dohny1/kicad_libs/3dmodels/_SMD_CON_3D/User Library-SMA_142-0701-851_ASSY.STEP

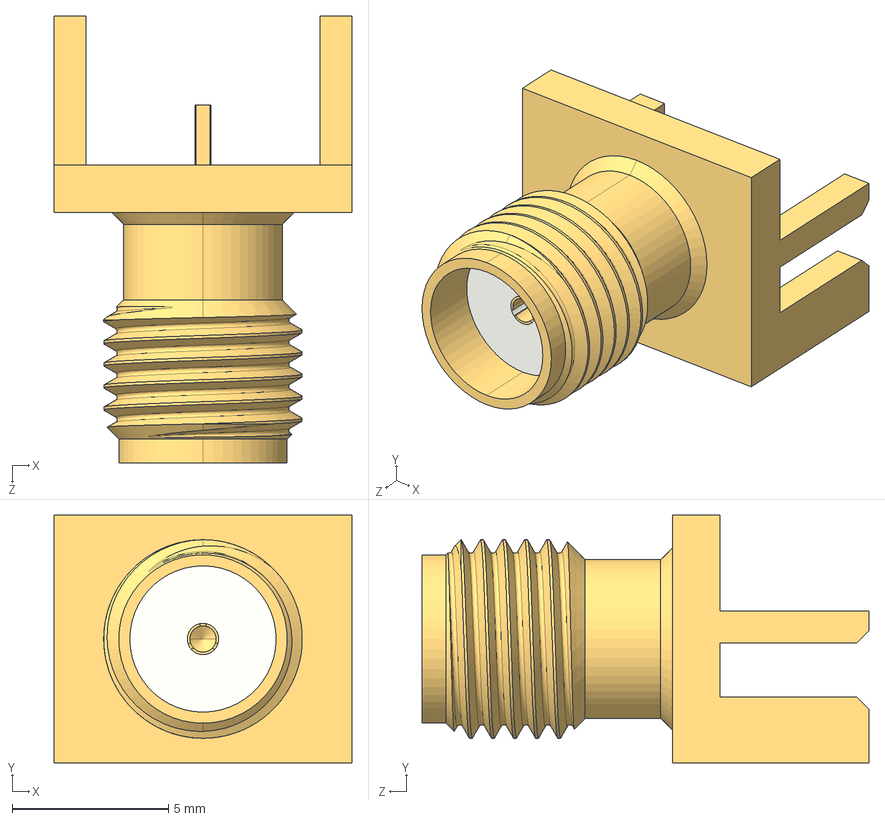
[picture p1: CAD file, 2024-12-15]
3dmodels/_SMD_CON_3D/User Library-SMA_142-0701-851_ASSY.STEP
9.53 x 7.92 x 14.3 mm
BASIC_SMA_142-0701-851
SMA_142-0701-851_INSULATOR
SMA_142-0701-851_CONTACT
