dohny1/kicad_libs/3dmodels/_SMD_SEMI_3D/User Library-IPC QFP-fullQFP50P1200X1200X120-64N MS-026ACD SU-64-2.STEP

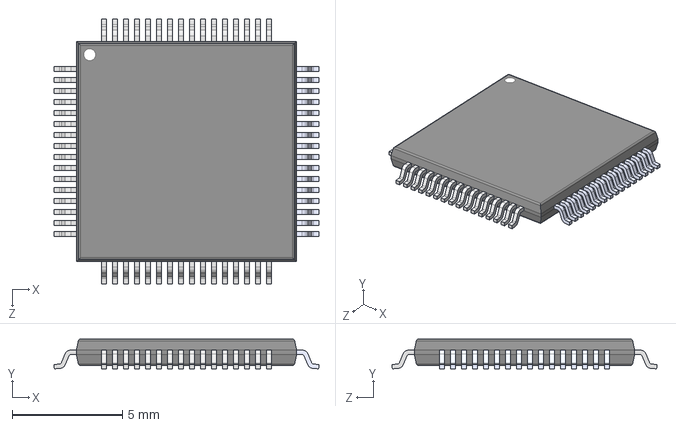
[picture p2: CAD file, 2024-12-15]
3dmodels/_SMD_SEMI_3D/User Library-IPC QFP-fullQFP50P1200X1200X120-64N MS-026ACD SU-64-2.STEP
12.0 x 1.35 x 12.0 mm
