dohny1/kicad_libs/3dmodels/_PASSIVES_3D/Coilcraft-MA5632-AL.STEP

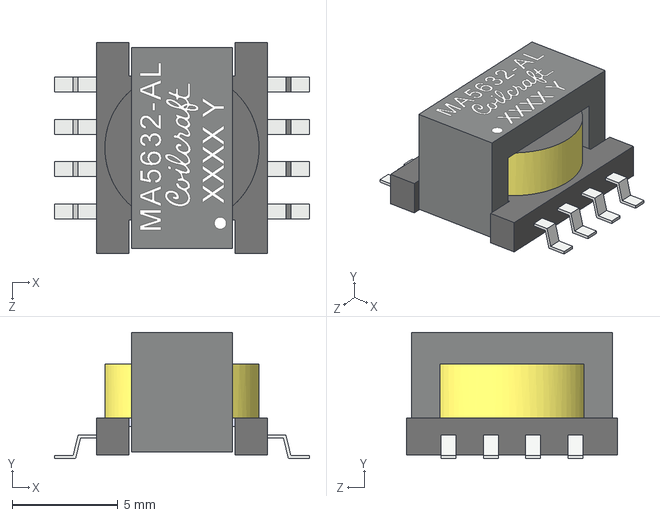
[picture p3: CAD file, 2024-12-15]
3dmodels/_PASSIVES_3D/Coilcraft-MA5632-AL.STEP
12.1 x 5.97 x 10.0 mm
