dohny1/kicad_libs/3dmodels/_SMD_CON_3D/User Library-EVQP7-LC-01P.step

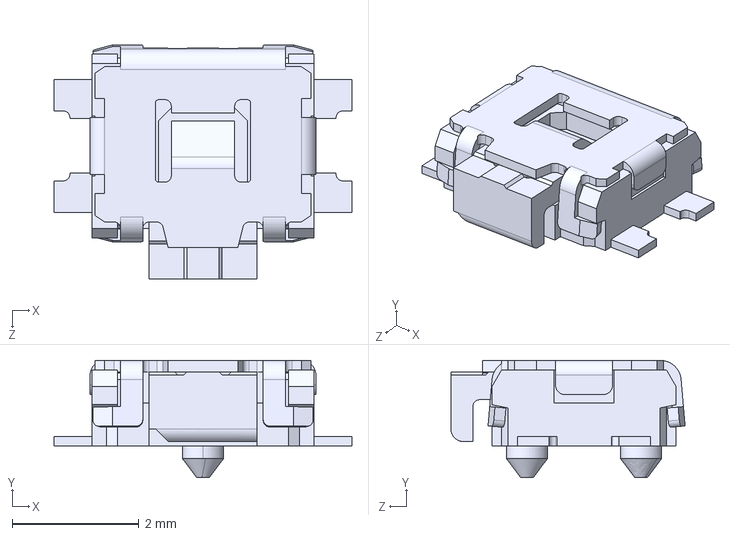
[picture p4: CAD file, 2024-12-15]
3dmodels/_SMD_CON_3D/User Library-EVQP7-LC-01P.step
4.70 x 1.85 x 3.69 mm
