dohny1/kicad_libs/3dmodels/_SMD_SEMI_3D/MSOP12_EP.step

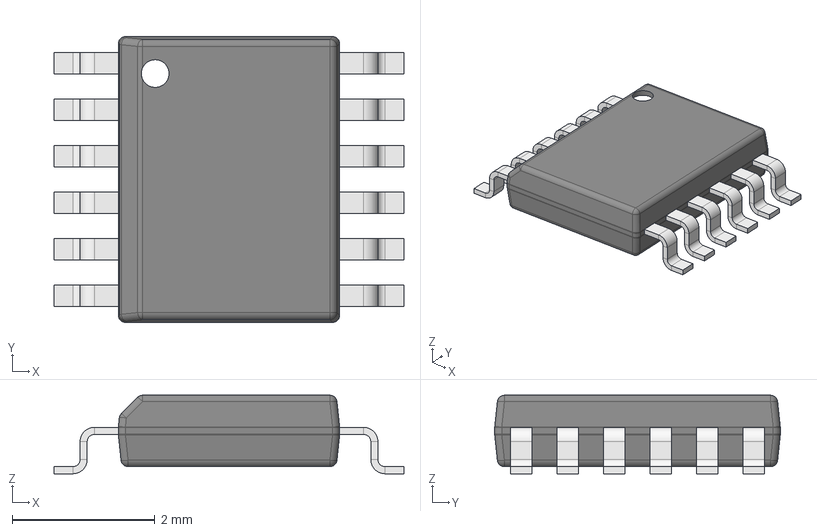
[picture p5: CAD file, 2024-12-15]
3dmodels/_SMD_SEMI_3D/MSOP12_EP.step
4.90 x 4.00 x 1.10 mm
Leader x 12
