dohny1/kicad_libs/3dmodels/_THT_3D/L-25x25.step

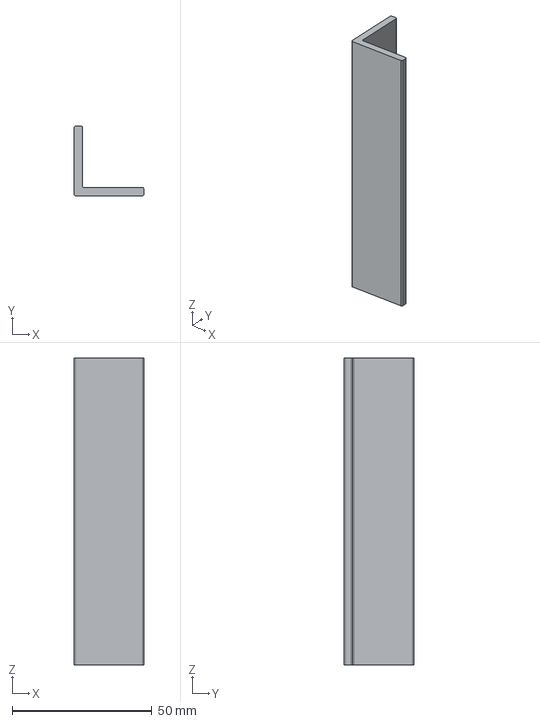
[picture p6: CAD file, 2025-02-05]
3dmodels/_THT_3D/L-25x25.step
25.0 x 25.0 x 110.0 mm
