dohny1/kicad_libs/3dmodels/_THT_CON_3D/User Library-Header_Male_6Pin.STEP

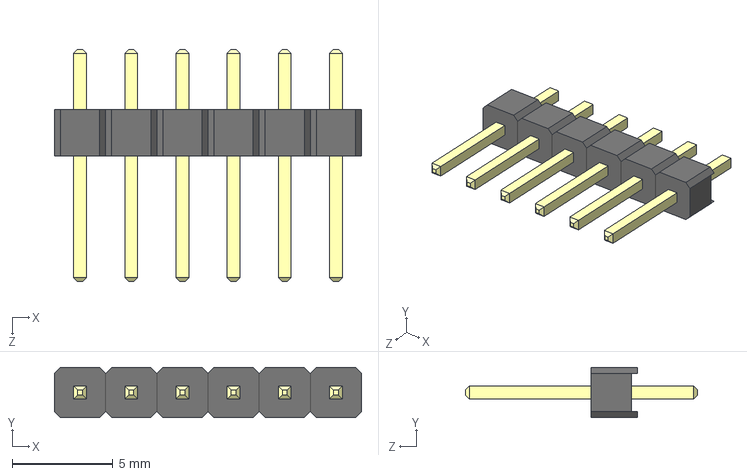
[picture p7: CAD file, 2024-12-15]
3dmodels/_THT_CON_3D/User Library-Header_Male_6Pin.STEP
15.2 x 2.49 x 11.5 mm
PinArray
BodyArray
