dohny1/kicad_libs/3dmodels/_PASSIVES_3D/Ind_Coilcraft_XAL1010-153MED_eec.STEP

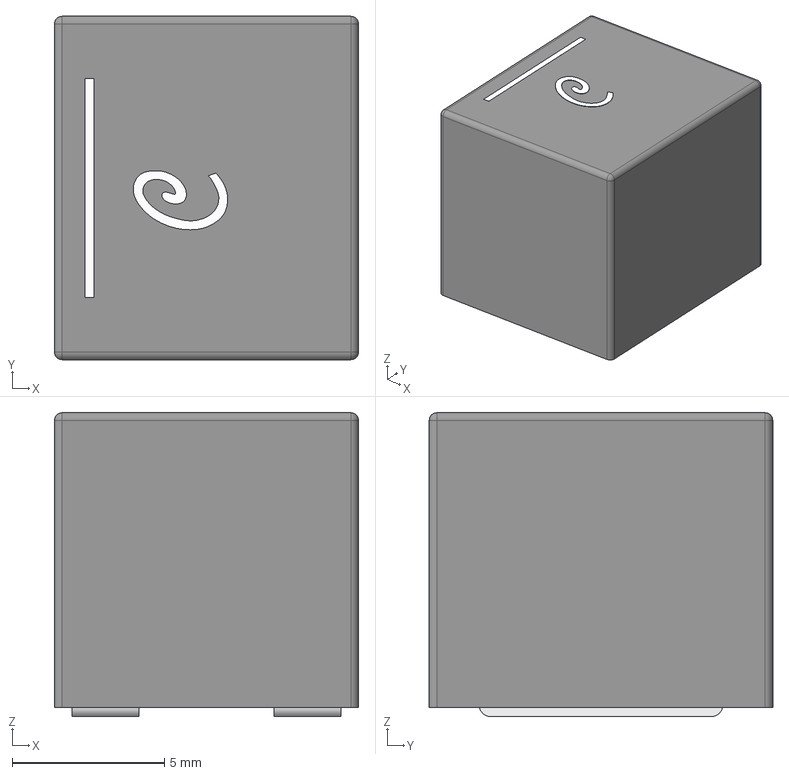
[picture p8: CAD file, 2024-12-15]
3dmodels/_PASSIVES_3D/Ind_Coilcraft_XAL1010-153MED_eec.STEP
10.0 x 11.3 x 10.0 mm
Pins
Mark
Logo
