dohny1/kicad_libs/3dmodels/_SMD_CON_3D/CircuitWorks-DIP SWITCH HALF PITCH SMD X2.step

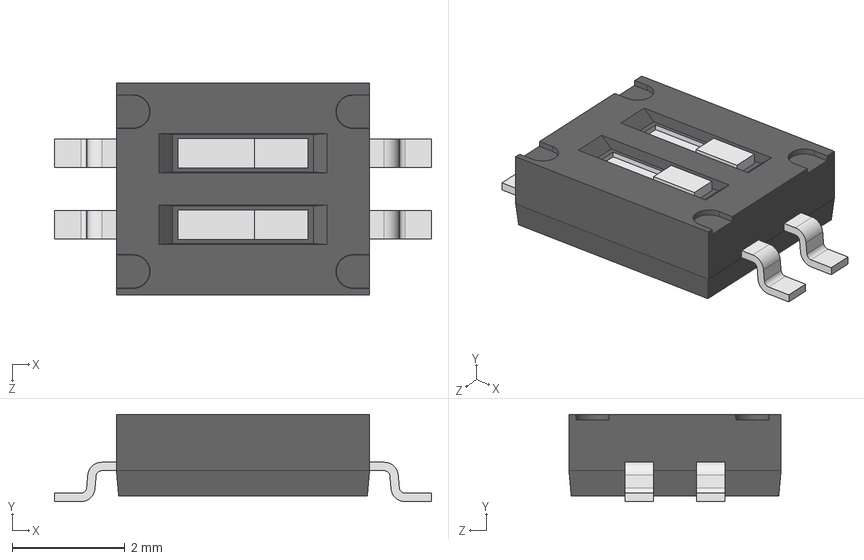
[picture p9: CAD file, 2024-12-15]
3dmodels/_SMD_CON_3D/CircuitWorks-DIP SWITCH HALF PITCH SMD X2.step
6.70 x 1.55 x 3.77 mm
