dohny1/kicad_libs/3dmodels/_SMD_SEMI_3D/BGA400_CLG.step

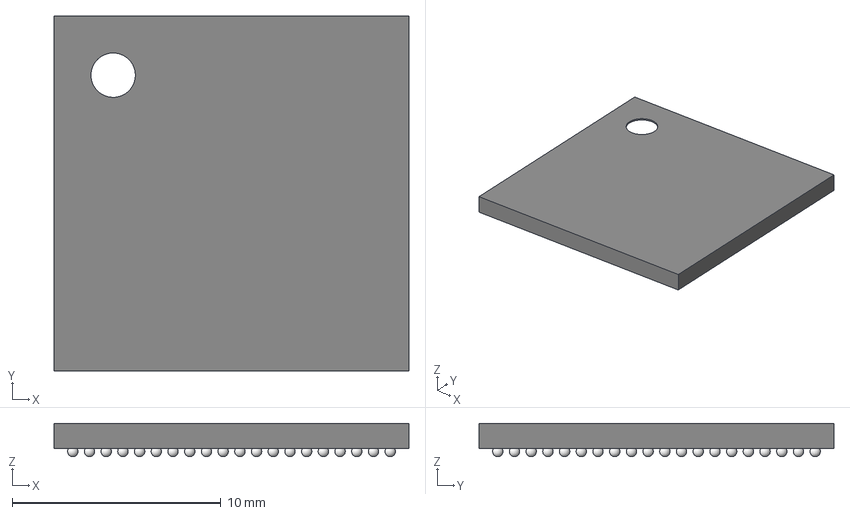
[picture p10: CAD file, 2024-12-15]
3dmodels/_SMD_SEMI_3D/BGA400_CLG.step
17.0 x 17.0 x 1.60 mm
ball x 400
