dohny1/kicad_libs/3dmodels/_THT_3D/TSF-1178Z.STEP

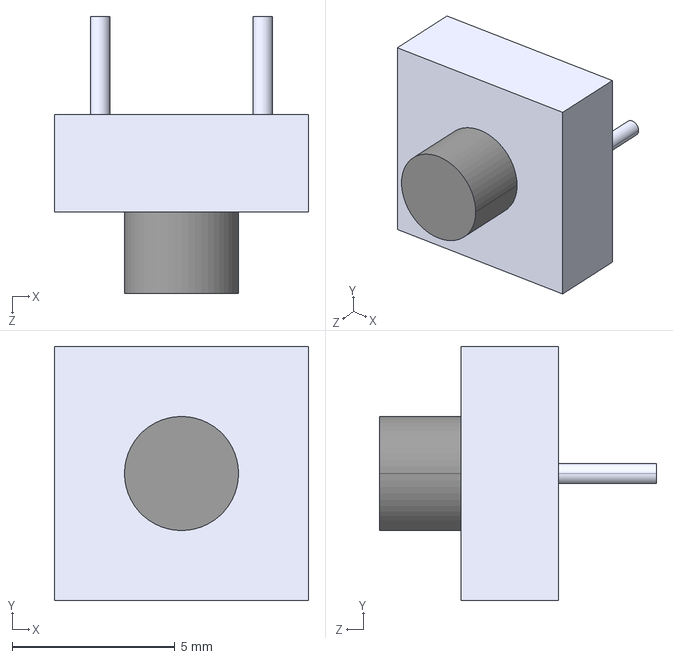
[picture p11: CAD file, 2025-02-05]
3dmodels/_THT_3D/TSF-1178Z.STEP
7.80 x 7.80 x 8.50 mm
