dohny1/kicad_libs/3dmodels/_THT_CON_3D/User Library-PJ-002AH.STEP

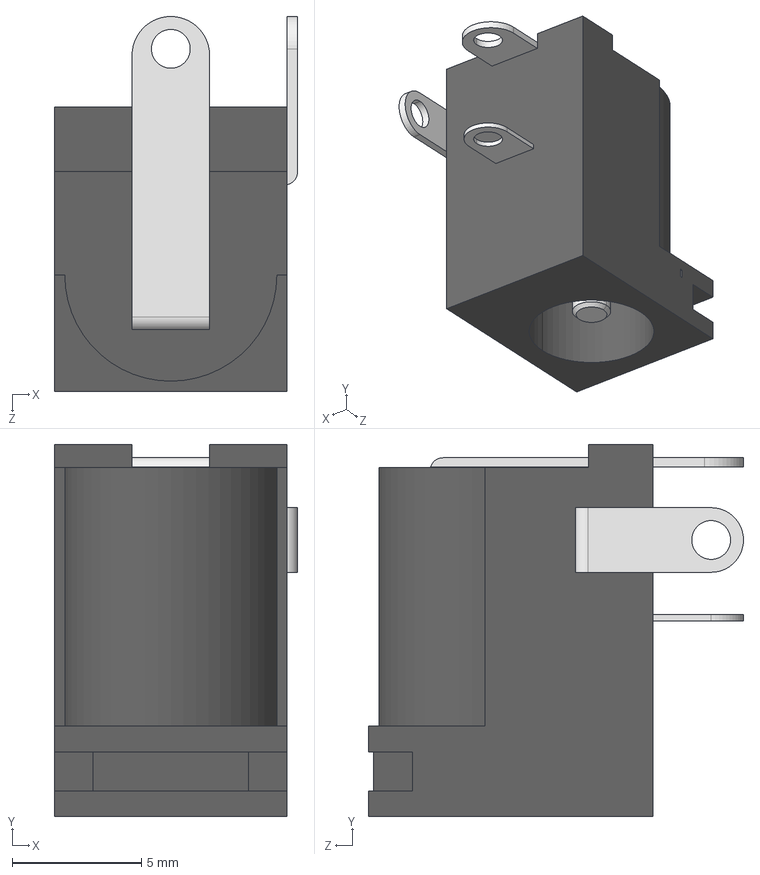
[picture p12: CAD file, 2024-12-15]
3dmodels/_THT_CON_3D/User Library-PJ-002AH.STEP
9.40 x 14.4 x 14.5 mm
User Library-PJ-002AH_Body
User Library-PJ-002AH_Pad
