dohny1/kicad_libs/3dmodels/_PASSIVES_3D/Coilcraft-PA6384-AL.STEP

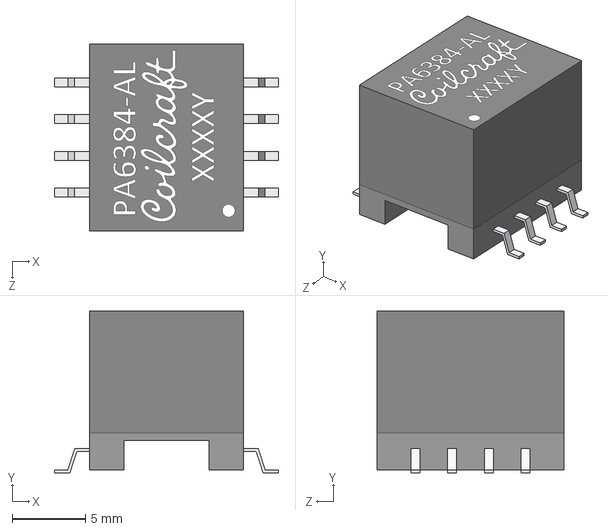
[picture p13: CAD file, 2024-12-15]
3dmodels/_PASSIVES_3D/Coilcraft-PA6384-AL.STEP
15.2 x 11.0 x 12.7 mm
