dohny1/kicad_libs/3dmodels/_SMD_SEMI_3D/QFN14_2.5_2.5.step

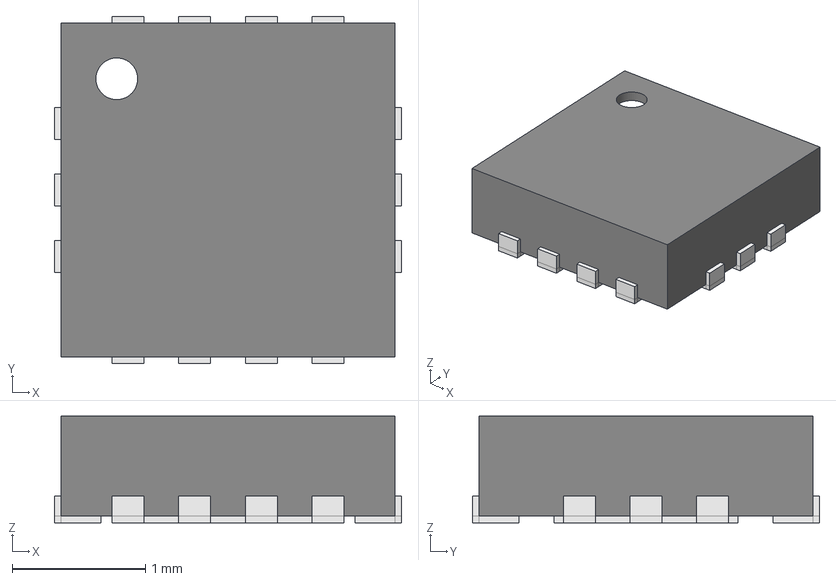
[picture p14: CAD file, 2024-12-15]
3dmodels/_SMD_SEMI_3D/QFN14_2.5_2.5.step
2.60 x 2.60 x 0.8 mm
Thermal Shape
