dohny1/kicad_libs/3dmodels/_THT_3D/D7SEG-0.56.step

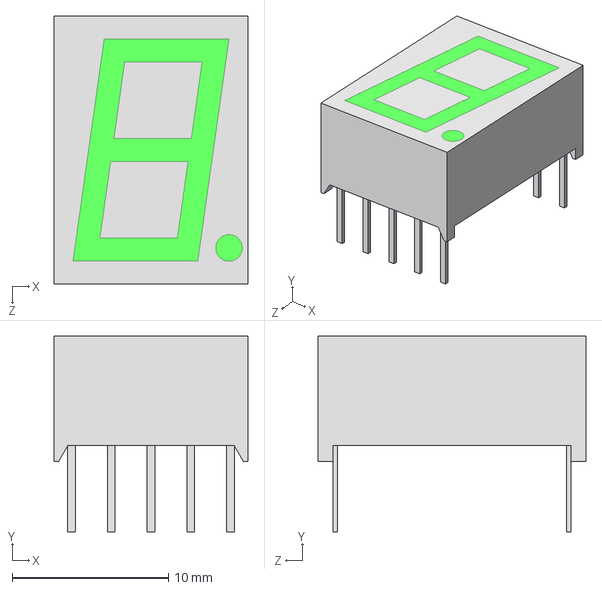
[picture p15: CAD file, 2025-02-05]
3dmodels/_THT_3D/D7SEG-0.56.step
12.4 x 12.5 x 17.1 mm
