dohny1/kicad_libs/3dmodels/_THT_CON_3D/RCA_R1.STEP

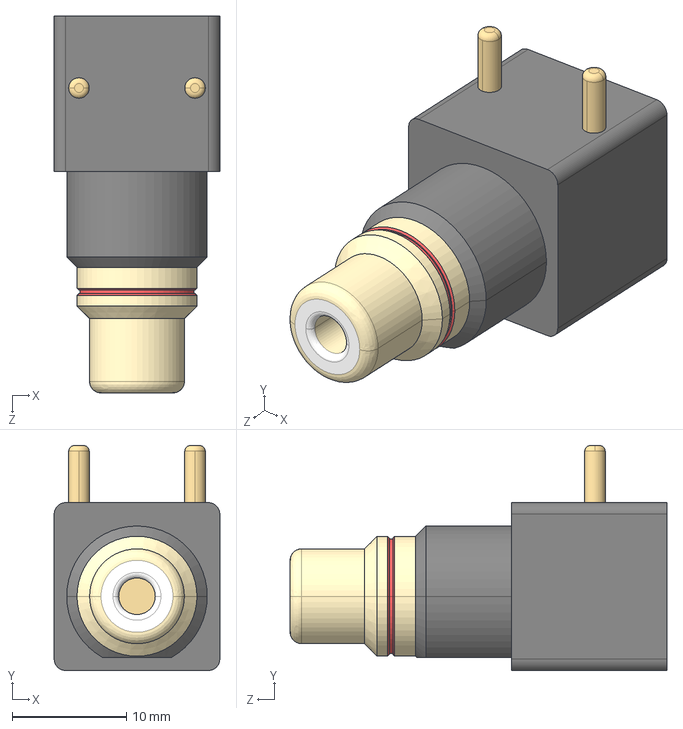
[picture p16: CAD file, 2024-12-15]
3dmodels/_THT_CON_3D/RCA_R1.STEP
14.5 x 19.7 x 33.0 mm
