dohny1/kicad_libs/3dmodels/_PASSIVES_3D/C0402.STEP

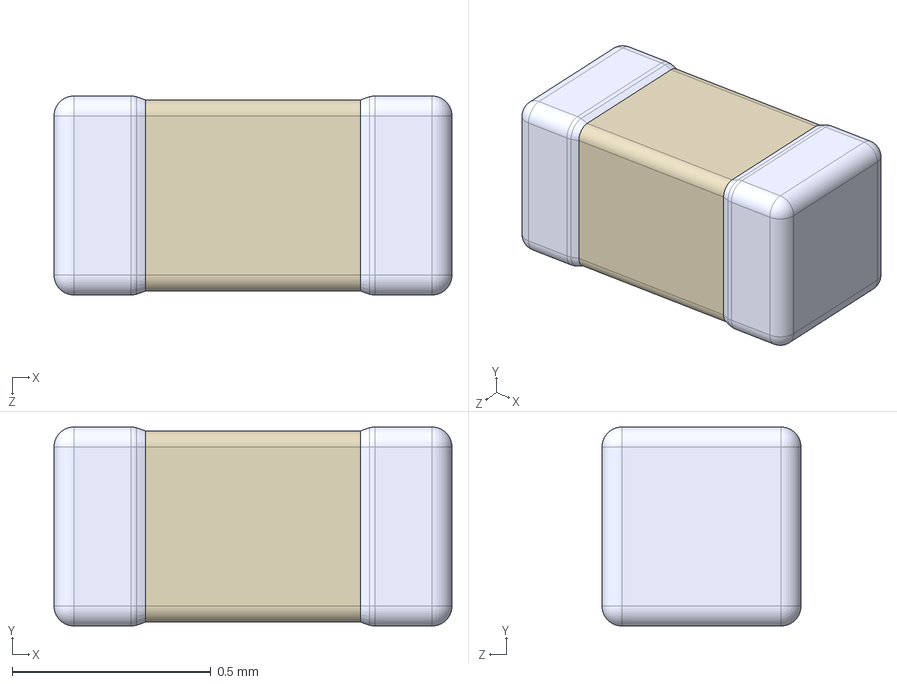
[picture p17: CAD file, 2024-12-15]
3dmodels/_PASSIVES_3D/C0402.STEP
1.00 x 0.5 x 0.5 mm
