dohny1/kicad_libs/3dmodels/_SMD_CON_3D/JST.STEP

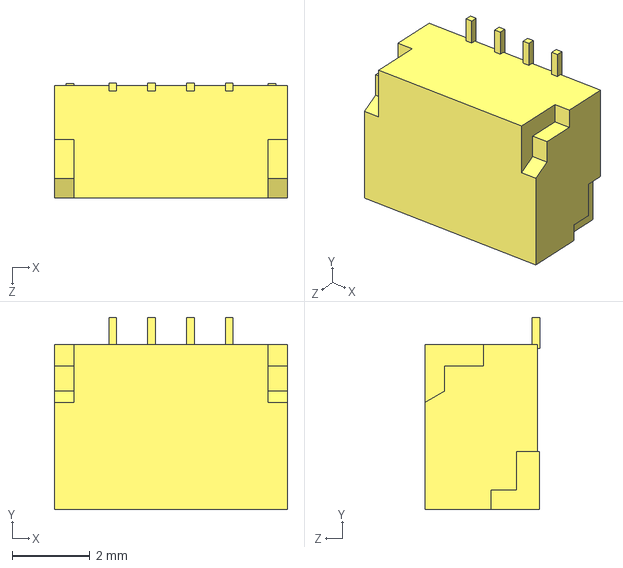
[picture p18: CAD file, 2024-12-15]
3dmodels/_SMD_CON_3D/JST.STEP
6.00 x 4.95 x 2.96 mm
