dohny1/kicad_libs/3dmodels/_SMD_SEMI_3D/User Library-QFN48_7x7.step

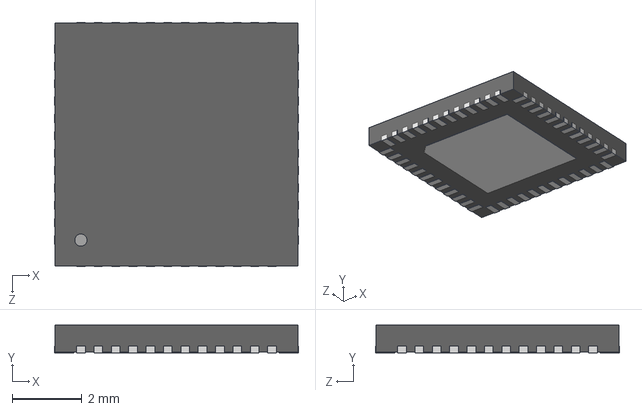
[picture p19: CAD file, 2024-12-15]
3dmodels/_SMD_SEMI_3D/User Library-QFN48_7x7.step
7.02 x 0.8 x 7.02 mm
