dohny1/kicad_libs/3dmodels/_THT_3D/RN102-x-02.stp

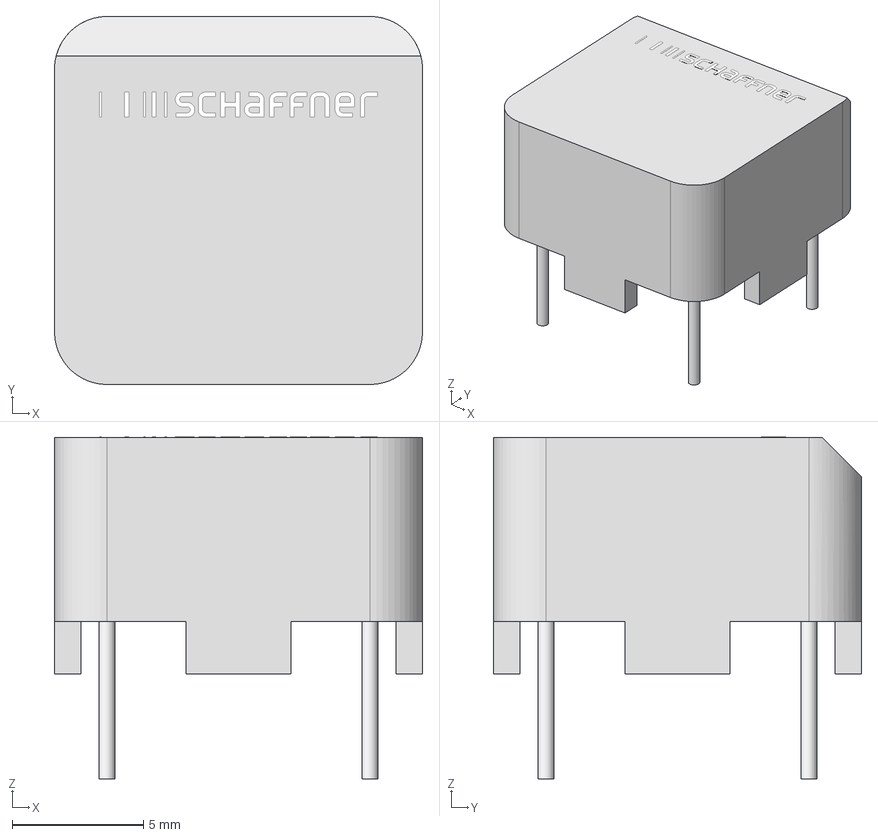
[picture p20: CAD file, 2024-12-25]
3dmodels/_THT_3D/RN102-x-02.stp
14.0 x 14.0 x 13.0 mm
