dohny1/kicad_libs/3dmodels/_THT_CON_3D/molex4pin.STEP

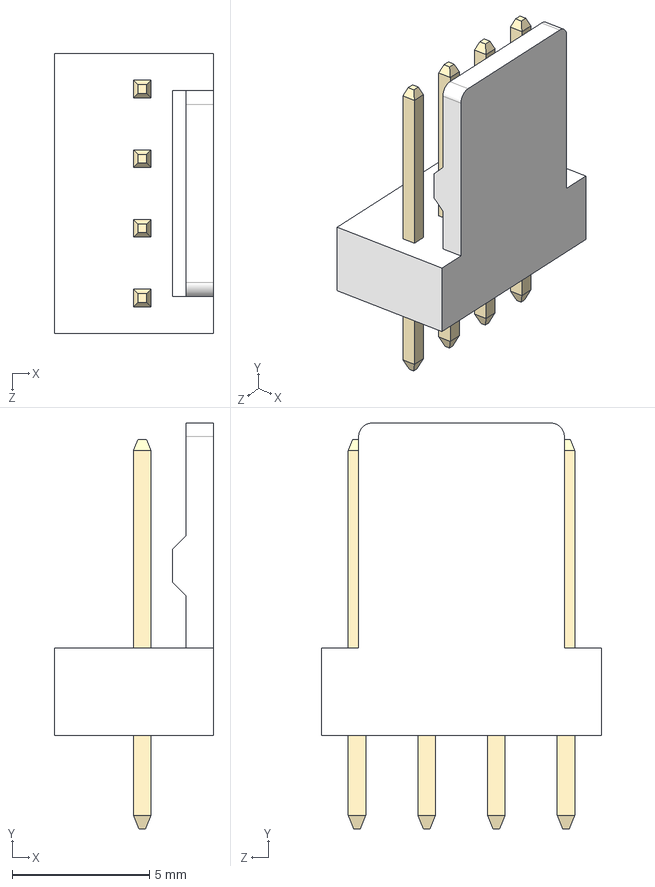
[picture p21: CAD file, 2024-12-15]
3dmodels/_THT_CON_3D/molex4pin.STEP
5.80 x 14.8 x 10.2 mm
molex_lock_4pin
contact x 4
