dohny1/kicad_libs/3dmodels/_PASSIVES_3D/User Library-ZM206.step

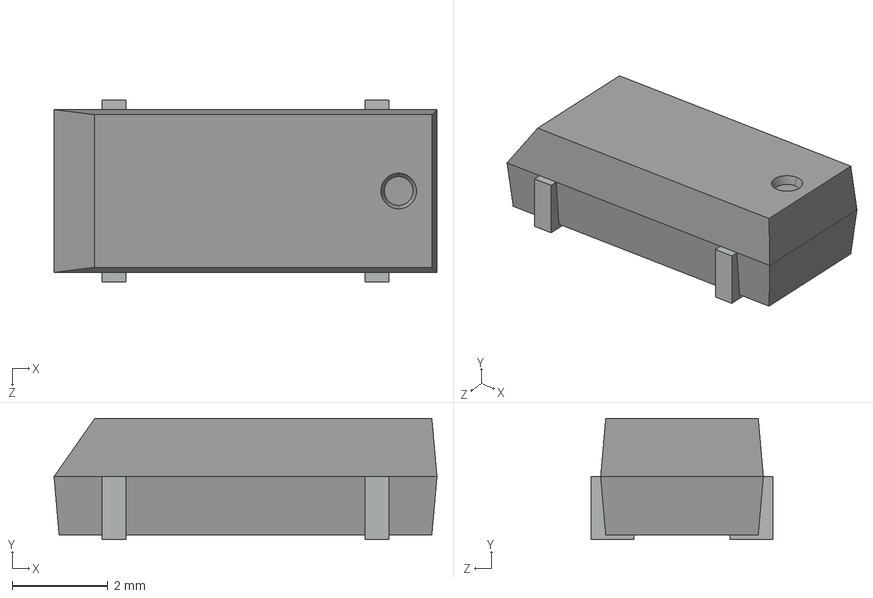
[picture p22: CAD file, 2024-12-15]
3dmodels/_PASSIVES_3D/User Library-ZM206.step
8.00 x 2.53 x 3.80 mm
