dohny1/kicad_libs/3dmodels/_SMD_SEMI_3D/DFN2020-6.STEP

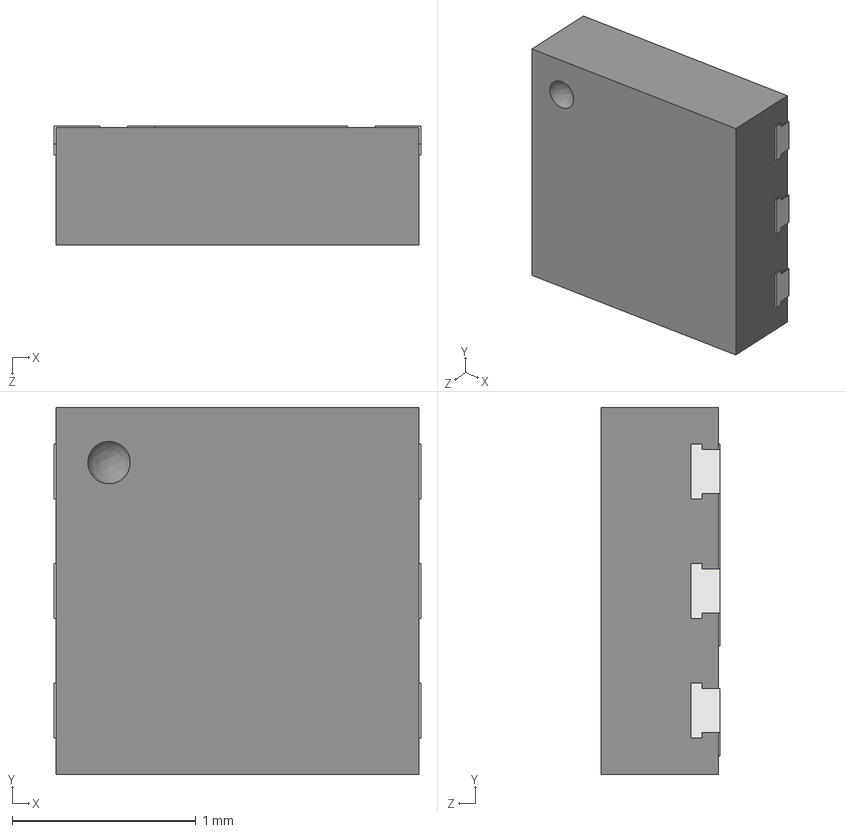
[picture p23: CAD file, 2024-12-15]
3dmodels/_SMD_SEMI_3D/DFN2020-6.STEP
2.00 x 2.00 x 0.65 mm
