dohny1/kicad_libs/3dmodels/_THT_3D/TO-92_A.stp

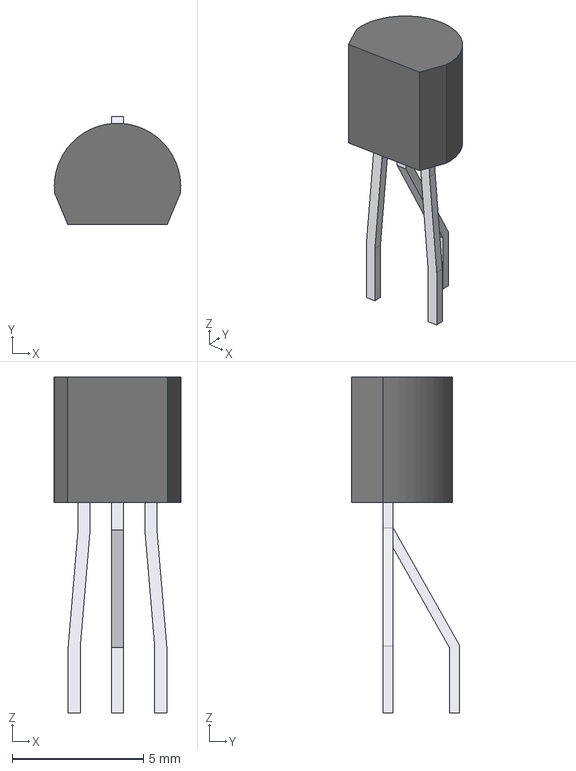
[picture p24: CAD file, 2024-12-15]
3dmodels/_THT_3D/TO-92_A.stp
4.83 x 4.12 x 12.8 mm
