dohny1/kicad_libs/3dmodels/_PASSIVES_3D/R0805_tf.STEP

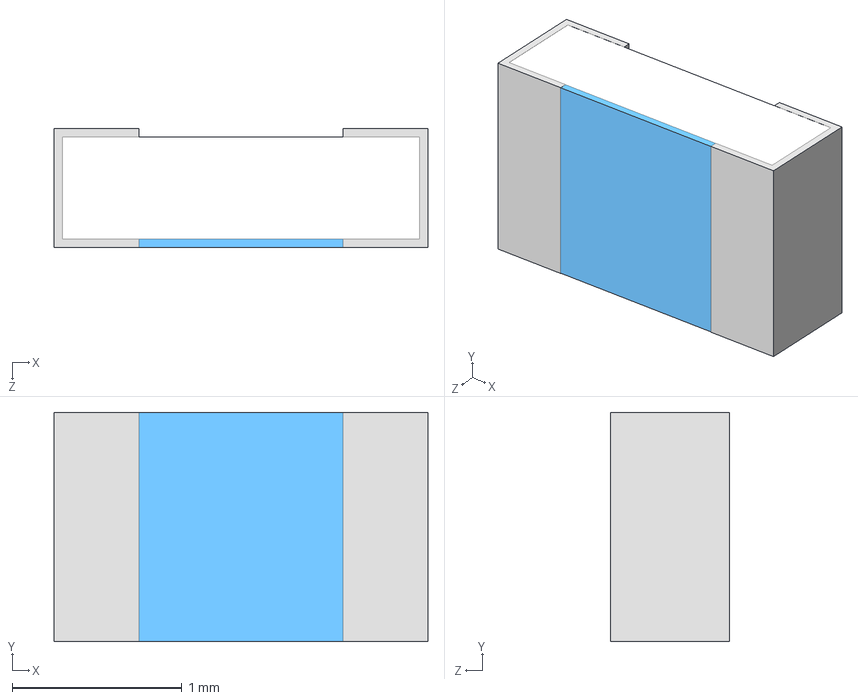
[picture p25: CAD file, 2024-12-15]
3dmodels/_PASSIVES_3D/R0805_tf.STEP
2.20 x 1.35 x 0.7 mm
