dohny1/kicad_libs/3dmodels/_SMD_CON_3D/QTE-020-01-F-D.stp

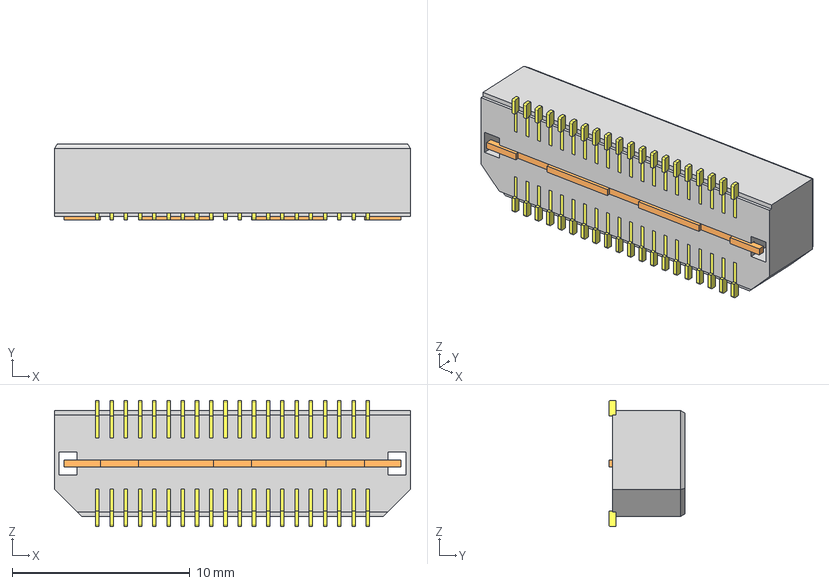
[picture p26: CAD file, 2024-12-15]
3dmodels/_SMD_CON_3D/QTE-020-01-F-D.stp
20.0 x 4.27 x 7.11 mm
_QTE-020-01-F-Dt
_PT-1S39-01(020-01-D)
_QTE-T-1G1-01_imp
