dohny1/kicad_libs/3dmodels/_SMD_SEMI_3D/QFN56_RPi.step

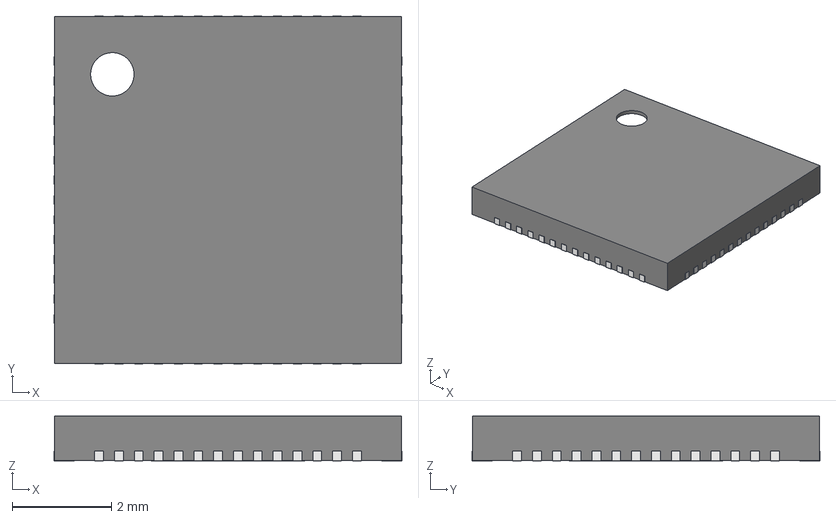
[picture p27: CAD file, 2024-12-15]
3dmodels/_SMD_SEMI_3D/QFN56_RPi.step
7.02 x 7.02 x 0.9 mm
Thermal Shape
