dohny1/kicad_libs/3dmodels/_THT_3D/User Library-DO-35G-30.step

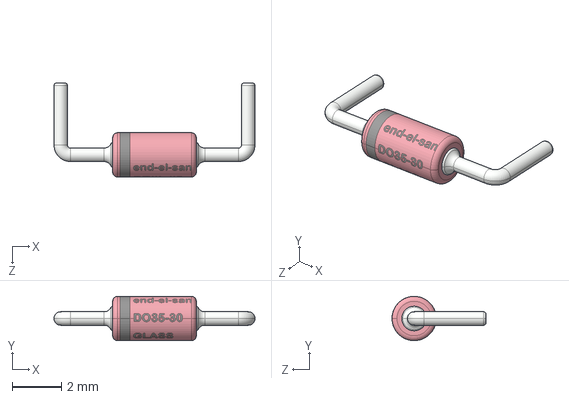
[picture p28: CAD file, 2024-12-15]
3dmodels/_THT_3D/User Library-DO-35G-30.step
8.17 x 1.80 x 3.82 mm
