dohny1/kicad_libs/3dmodels/_THT_CON_3D/PinHeader_2x05_P1.27mm_Vertical.step

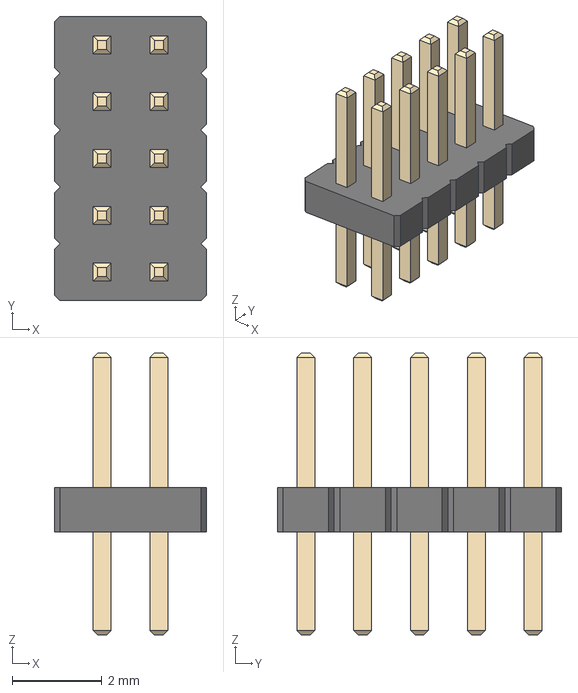
[picture p29: CAD file, 2024-12-15]
3dmodels/_THT_CON_3D/PinHeader_2x05_P1.27mm_Vertical.step
3.40 x 6.35 x 6.30 mm
