dohny1/kicad_libs/3dmodels/_PASSIVES_3D/250-1109 (rev1).STEP

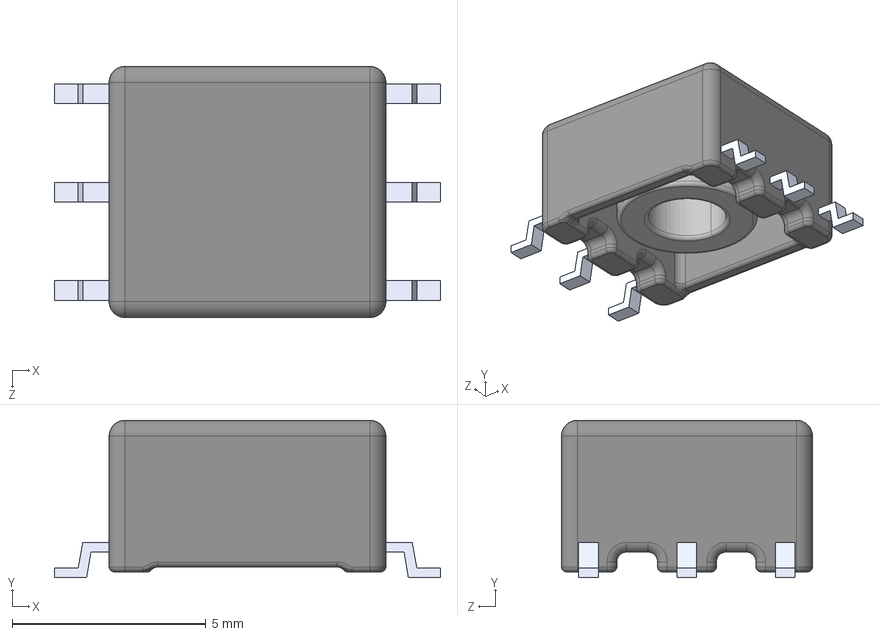
[picture p30: CAD file, 2024-12-15]
3dmodels/_PASSIVES_3D/250-1109 (rev1).STEP
9.96 x 4.06 x 6.48 mm
250-1109_6A
150-2770_6A
