dohny1/kicad_libs/3dmodels/_SMD_CON_3D/usbC_u262-16xn-4bvc11.stp

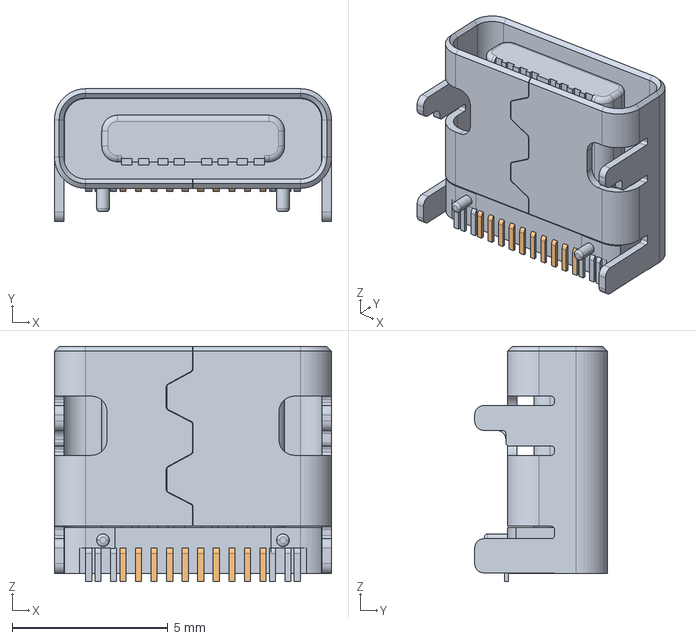
[picture p31: CAD file, 2024-12-15]
3dmodels/_SMD_CON_3D/usbC_u262-16xn-4bvc11.stp
8.90 x 4.26 x 7.56 mm
