dohny1/kicad_libs/3dmodels/_SMD_SEMI_3D/WSON8_6x5.step

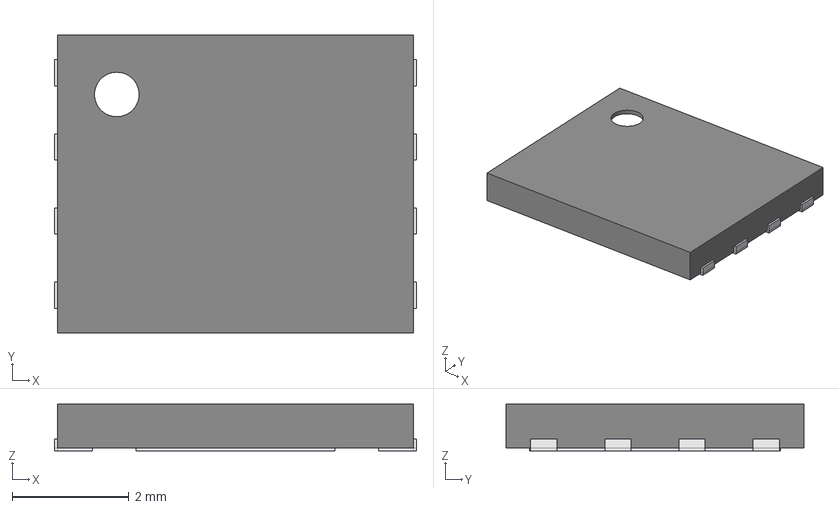
[picture p32: CAD file, 2024-12-15]
3dmodels/_SMD_SEMI_3D/WSON8_6x5.step
6.20 x 5.10 x 0.8 mm
Thermal Shape
