dohny1/kicad_libs/3dmodels/_THT_3D/User Library-Film Capacitor 13x6x12mm.step

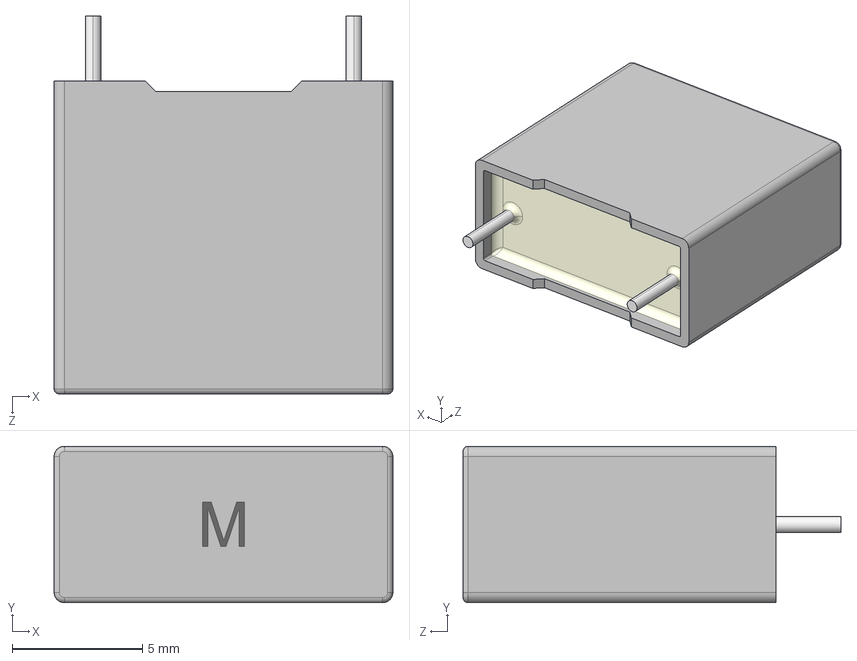
[picture p33: CAD file, 2024-12-15]
3dmodels/_THT_3D/User Library-Film Capacitor 13x6x12mm.step
13.0 x 6.00 x 14.5 mm
