dohny1/kicad_libs/3dmodels/_THT_CON_3D/pxc_1827884_08_MC-1-5-4-GF-3-81_3D.stp

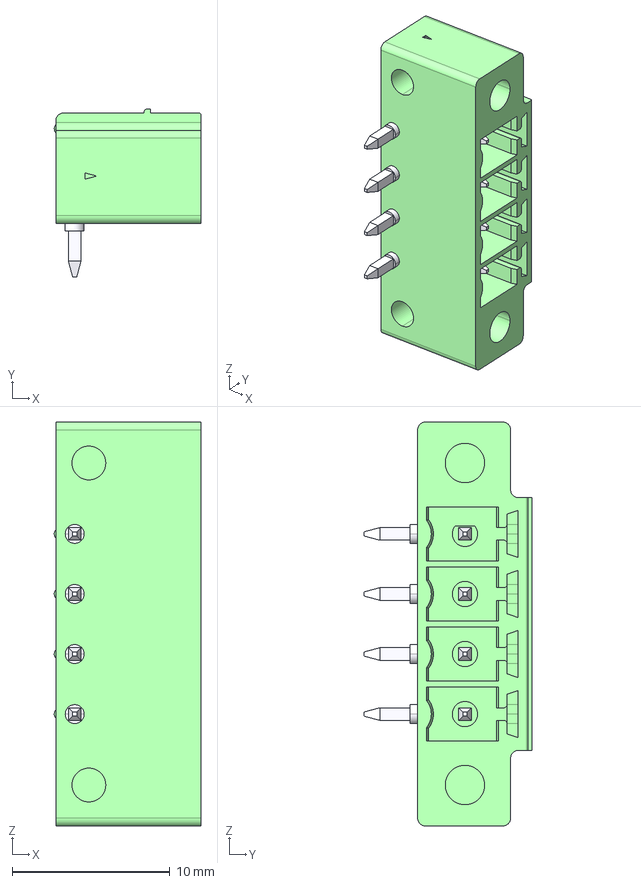
[picture p34: CAD file, 2024-12-15]
3dmodels/_THT_CON_3D/pxc_1827884_08_MC-1-5-4-GF-3-81_3D.stp
9.30 x 10.7 x 25.6 mm
