dohny1/kicad_libs/3dmodels/_PASSIVES_3D/Coilcraft-0603HP.step

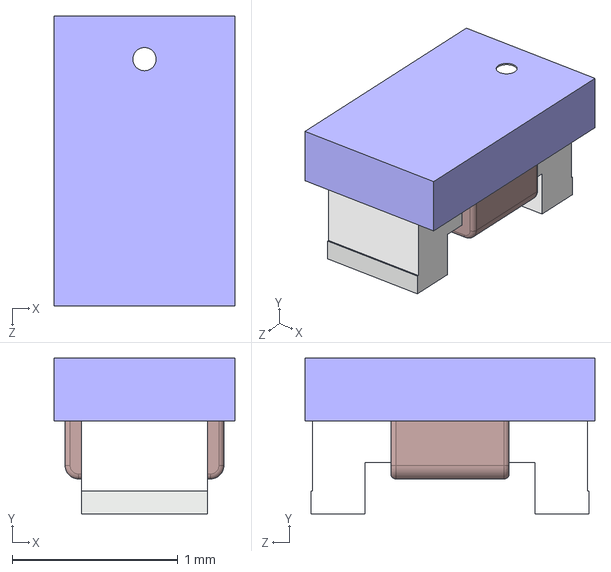
[picture p35: CAD file, 2024-12-15]
3dmodels/_PASSIVES_3D/Coilcraft-0603HP.step
1.09 x 0.94 x 1.75 mm
