dohny1/kicad_libs/3dmodels/_SMD_SEMI_3D/TSSOP30.step

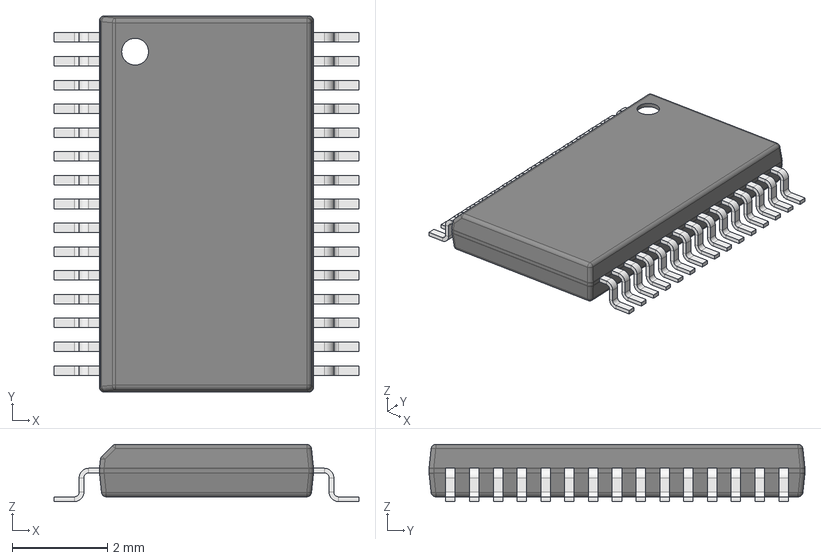
[picture p36: CAD file, 2024-12-15]
3dmodels/_SMD_SEMI_3D/TSSOP30.step
6.40 x 7.90 x 1.20 mm
Leader x 30
