dohny1/kicad_libs/3dmodels/_THT_3D/RES1016-720X250.stp

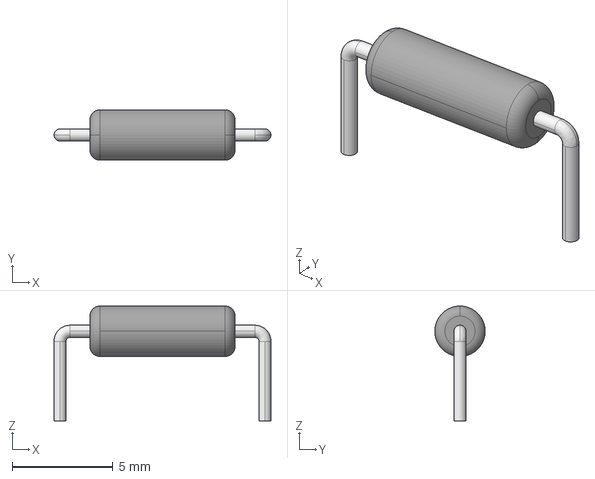
[picture p37: CAD file, 2024-12-15]
3dmodels/_THT_3D/RES1016-720X250.stp
10.8 x 2.50 x 5.70 mm
