dohny1/kicad_libs/3dmodels/_THT_CON_3D/molex2pin.STEP

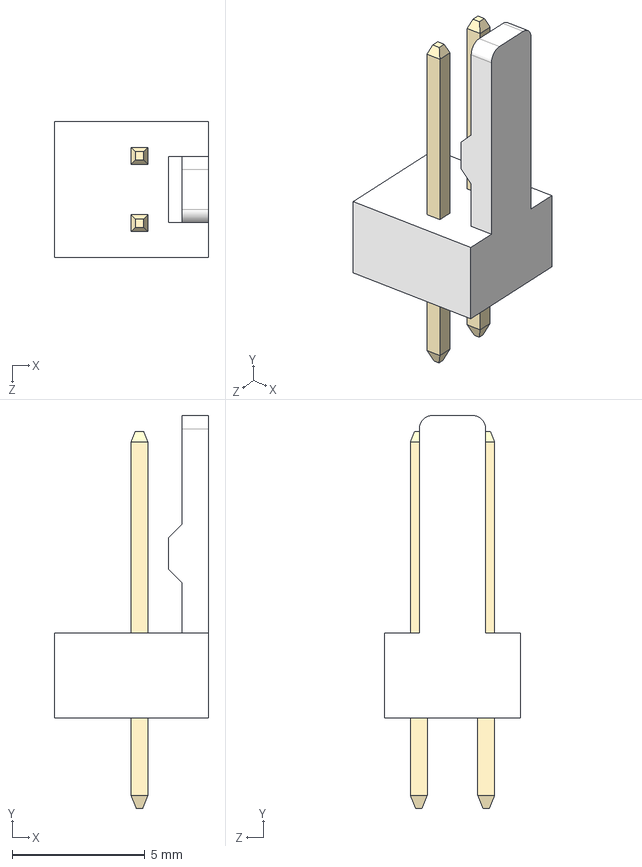
[picture p38: CAD file, 2024-12-15]
3dmodels/_THT_CON_3D/molex2pin.STEP
5.80 x 14.8 x 5.12 mm
molex_lock_2pin
contact x 2
