dohny1/kicad_libs/3dmodels/_PASSIVES_3D/RES 0603 (1608 metric).STEP

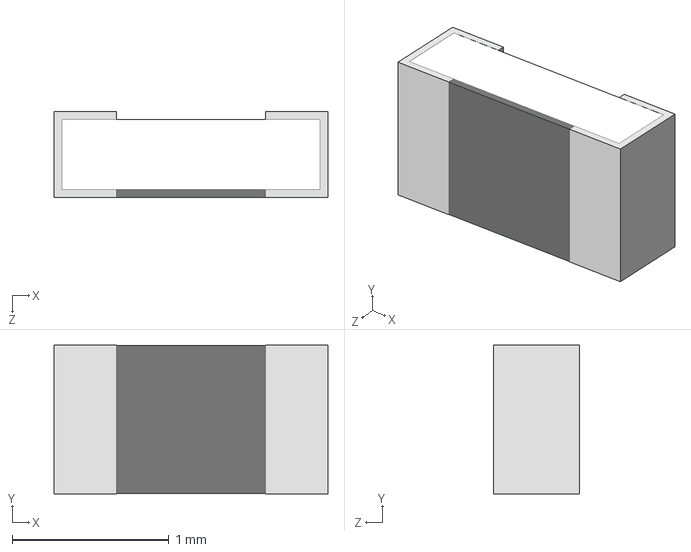
[picture p39: CAD file, 2024-12-15]
3dmodels/_PASSIVES_3D/RES 0603 (1608 metric).STEP
1.75 x 0.95 x 0.55 mm
