dohny1/kicad_libs/3dmodels/_SMD_CON_3D/User Library-JST - SM06B-SRSS-TB (SH SERIES - 1_0mm PITCH WIRE-TO-BOARD, SMT, RA).step

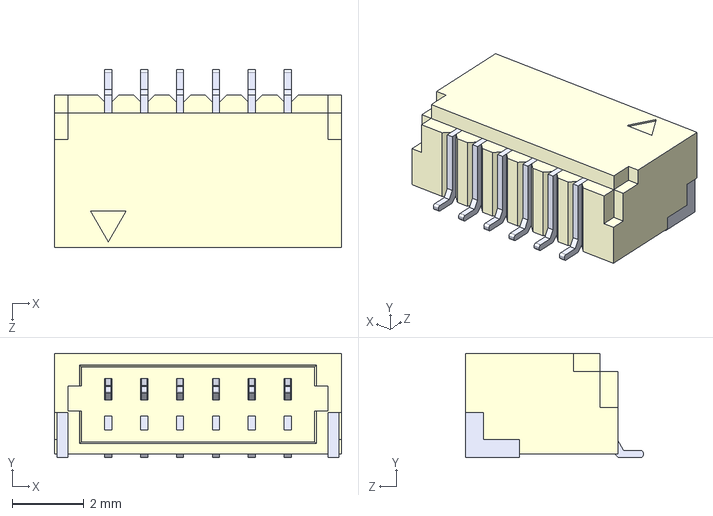
[picture p40: CAD file, 2024-12-15]
3dmodels/_SMD_CON_3D/User Library-JST - SM06B-SRSS-TB (SH SERIES - 1_0mm PITCH WIRE-TO-BOARD, SMT, RA).step
8.00 x 2.90 x 4.95 mm
