dohny1/kicad_libs/3dmodels/_SMD_SEMI_3D/User Library-QFN64-2.step

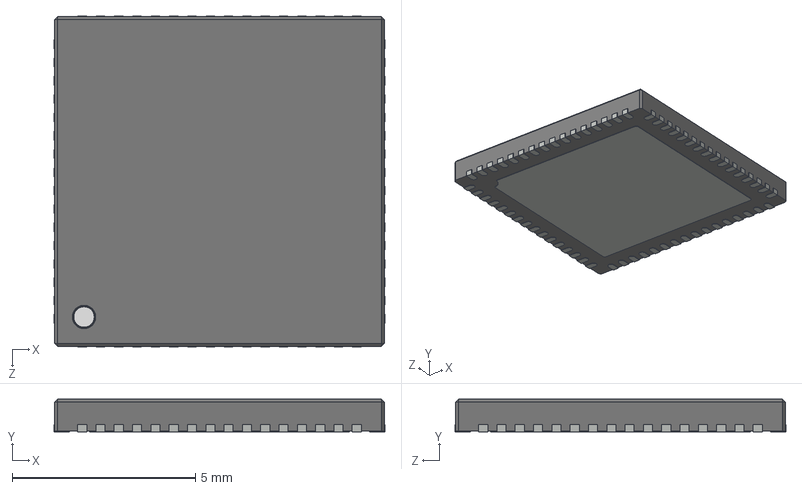
[picture p41: CAD file, 2024-12-15]
3dmodels/_SMD_SEMI_3D/User Library-QFN64-2.step
9.04 x 0.9 x 9.04 mm
