dohny1/kicad_libs/3dmodels/_THT_3D/User Library-CAPRR500W50L720T850H1000_WIMA_1L.STEP

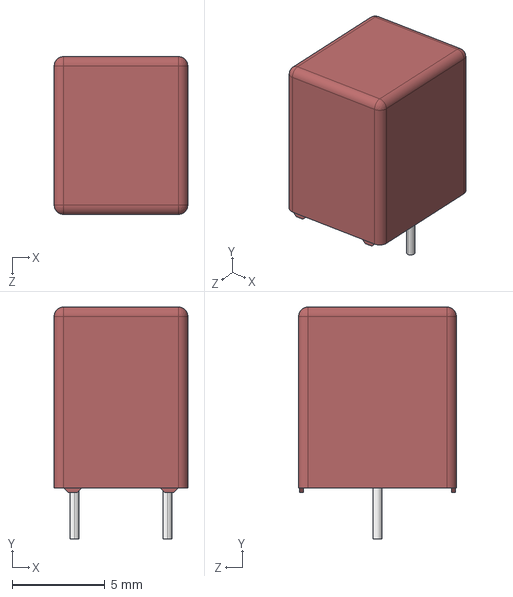
[picture p42: CAD file, 2024-12-15]
3dmodels/_THT_3D/User Library-CAPRR500W50L720T850H1000_WIMA_1L.STEP
7.20 x 12.5 x 8.50 mm
User Library-CAPRR500W50L720T850H1000_WIMA_1L_Body
User Library-CAPRR500W50L720T850H1000_WIMA_1L_Lead x 2
