dohny1/kicad_libs/3dmodels/_PASSIVES_3D/User Library-MWSA0503S.STEP

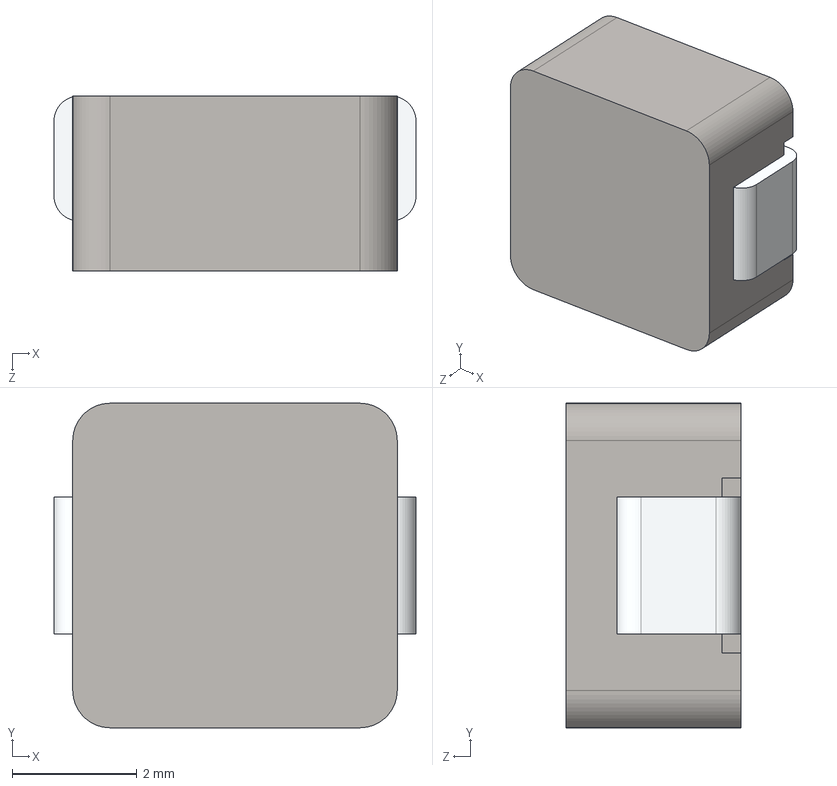
[picture p43: CAD file, 2024-12-15]
3dmodels/_PASSIVES_3D/User Library-MWSA0503S.STEP
5.80 x 5.20 x 2.80 mm
MWSA0503S-HOUSE
MWSA0503S-PIN
