dohny1/kicad_libs/3dmodels/_SMD_SEMI_3D/MSOP16_TP.step

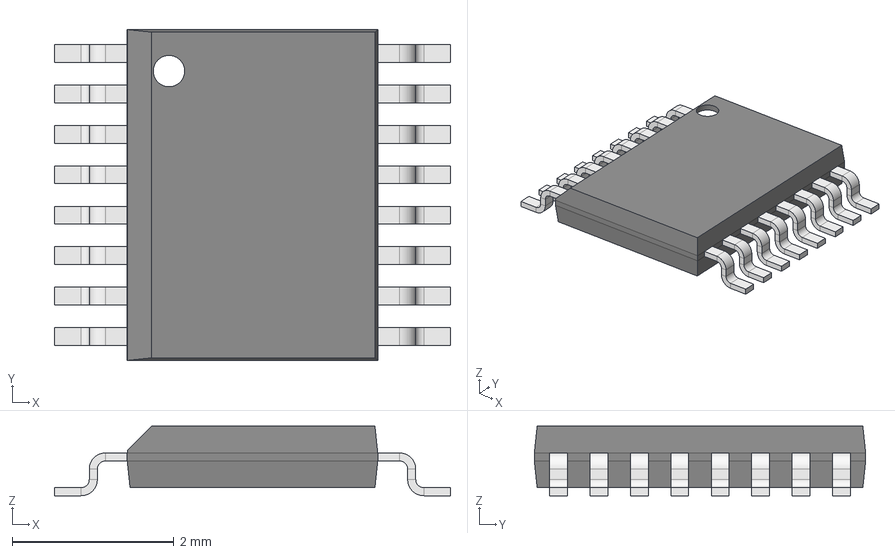
[picture p44: CAD file, 2024-12-15]
3dmodels/_SMD_SEMI_3D/MSOP16_TP.step
4.90 x 4.10 x 0.86 mm
Leader x 16
