dohny1/kicad_libs/3dmodels/_THT_3D/User Library-Capacitor no pol axial 0_4in pitch.step

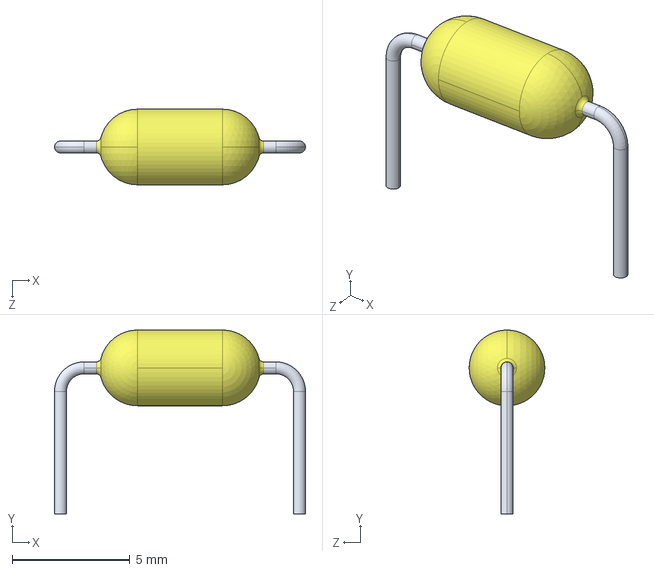
[picture p45: CAD file, 2024-12-15]
3dmodels/_THT_3D/User Library-Capacitor no pol axial 0_4in pitch.step
10.7 x 7.82 x 3.22 mm
