dohny1/kicad_libs/3dmodels/_THT_CON_3D/RS-409-gold.step

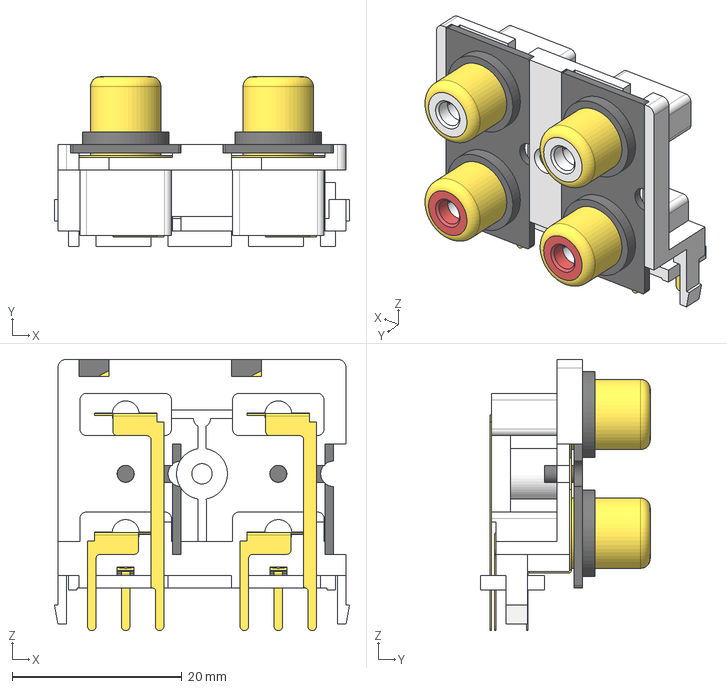
[picture p46: CAD file, 2024-12-15]
3dmodels/_THT_CON_3D/RS-409-gold.step
34.8 x 20.0 x 32.0 mm
