dohny1/kicad_libs/3dmodels/_PASSIVES_3D/C0201.STEP

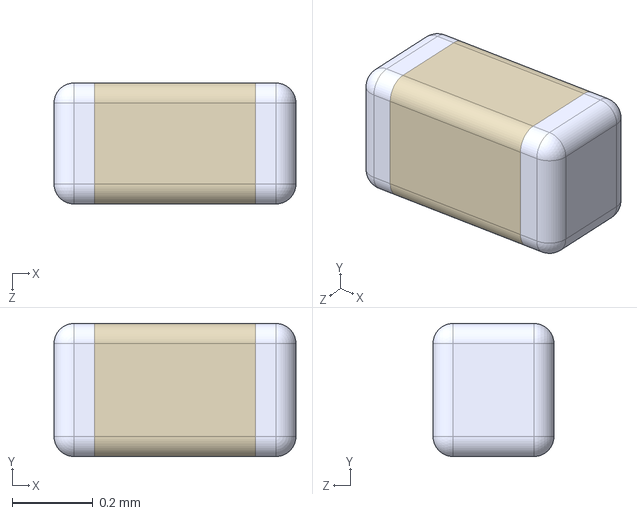
[picture p47: CAD file, 2024-12-15]
3dmodels/_PASSIVES_3D/C0201.STEP
0.6 x 0.33 x 0.3 mm
