dohny1/kicad_libs/3dmodels/_SMD_SEMI_3D/User Library-SC70-5-1.step

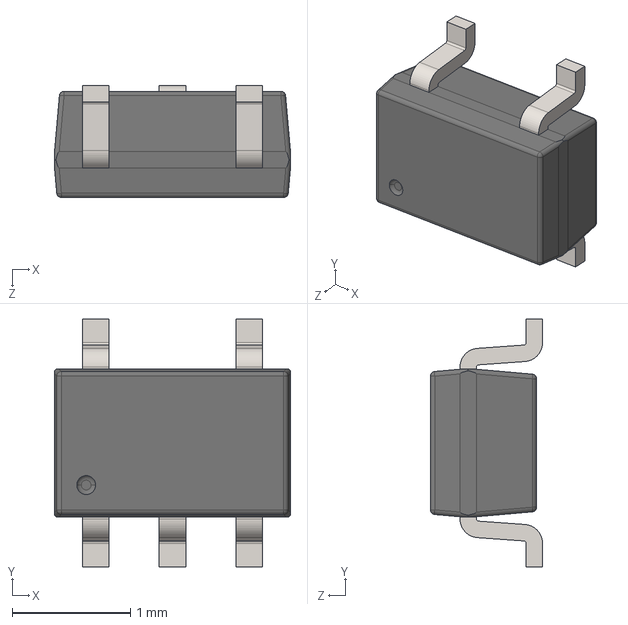
[picture p48: CAD file, 2024-12-15]
3dmodels/_SMD_SEMI_3D/User Library-SC70-5-1.step
2.00 x 2.10 x 0.95 mm
