dohny1/kicad_libs/3dmodels/_THT_3D/User Library-R-Axial-0_25W-7_62.step

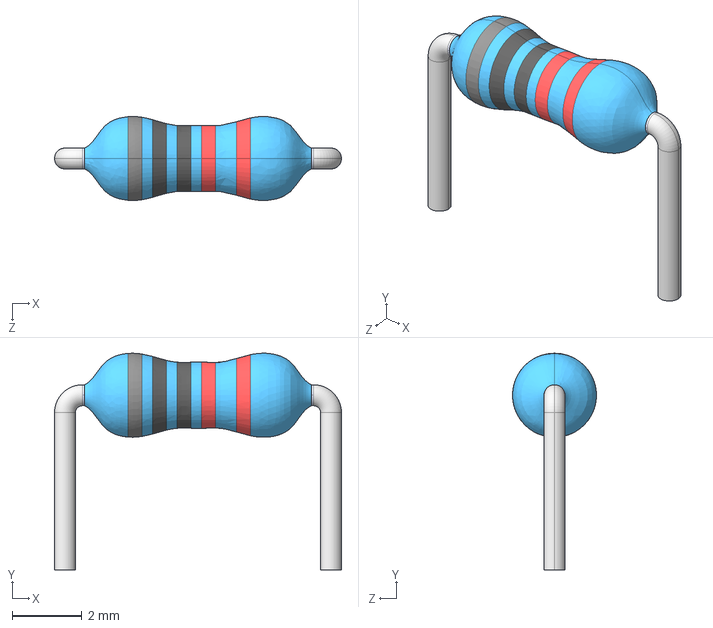
[picture p49: CAD file, 2024-12-15]
3dmodels/_THT_3D/User Library-R-Axial-0_25W-7_62.step
8.22 x 6.20 x 2.41 mm
