dohny1/kicad_libs/3dmodels/_PASSIVES_3D/CAPMP3216X180N.STEP

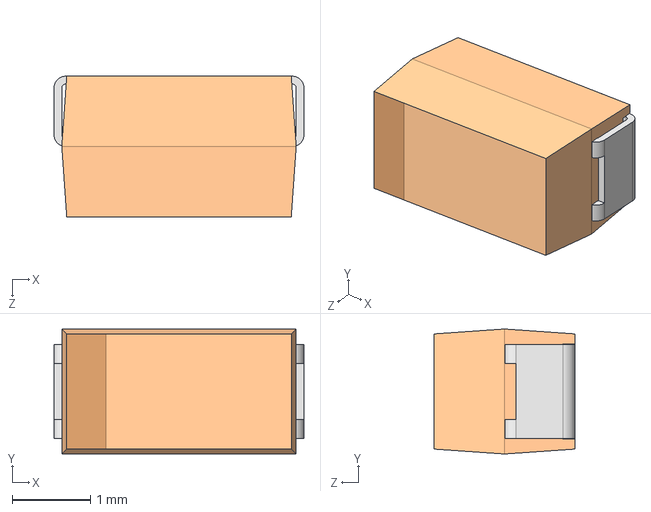
[picture p50: CAD file, 2024-12-15]
3dmodels/_PASSIVES_3D/CAPMP3216X180N.STEP
3.20 x 1.60 x 1.80 mm
