dohny1/kicad_libs/3dmodels/_SMD_SEMI_3D/BGA49.step

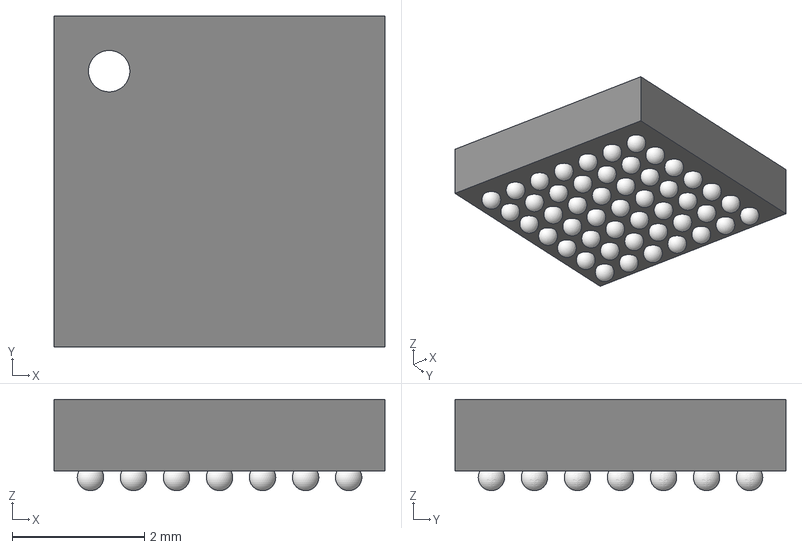
[picture p51: CAD file, 2024-12-15]
3dmodels/_SMD_SEMI_3D/BGA49.step
5.00 x 5.00 x 1.38 mm
ball x 49
