dohny1/kicad_libs/3dmodels/_THT_3D/User Library-CE_R100_D200_H460.step

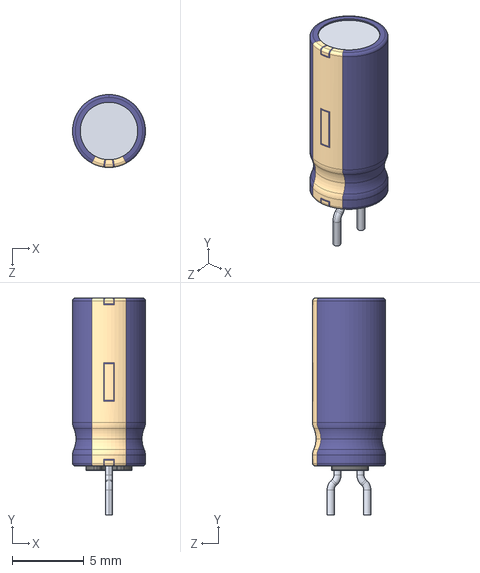
[picture p52: CAD file, 2024-12-15]
3dmodels/_THT_3D/User Library-CE_R100_D200_H460.step
5.08 x 15.1 x 5.08 mm
