dohny1/kicad_libs/3dmodels/_THT_CON_3D/pjras1x1s_series.STEP

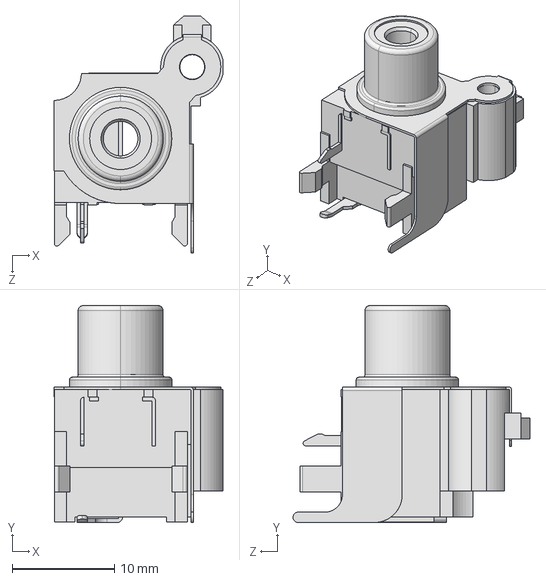
[picture p53: CAD file, 2024-12-15]
3dmodels/_THT_CON_3D/pjras1x1s_series.STEP
16.5 x 21.2 x 23.2 mm
