dohny1/kicad_libs/3dmodels/_PASSIVES_3D/User Library-fuse smd-1.step

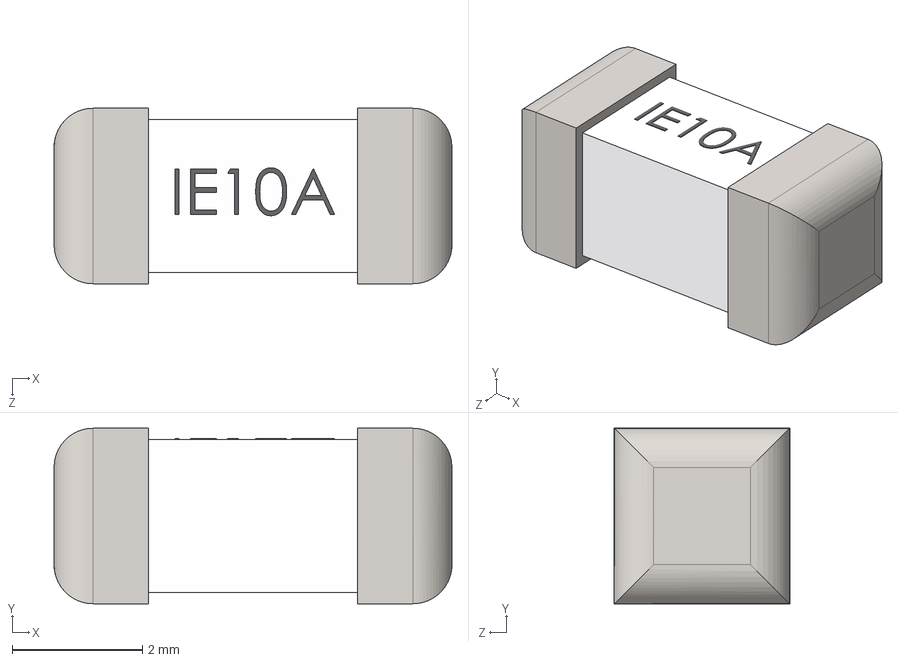
[picture p54: CAD file, 2024-12-15]
3dmodels/_PASSIVES_3D/User Library-fuse smd-1.step
6.10 x 2.69 x 2.69 mm
