dohny1/kicad_libs/3dmodels/_SMD_SEMI_3D/DFN2020B-3.STEP

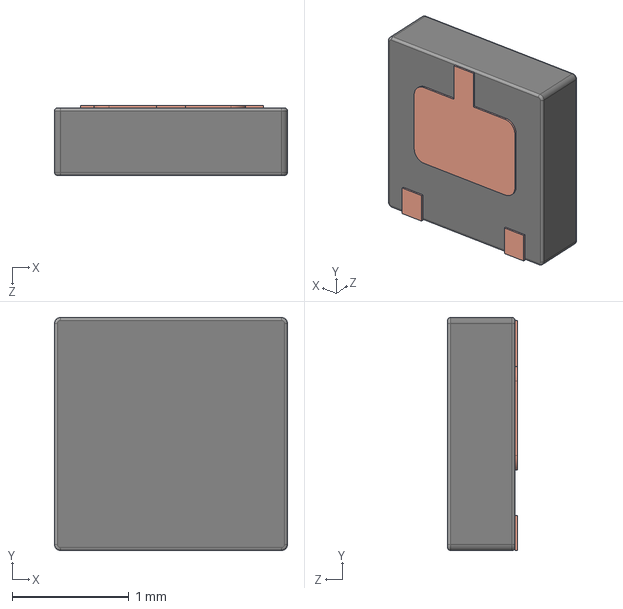
[picture p55: CAD file, 2024-12-15]
3dmodels/_SMD_SEMI_3D/DFN2020B-3.STEP
2.00 x 2.00 x 0.6 mm
