dohny1/kicad_libs/3dmodels/_THT_3D/User Library-CAPRR250W40L460T460H900_WIMA_0E.STEP

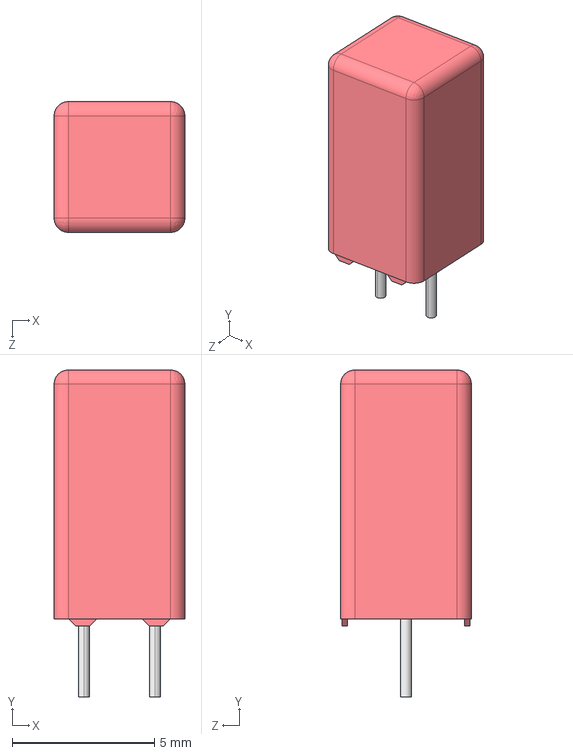
[picture p56: CAD file, 2024-12-15]
3dmodels/_THT_3D/User Library-CAPRR250W40L460T460H900_WIMA_0E.STEP
4.60 x 11.5 x 4.60 mm
Lead x 2
