dohny1/kicad_libs/3dmodels/_THT_CON_3D/CUI_DEVICES_SJ-63043H.step

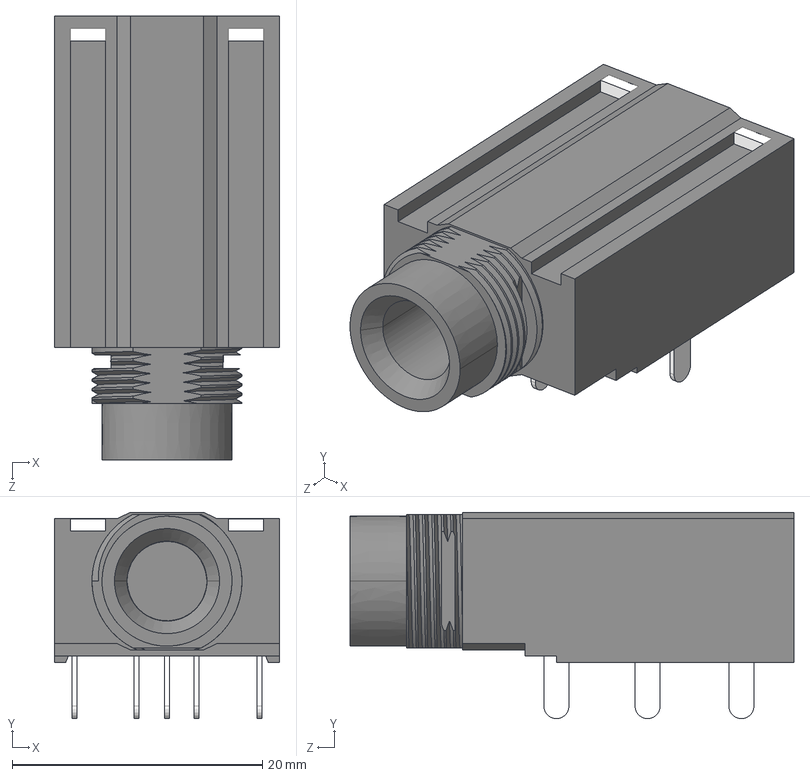
[picture p57: CAD file, 2024-12-15]
3dmodels/_THT_CON_3D/CUI_DEVICES_SJ-63043H.step
18.0 x 16.5 x 35.5 mm
