dohny1/kicad_libs/3dmodels/_PASSIVES_3D/User Library-SM2520-4.step

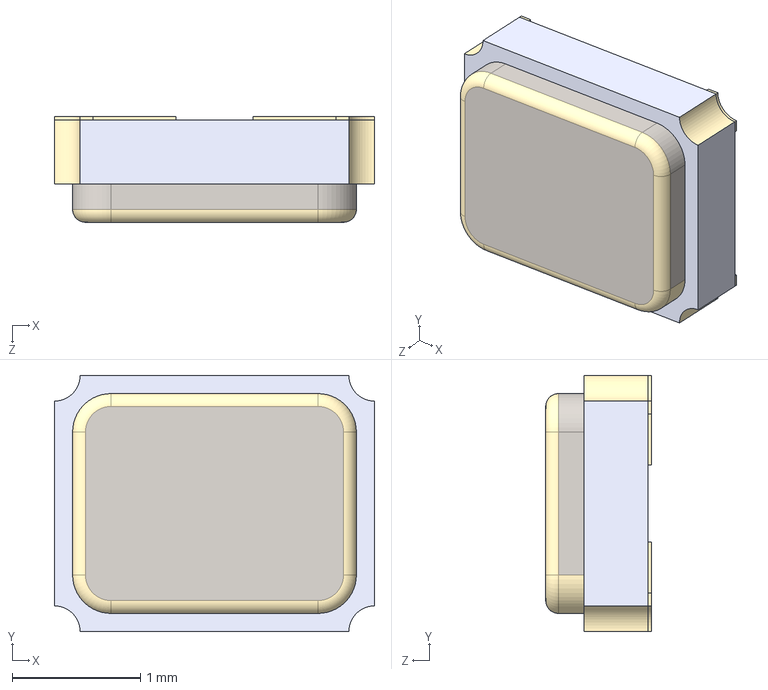
[picture p58: CAD file, 2024-12-15]
3dmodels/_PASSIVES_3D/User Library-SM2520-4.step
2.50 x 2.00 x 0.825 mm
