dohny1/kicad_libs/3dmodels/_SMD_SEMI_3D/SOT363.STEP

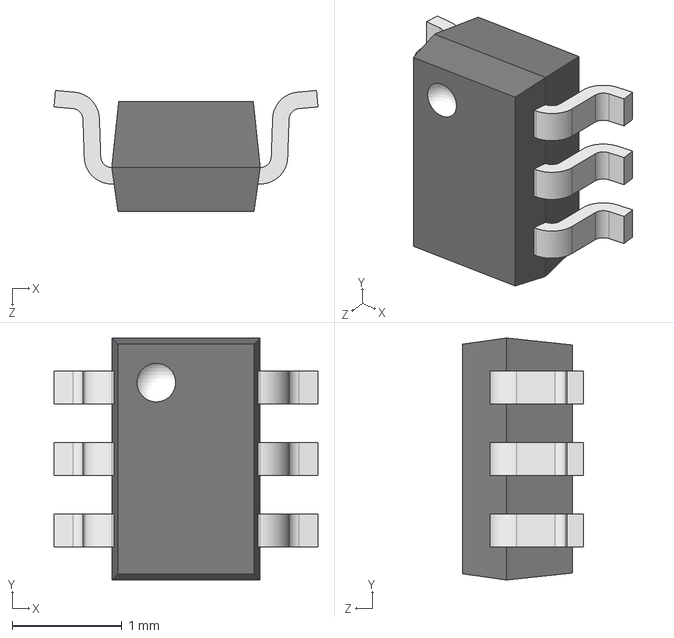
[picture p59: CAD file, 2024-12-15]
3dmodels/_SMD_SEMI_3D/SOT363.STEP
2.40 x 2.20 x 1.10 mm
