dohny1/kicad_libs/3dmodels/_THT_3D/User Library-CAPRR250W40L460T300H750_WIMA_0C.STEP

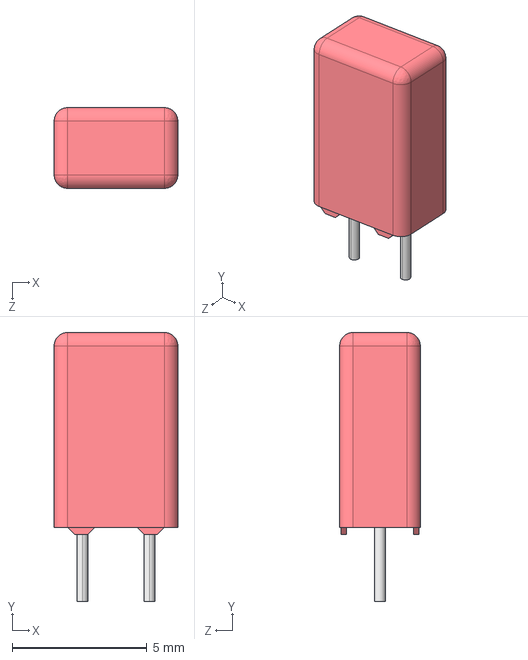
[picture p60: CAD file, 2024-12-15]
3dmodels/_THT_3D/User Library-CAPRR250W40L460T300H750_WIMA_0C.STEP
4.60 x 10.0 x 3.00 mm
Lead x 2
