dohny1/kicad_libs/3dmodels/_PASSIVES_3D/User Library-UM-5_Crystal.step

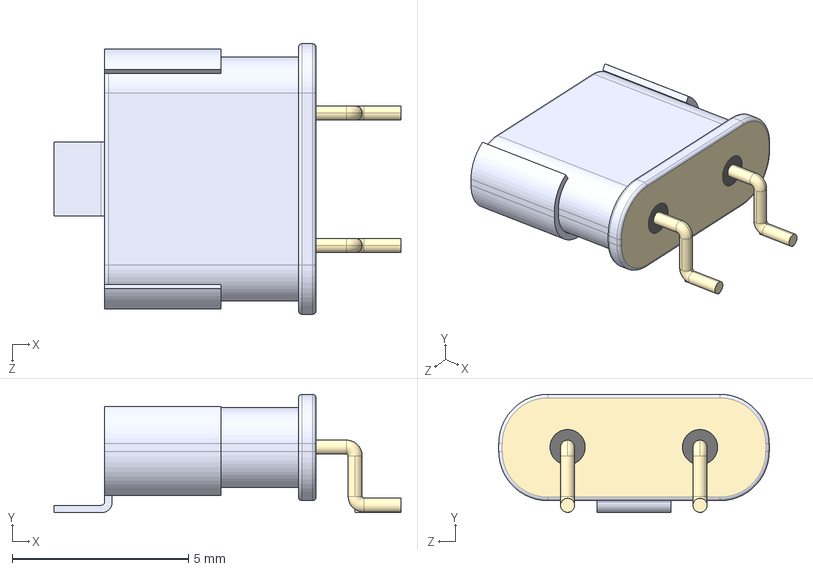
[picture p61: CAD file, 2024-12-15]
3dmodels/_PASSIVES_3D/User Library-UM-5_Crystal.step
9.85 x 3.36 x 7.68 mm
