dohny1/kicad_libs/3dmodels/_SMD_SEMI_3D/micropack_dtype.STEP

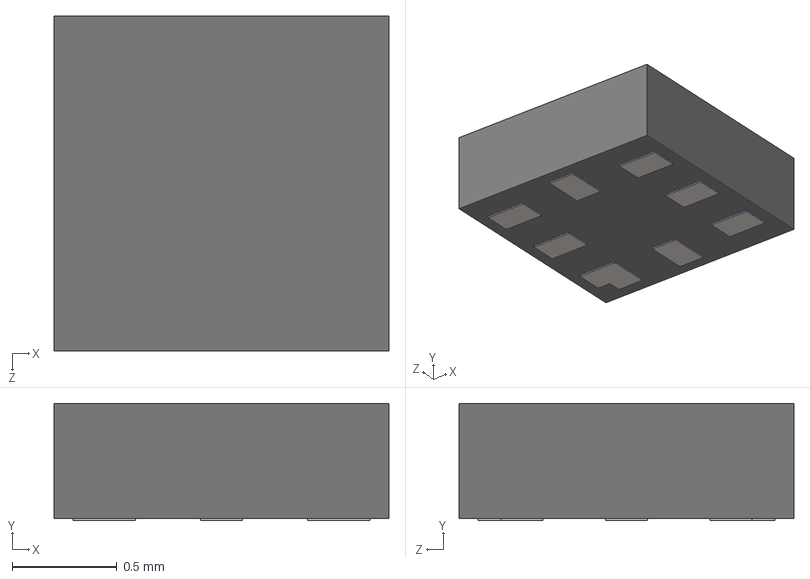
[picture p62: CAD file, 2024-12-15]
3dmodels/_SMD_SEMI_3D/micropack_dtype.STEP
1.60 x 0.56 x 1.60 mm
