dohny1/kicad_libs/3dmodels/_THT_3D/User Library-DO-35G-40.step

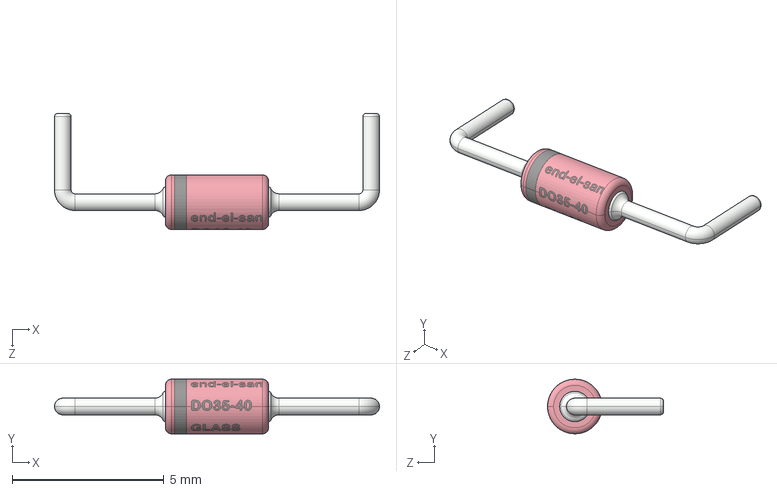
[picture p63: CAD file, 2024-12-15]
3dmodels/_THT_3D/User Library-DO-35G-40.step
10.7 x 1.80 x 3.82 mm
