dohny1/kicad_libs/3dmodels/_THT_CON_3D/TYCO_5-1814832-1.stp

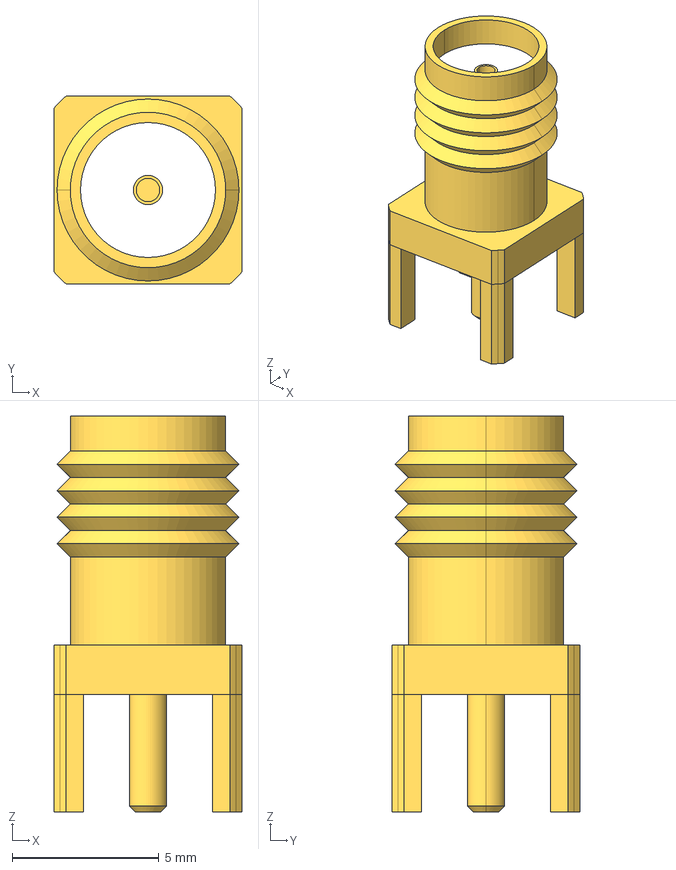
[picture p64: CAD file, 2024-12-15]
3dmodels/_THT_CON_3D/TYCO_5-1814832-1.stp
6.40 x 6.40 x 13.5 mm
