dohny1/kicad_libs/3dmodels/_SMD_SEMI_3D/User Library-153BallWFBGA.step

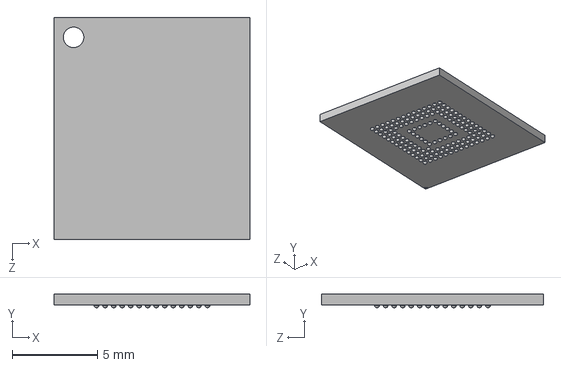
[picture p65: CAD file, 2024-12-15]
3dmodels/_SMD_SEMI_3D/User Library-153BallWFBGA.step
11.5 x 0.802 x 13.0 mm
