dohny1/kicad_libs/3dmodels/_THT_3D/VAR_EPCOS_B72210S0461K101.stp

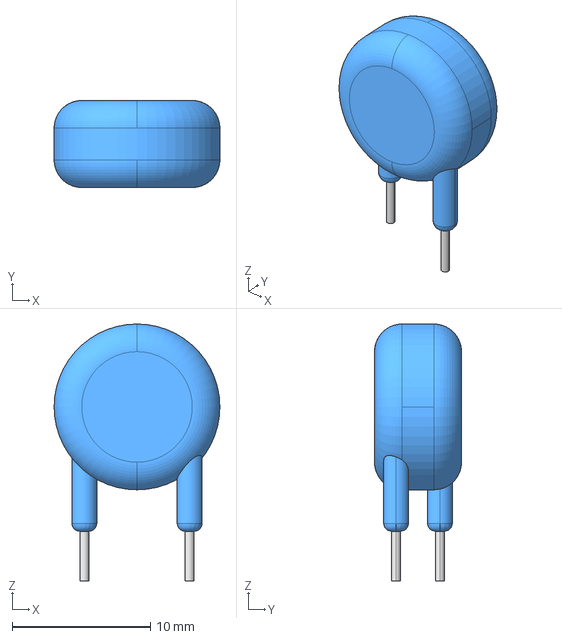
[picture p66: CAD file, 2024-12-15]
3dmodels/_THT_3D/VAR_EPCOS_B72210S0461K101.stp
12.0 x 6.30 x 18.6 mm
