dohny1/kicad_libs/3dmodels/_THT_CON_3D/CON_RCA_3_PIN_white.STEP

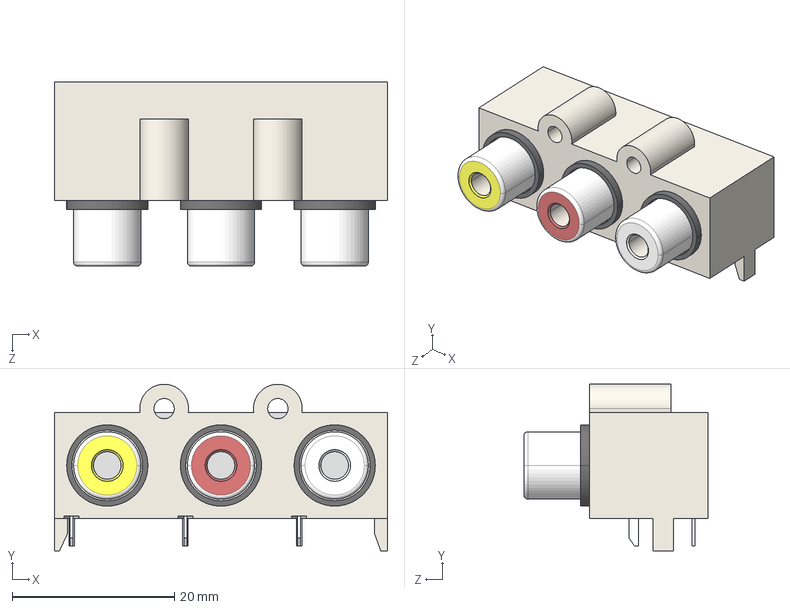
[picture p67: CAD file, 2024-12-15]
3dmodels/_THT_CON_3D/CON_RCA_3_PIN_white.STEP
41.0 x 20.5 x 22.7 mm
