dohny1/kicad_libs/3dmodels/_PASSIVES_3D/F0806.step

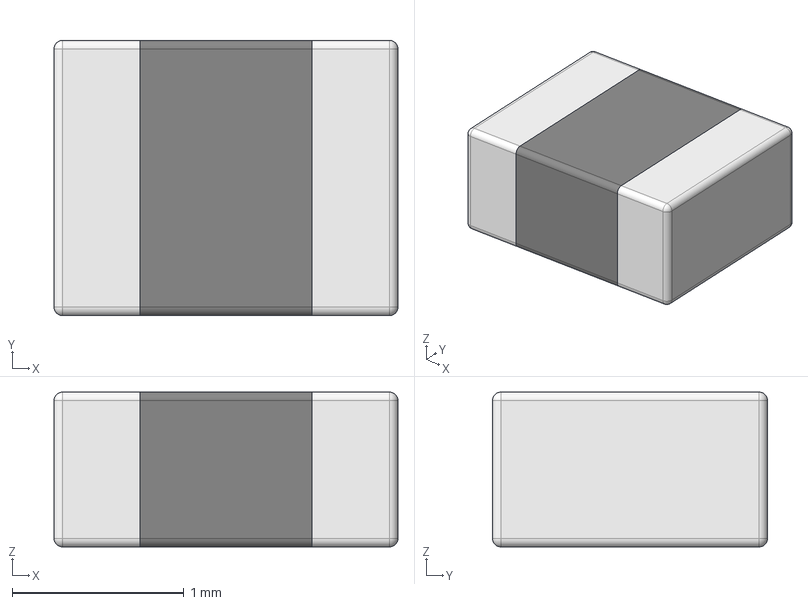
[picture p68: CAD file, 2024-12-15]
3dmodels/_PASSIVES_3D/F0806.step
2.00 x 1.60 x 0.9 mm
