dohny1/kicad_libs/3dmodels/_SMD_SEMI_3D/WSON6-2x2.step

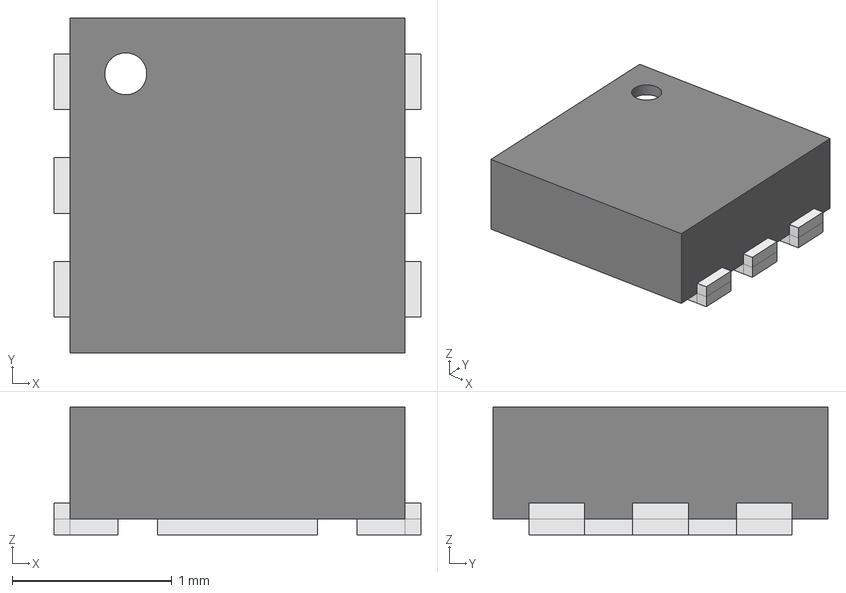
[picture p69: CAD file, 2024-12-15]
3dmodels/_SMD_SEMI_3D/WSON6-2x2.step
2.30 x 2.10 x 0.8 mm
Thermal_Shape
