dohny1/kicad_libs/3dmodels/_THT_3D/wima_2.5x4.6.STEP

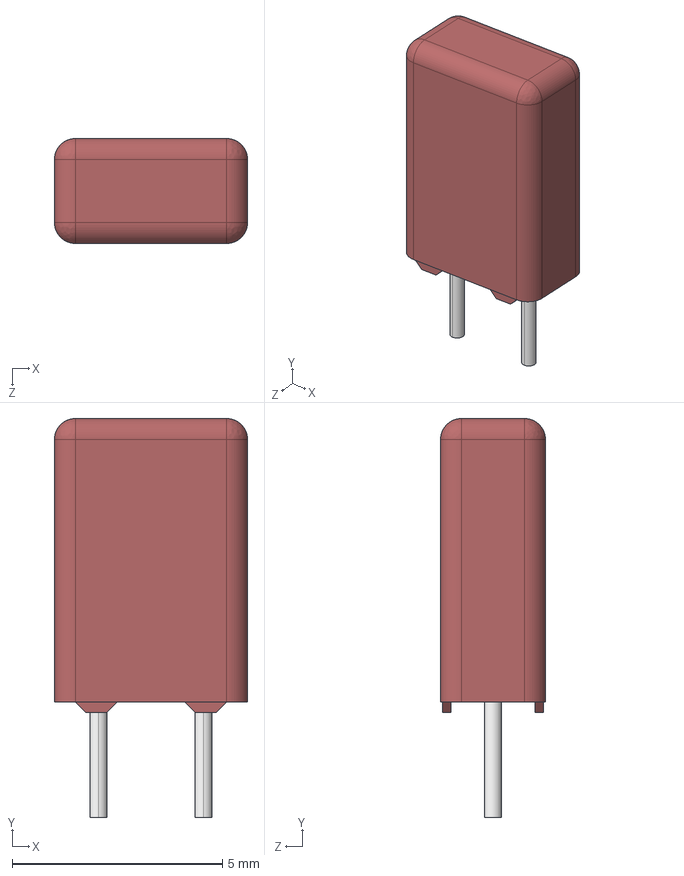
[picture p70: CAD file, 2024-12-15]
3dmodels/_THT_3D/wima_2.5x4.6.STEP
4.60 x 9.50 x 2.50 mm
User Library-CAPRR250W40L460T250H700_WIMA_0B_Body
User Library-CAPRR250W40L460T250H700_WIMA_0B_Lead x 2
