dohny1/kicad_libs/3dmodels/_THT_CON_3D/Conn_GCT_USB4085-GF-A_eec.STEP

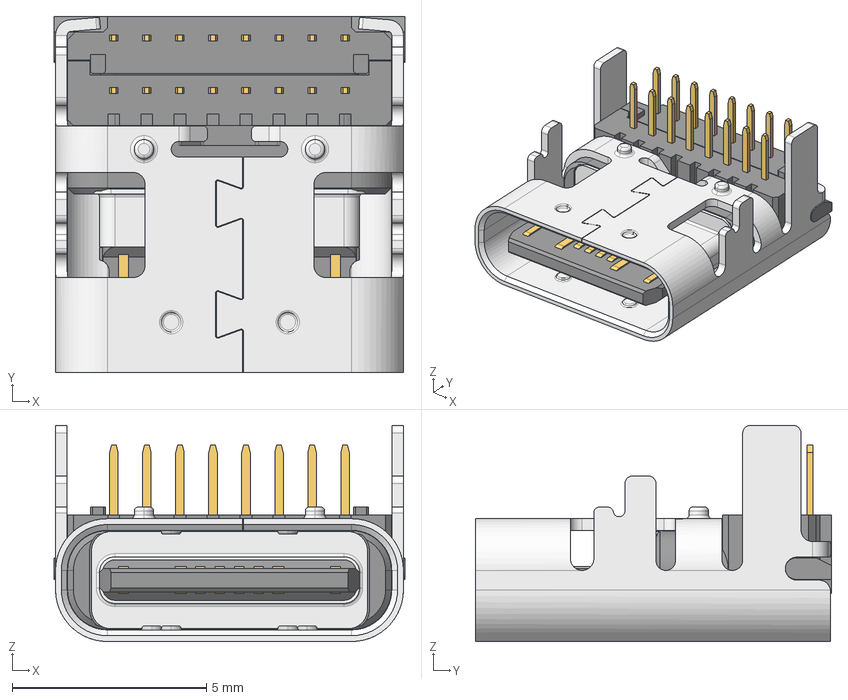
[picture p71: CAD file, 2024-12-15]
3dmodels/_THT_CON_3D/Conn_GCT_USB4085-GF-A_eec.STEP
9.03 x 9.17 x 5.56 mm
USB4085-GF-A_PART1
GCT
