dohny1/kicad_libs/3dmodels/_PASSIVES_3D/C1206_C0G.STEP

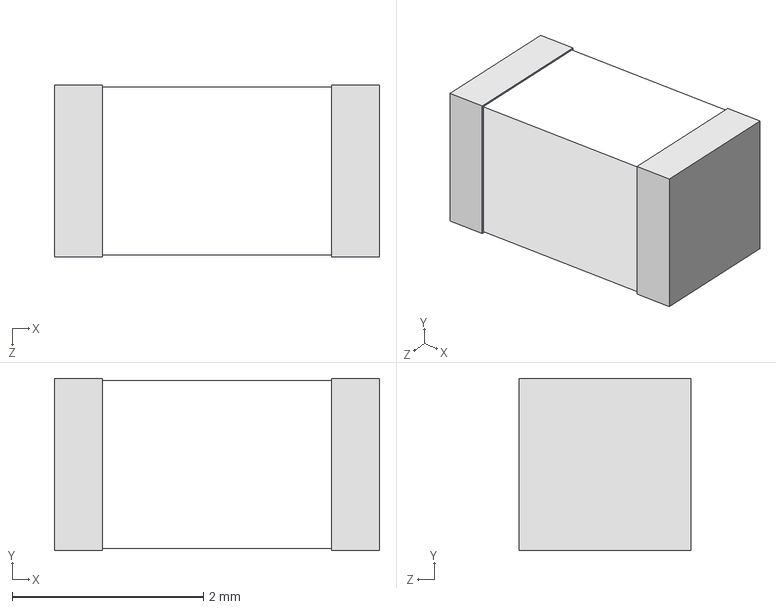
[picture p72: CAD file, 2024-12-15]
3dmodels/_PASSIVES_3D/C1206_C0G.STEP
3.40 x 1.80 x 1.80 mm
