dohny1/kicad_libs/3dmodels/_SMD_SEMI_3D/SOT583-8.step

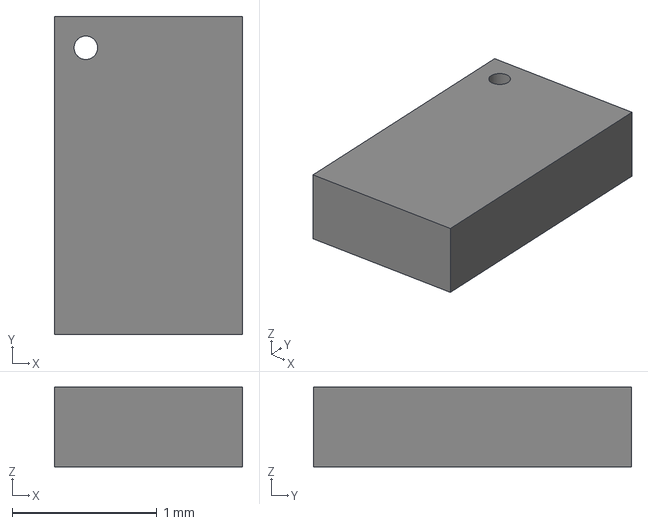
[picture p73: CAD file, 2024-12-15]
3dmodels/_SMD_SEMI_3D/SOT583-8.step
1.30 x 2.20 x 0.55 mm
