dohny1/kicad_libs/3dmodels/_THT_3D/5Wres_vert.STEP

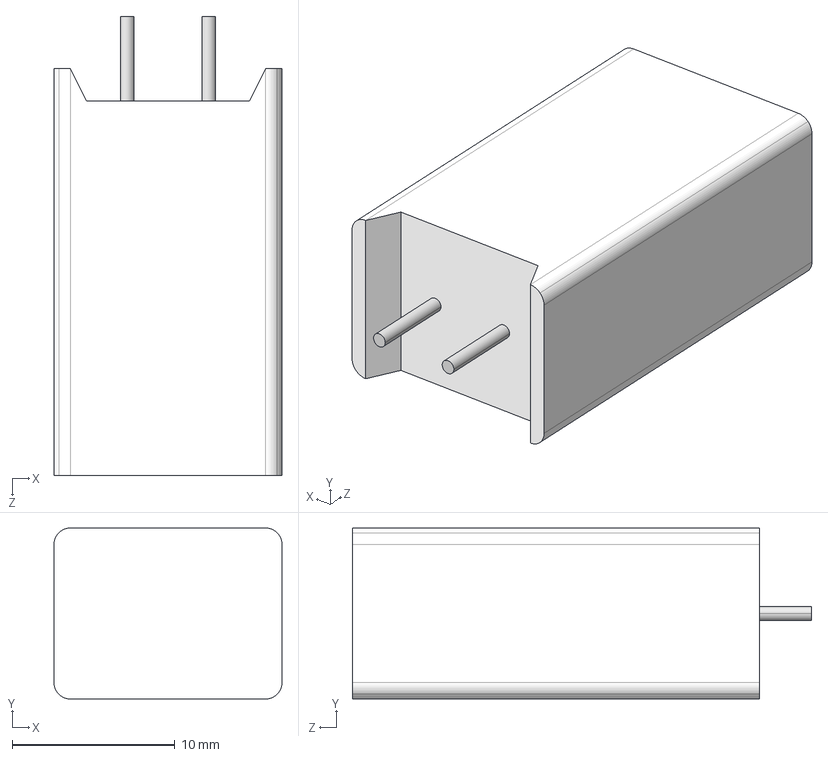
[picture p74: CAD file, 2024-12-15]
3dmodels/_THT_3D/5Wres_vert.STEP
14.0 x 10.5 x 28.2 mm
RES_TYCO_SQM
RES_TYCO_SQM-1
RES_TYCO_SQM-2
