dohny1/kicad_libs/3dmodels/_THT_CON_3D/AV1-8.4-8B_red.STEP

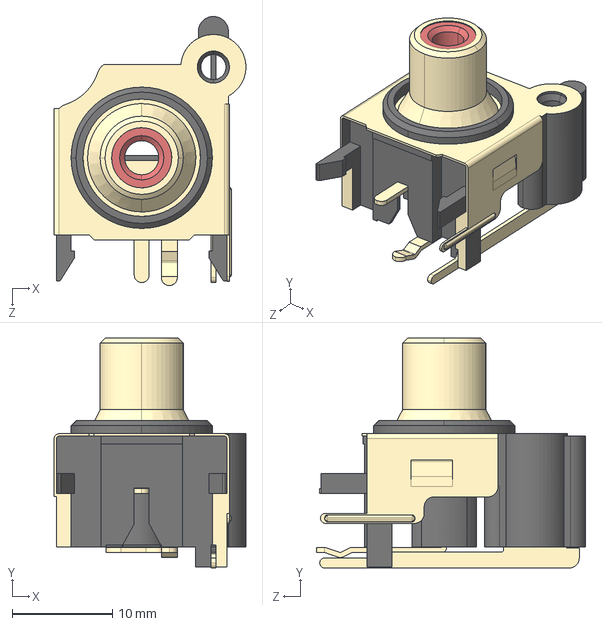
[picture p75: CAD file, 2024-12-15]
3dmodels/_THT_CON_3D/AV1-8.4-8B_red.STEP
19.1 x 23.0 x 26.9 mm
