dohny1/kicad_libs/3dmodels/_PASSIVES_3D/R0201.STEP

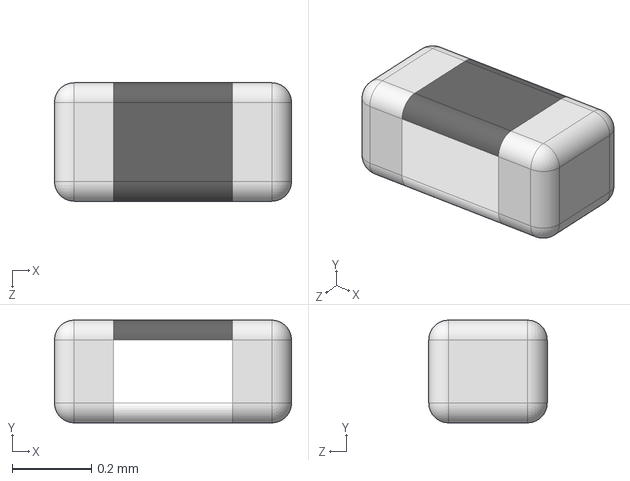
[picture p76: CAD file, 2024-12-15]
3dmodels/_PASSIVES_3D/R0201.STEP
0.6 x 0.26 x 0.3 mm
