dohny1/kicad_libs/3dmodels/_SMD_SEMI_3D/SOT23-6.STEP

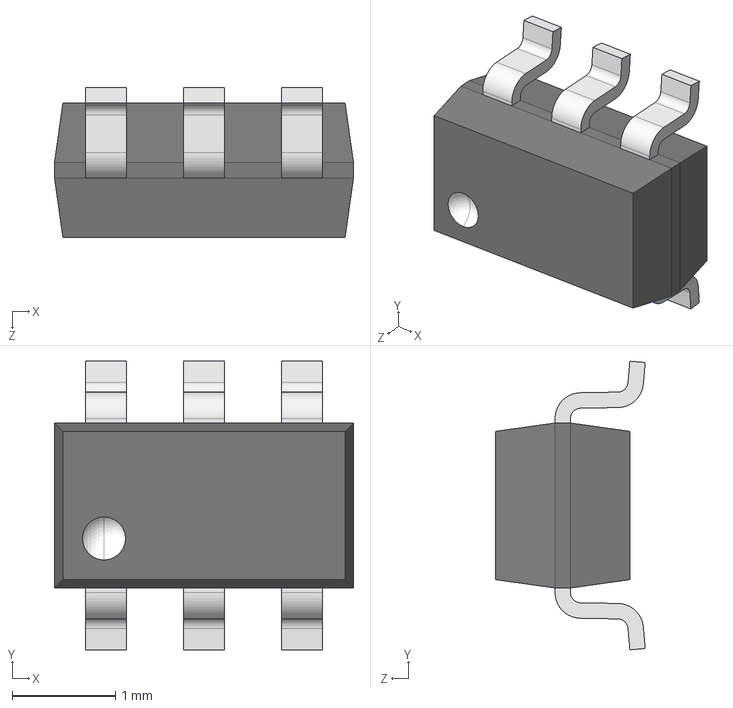
[picture p77: CAD file, 2024-12-15]
3dmodels/_SMD_SEMI_3D/SOT23-6.STEP
2.90 x 2.80 x 1.45 mm
