dohny1/kicad_libs/3dmodels/_THT_3D/external_opa.STEP

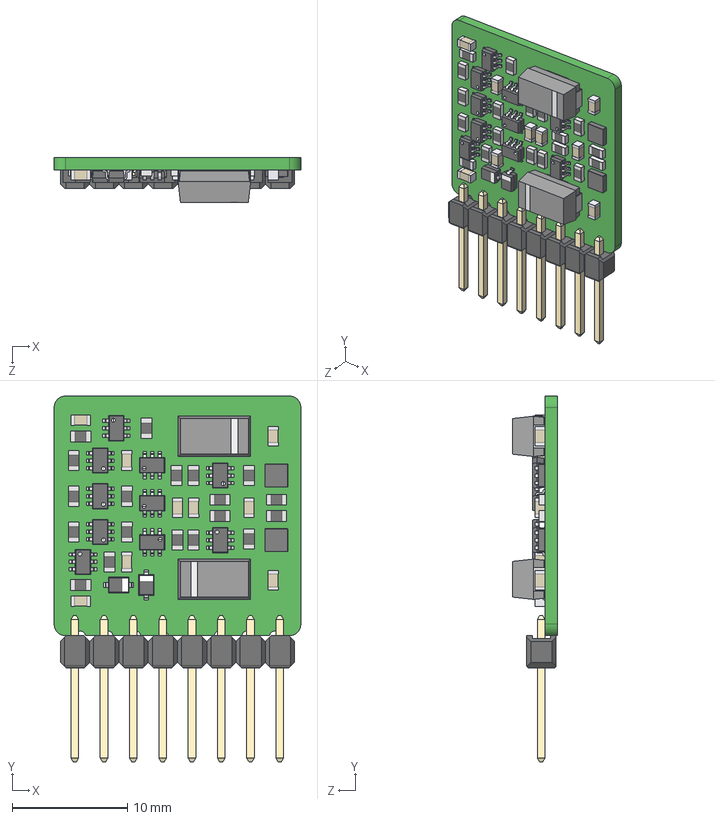
[picture p78: CAD file, 2024-12-15]
3dmodels/_THT_3D/external_opa.STEP
21.4 x 31.8 x 3.86 mm
CAPMP6032X280N x 2
CAPMP6032X280N-1 x 2
CAPMP6032X280N-2 x 2
CAPMP6032X280N-3 x 2
CAPMP6032X280N-4 x 2
CAPMP6032X280N-5 x 2
CAPMP6032X280N-6 x 2
CAPMP6032X280N-7 x 2
CAP_0603 x 9
SOT363 x 10
User Library-SOD323-1 x 2
DFN2020B-3 x 2
RES 0603 (1608 metric) x 19
Board-Part-1
User Library-1x8 TH Pitch 2_54mm_holder
User Library-1x8 TH Pitch 2_54mm_pin x 8
