dohny1/kicad_libs/3dmodels/_THT_CON_3D/User Library-WJ127-5_0-3P.step

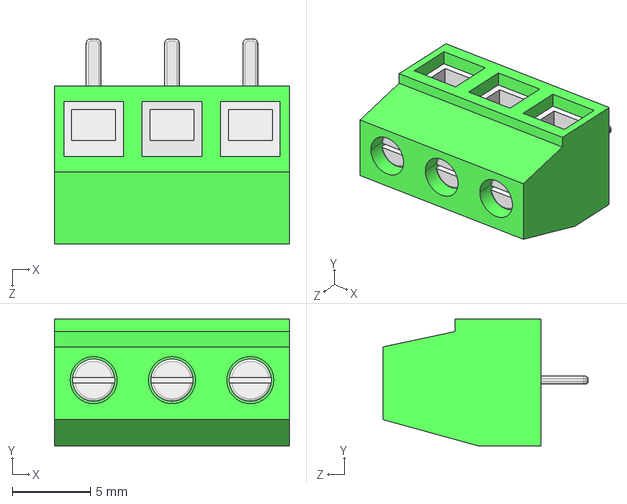
[picture p79: CAD file, 2024-12-15]
3dmodels/_THT_CON_3D/User Library-WJ127-5_0-3P.step
15.0 x 8.10 x 13.1 mm
