dohny1/kicad_libs/3dmodels/_PASSIVES_3D/FBC_0805.stp

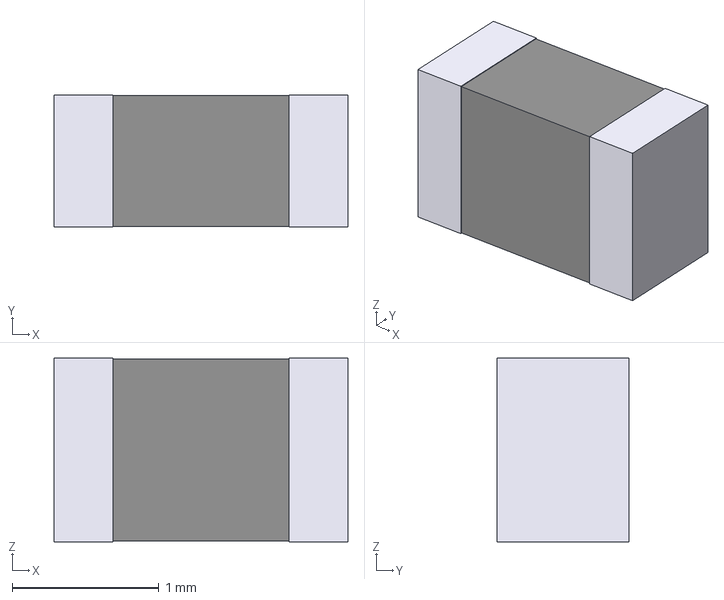
[picture p80: CAD file, 2024-12-15]
3dmodels/_PASSIVES_3D/FBC_0805.stp
2.00 x 0.9 x 1.25 mm
