dohny1/kicad_libs/3dmodels/_SMD_SEMI_3D/User Library-TQFP100_Grid_0_5.STEP

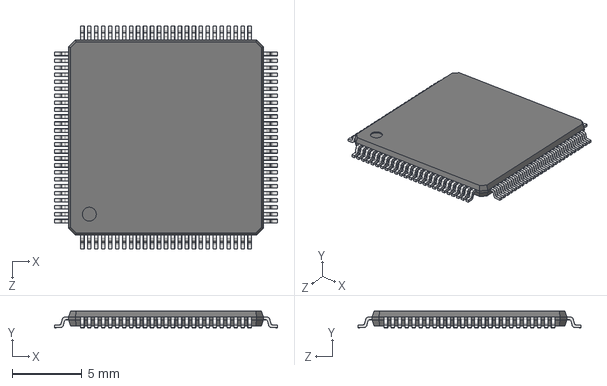
[picture p81: CAD file, 2024-12-15]
3dmodels/_SMD_SEMI_3D/User Library-TQFP100_Grid_0_5.STEP
16.0 x 1.20 x 16.0 mm
TQFP100_Koerper_2
TQFP_PIN_2 x 100
