dohny1/kicad_libs/3dmodels/_THT_3D/User Library-CAPPR250-630x1000_100uF_16V.STEP

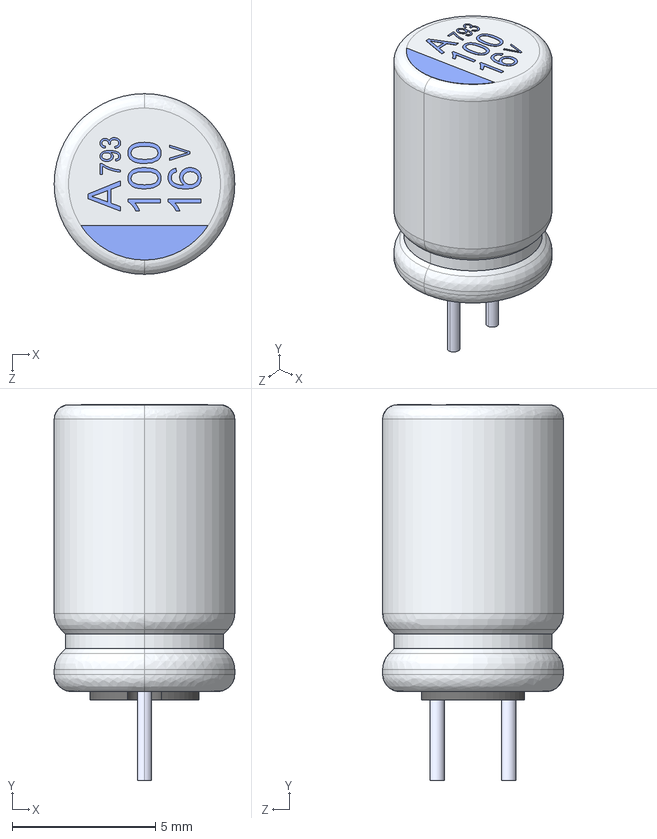
[picture p82: CAD file, 2024-12-15]
3dmodels/_THT_3D/User Library-CAPPR250-630x1000_100uF_16V.STEP
6.30 x 13.1 x 6.30 mm
Rubber
Imported x 2
Text
