dohny1/kicad_libs/3dmodels/_PASSIVES_3D/relay_HFD4.STEP

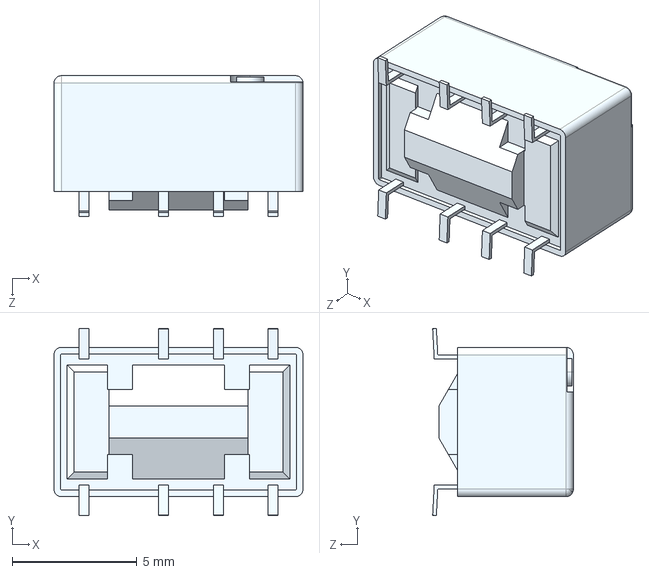
[picture p83: CAD file, 2024-12-15]
3dmodels/_PASSIVES_3D/relay_HFD4.STEP
10.0 x 7.52 x 5.65 mm
