dohny1/kicad_libs/3dmodels/_SMD_SEMI_3D/SOIC20_ISO.step

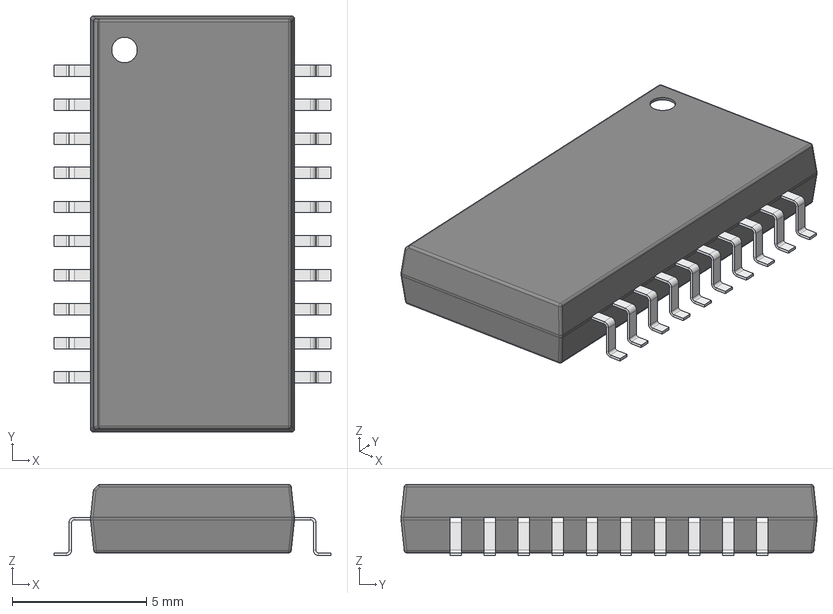
[picture p84: CAD file, 2024-12-15]
3dmodels/_SMD_SEMI_3D/SOIC20_ISO.step
10.3 x 15.5 x 2.65 mm
Leader x 20
