dohny1/kicad_libs/3dmodels/_THT_3D/User Library-Fuse_Holder.STEP

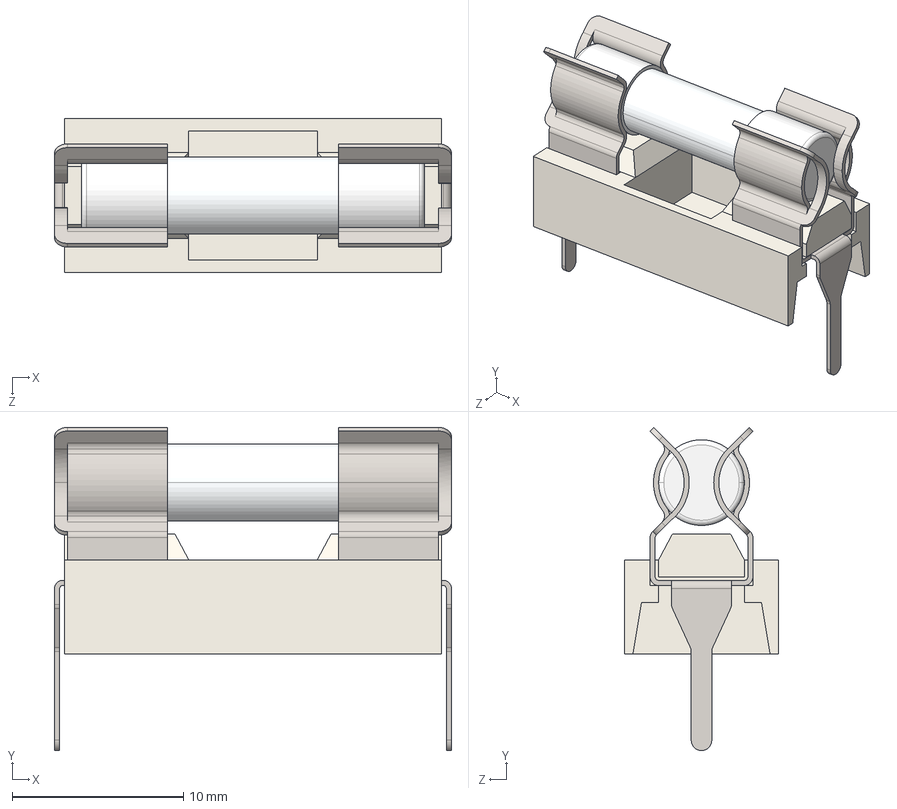
[picture p85: CAD file, 2024-12-15]
3dmodels/_THT_3D/User Library-Fuse_Holder.STEP
23.2 x 18.8 x 9.00 mm
User Library-Fuse_Holder_Body_Domyslna
User Library-Fuse_Holder_pin_Domyslna x 2
User Library-Fuse_Holder_Fuse_Domyslna
