dohny1/kicad_libs/3dmodels/_THT_CON_3D/pxc_1776508_06_03_MSTB-2-5-2-GF-5-08_3D.stp

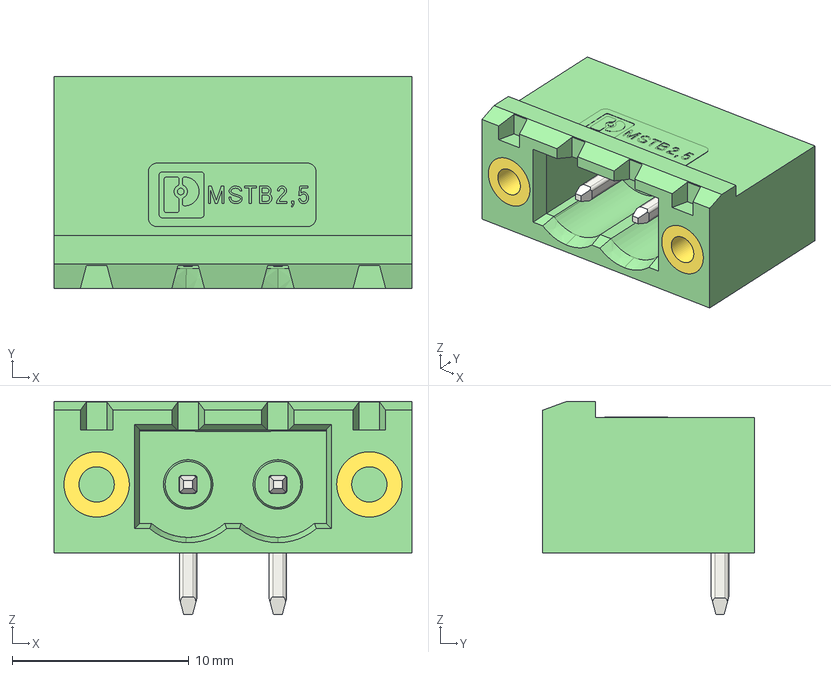
[picture p86: CAD file, 2024-12-15]
3dmodels/_THT_CON_3D/pxc_1776508_06_03_MSTB-2-5-2-GF-5-08_3D.stp
20.3 x 12.0 x 12.1 mm
