dohny1/kicad_libs/3dmodels/_PASSIVES_3D/Coilcraft-XAL5050.step

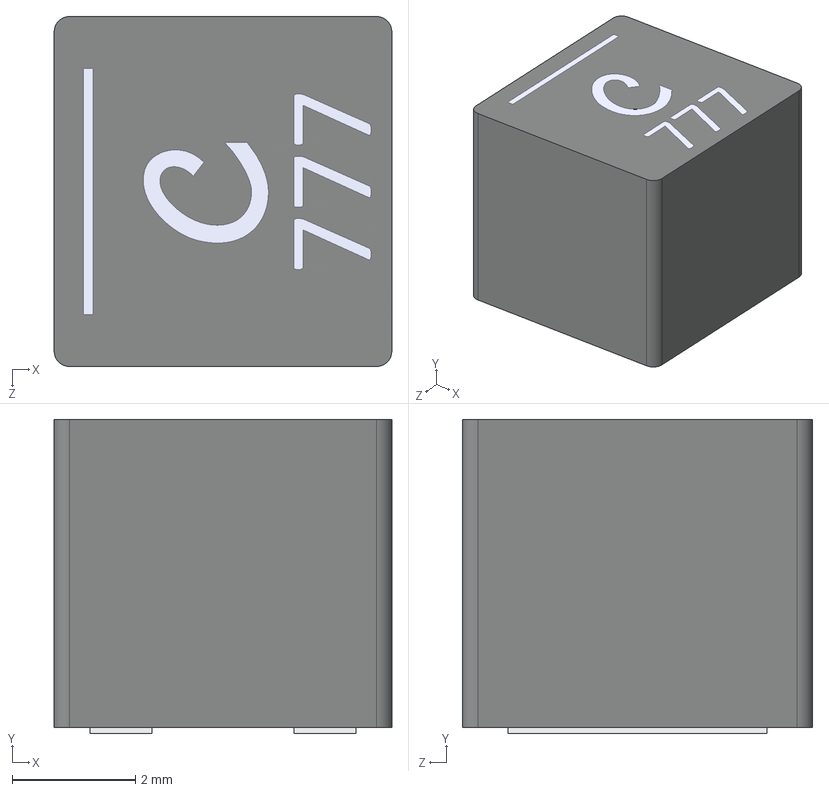
[picture p87: CAD file, 2024-12-15]
3dmodels/_PASSIVES_3D/Coilcraft-XAL5050.step
5.48 x 5.10 x 5.68 mm
