dohny1/kicad_libs/3dmodels/_SMD_SEMI_3D/DMP8.step

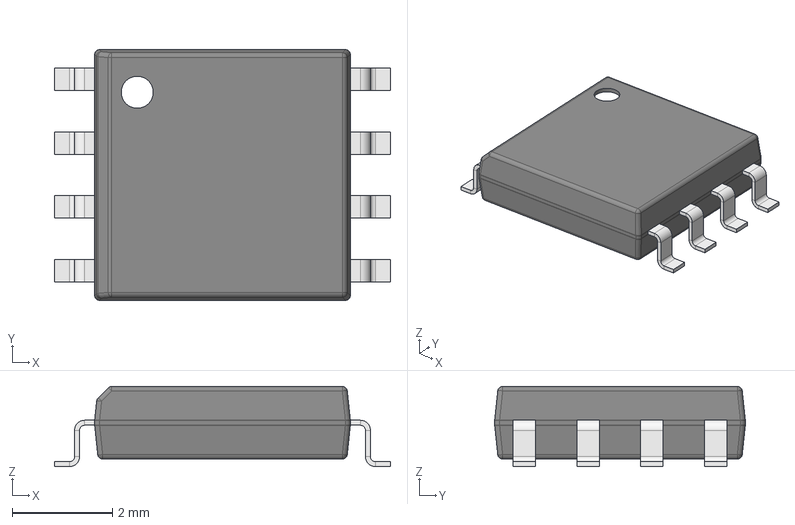
[picture p88: CAD file, 2024-12-15]
3dmodels/_SMD_SEMI_3D/DMP8.step
6.70 x 5.00 x 1.60 mm
Leader x 8
