dohny1/kicad_libs/3dmodels/_THT_3D/User Library-Led 3mm Dialight mod 551-1107F.step

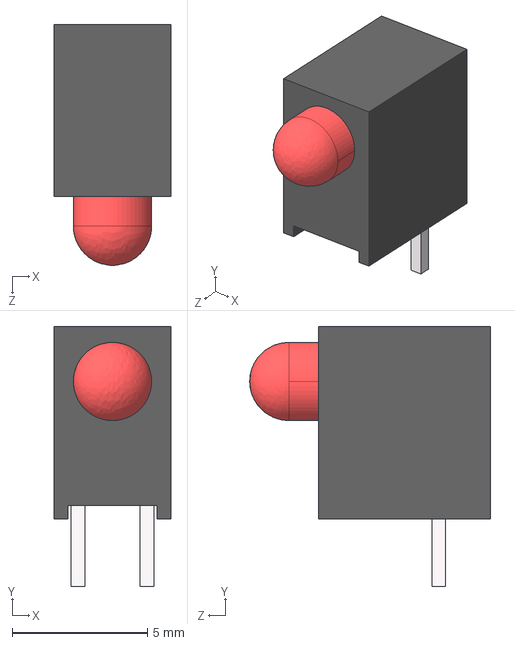
[picture p89: CAD file, 2024-12-15]
3dmodels/_THT_3D/User Library-Led 3mm Dialight mod 551-1107F.step
4.32 x 9.60 x 8.89 mm
