dohny1/kicad_libs/3dmodels/_THT_CON_3D/AV2-8.4-14.STEP

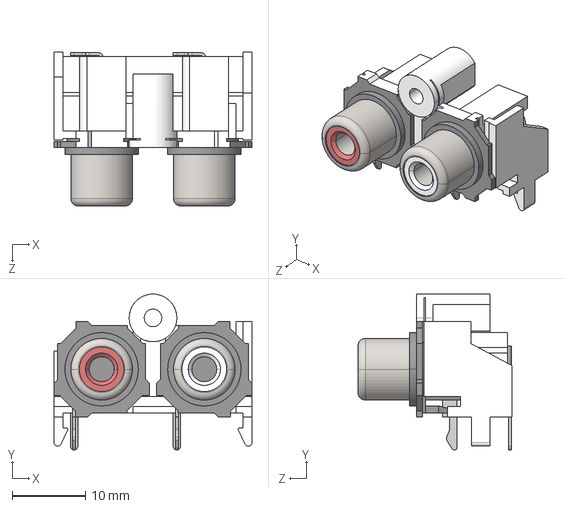
[picture p90: CAD file, 2024-12-15]
3dmodels/_THT_CON_3D/AV2-8.4-14.STEP
27.0 x 21.3 x 21.0 mm
