dohny1/kicad_libs/3dmodels/_PASSIVES_3D/User Library-tdk_acm1211.step

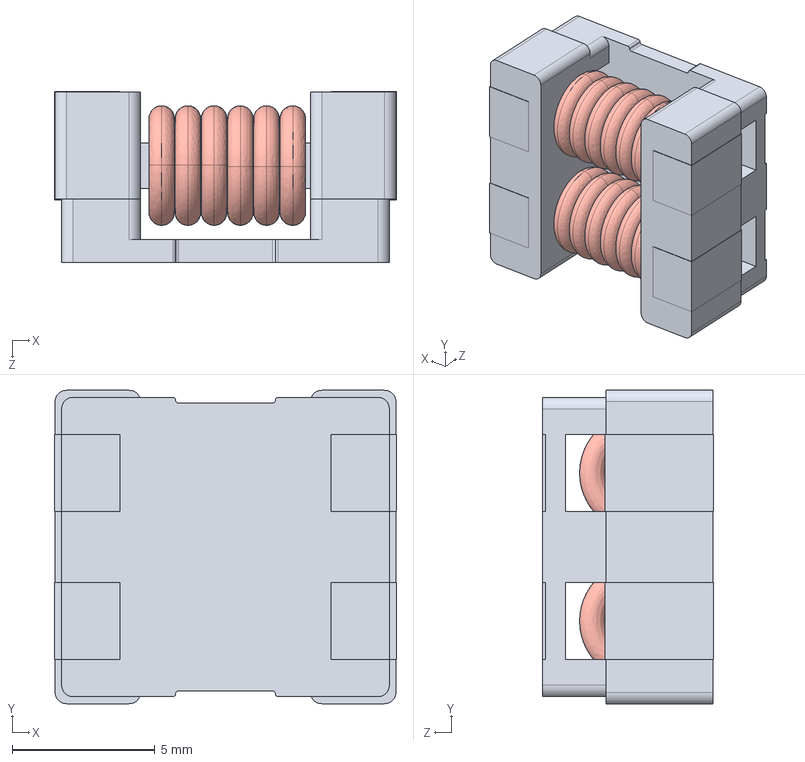
[picture p91: CAD file, 2024-12-15]
3dmodels/_PASSIVES_3D/User Library-tdk_acm1211.step
12.0 x 11.0 x 6.00 mm
