dohny1/kicad_libs/3dmodels/_SMD_SEMI_3D/QFN40.step

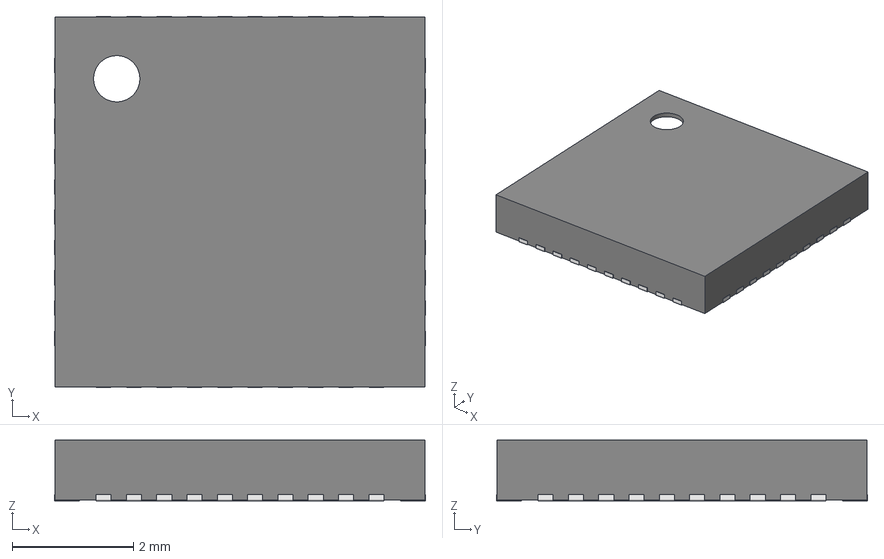
[picture p92: CAD file, 2024-12-15]
3dmodels/_SMD_SEMI_3D/QFN40.step
6.12 x 6.12 x 1.00 mm
Thermal_Shape
