dohny1/kicad_libs/3dmodels/_THT_3D/ELP18.STEP

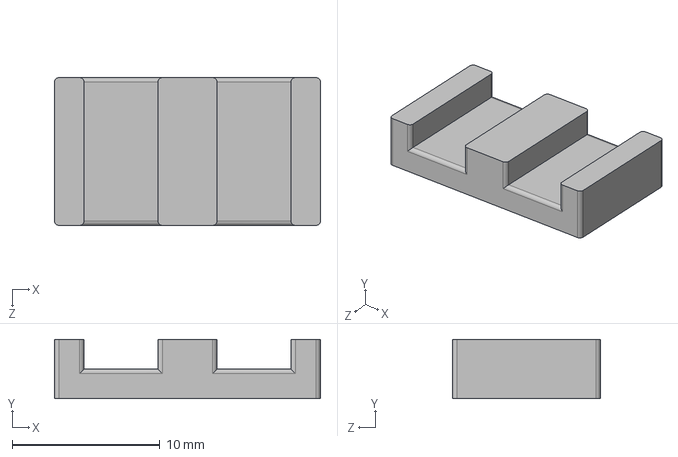
[picture p93: CAD file, 2024-12-15]
3dmodels/_THT_3D/ELP18.STEP
18.0 x 4.00 x 10.0 mm
