dohny1/kicad_libs/3dmodels/_THT_CON_3D/User Library-PLD-2x5.step

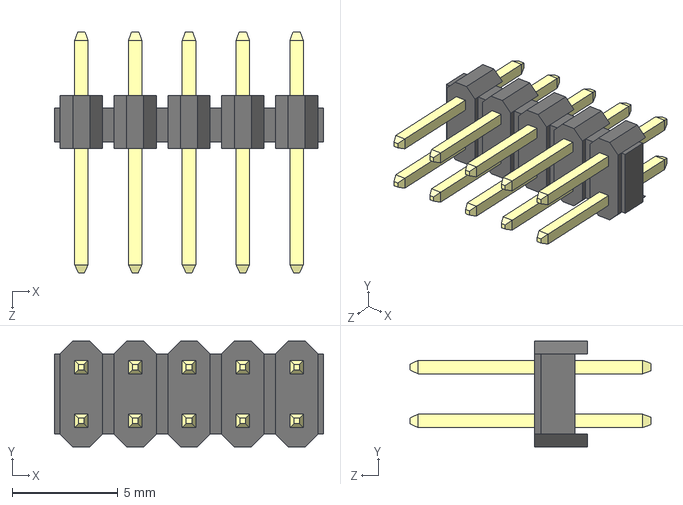
[picture p94: CAD file, 2024-12-15]
3dmodels/_THT_CON_3D/User Library-PLD-2x5.step
12.7 x 5.00 x 11.4 mm
