dohny1/kicad_libs/3dmodels/_PASSIVES_3D/RES 1206 (3216 metric).STEP

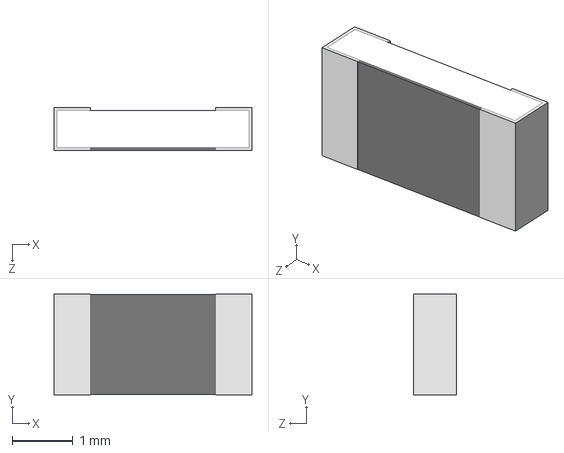
[picture p95: CAD file, 2024-12-15]
3dmodels/_PASSIVES_3D/RES 1206 (3216 metric).STEP
3.25 x 1.65 x 0.7 mm
