dohny1/kicad_libs/3dmodels/_SMD_SEMI_3D/RHL14_2P05X2P05.step

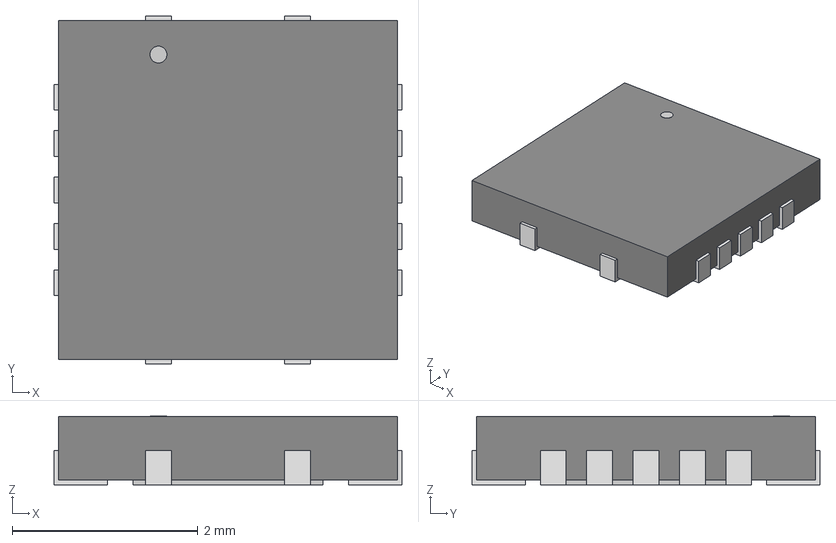
[picture p96: CAD file, 2024-12-15]
3dmodels/_SMD_SEMI_3D/RHL14_2P05X2P05.step
3.75 x 3.75 x 0.739 mm
