dohny1/kicad_libs/3dmodels/_THT_3D/User Library-DIP-8P-M01.step

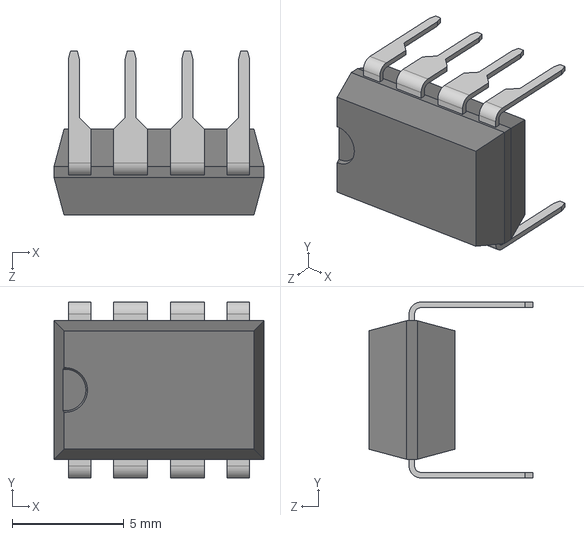
[picture p97: CAD file, 2024-12-15]
3dmodels/_THT_3D/User Library-DIP-8P-M01.step
9.40 x 7.87 x 7.36 mm
