dohny1/kicad_libs/3dmodels/_PASSIVES_3D/R0402.STEP

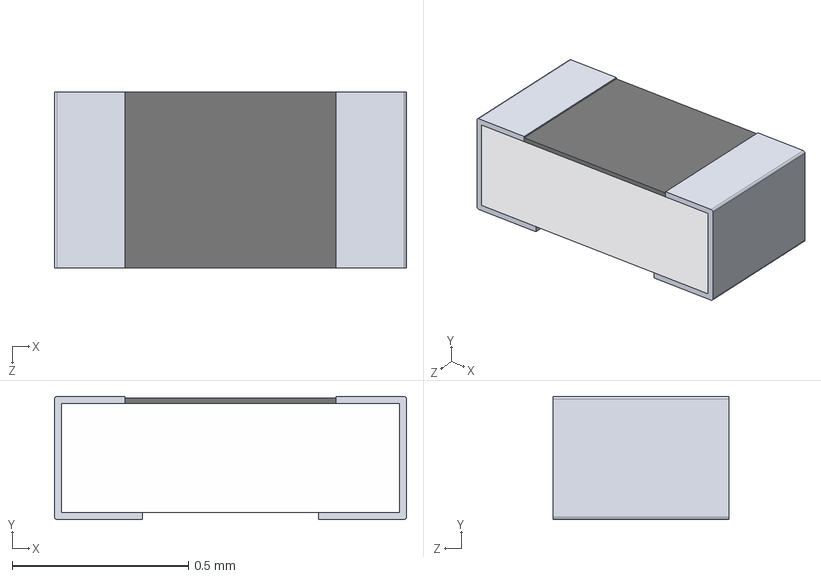
[picture p98: CAD file, 2024-12-15]
3dmodels/_PASSIVES_3D/R0402.STEP
1.00 x 0.35 x 0.5 mm
0402 OPIS
0402 PAD x 2
0402 BODY
