dohny1/kicad_libs/3dmodels/_SMD_SEMI_3D/TSOP65P640X120-16N.step

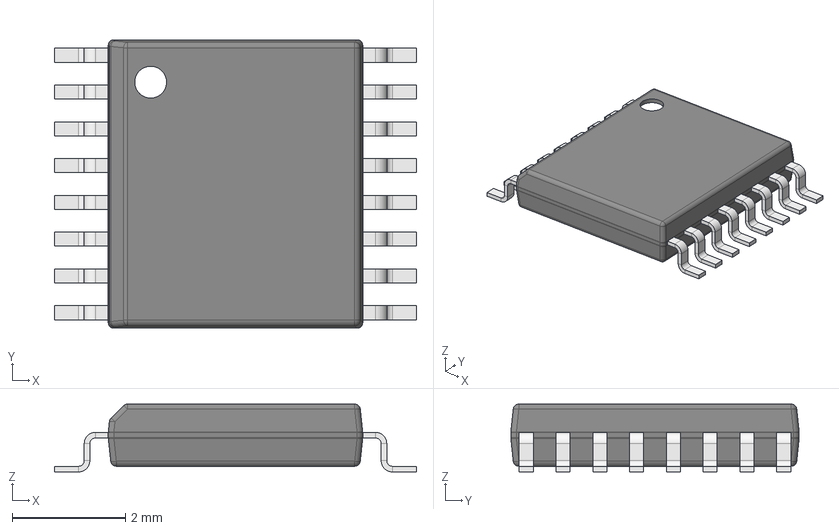
[picture p99: CAD file, 2024-12-15]
3dmodels/_SMD_SEMI_3D/TSOP65P640X120-16N.step
6.40 x 5.10 x 1.20 mm
Leader x 16
