dohny1/kicad_libs/3dmodels/_THT_3D/CAPRB_MURATA_DE2F3KY103MA3BM02.stp

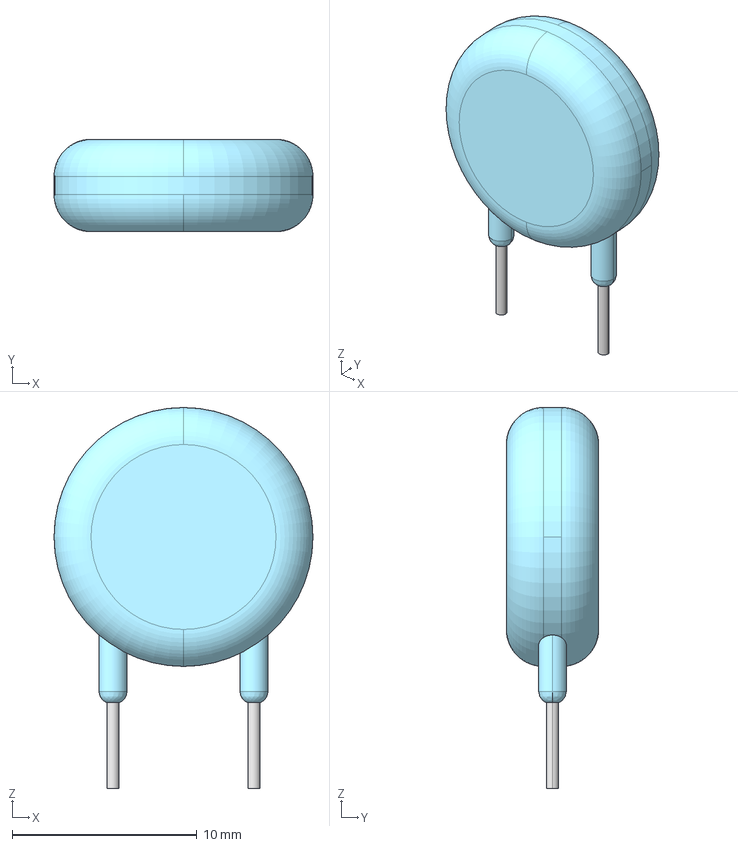
[picture p100: CAD file, 2024-12-15]
3dmodels/_THT_3D/CAPRB_MURATA_DE2F3KY103MA3BM02.stp
14.0 x 5.00 x 20.6 mm
