dohny1/kicad_libs/3dmodels/_THT_CON_3D/pxc_1953279_03_MCDN-1-5-9-G1-3-5-RNP14THR_3D.stp

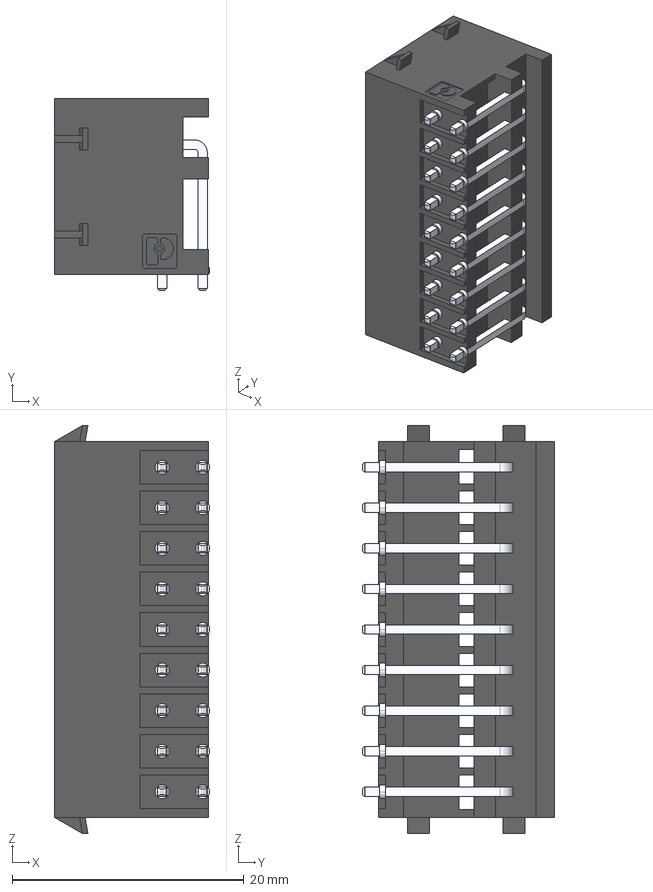
[picture p101: CAD file, 2024-12-15]
3dmodels/_THT_CON_3D/pxc_1953279_03_MCDN-1-5-9-G1-3-5-RNP14THR_3D.stp
13.4 x 16.6 x 35.2 mm
