dohny1/kicad_libs/3dmodels/_PASSIVES_3D/RES 2512 (6432 metric).STEP

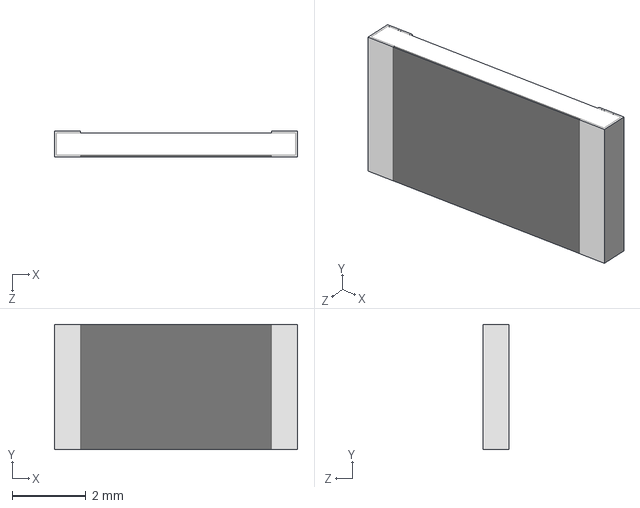
[picture p102: CAD file, 2024-12-15]
3dmodels/_PASSIVES_3D/RES 2512 (6432 metric).STEP
6.60 x 3.40 x 0.7 mm
