dohny1/kicad_libs/3dmodels/_SMD_SEMI_3D/User Library-LQFP80-2.STEP

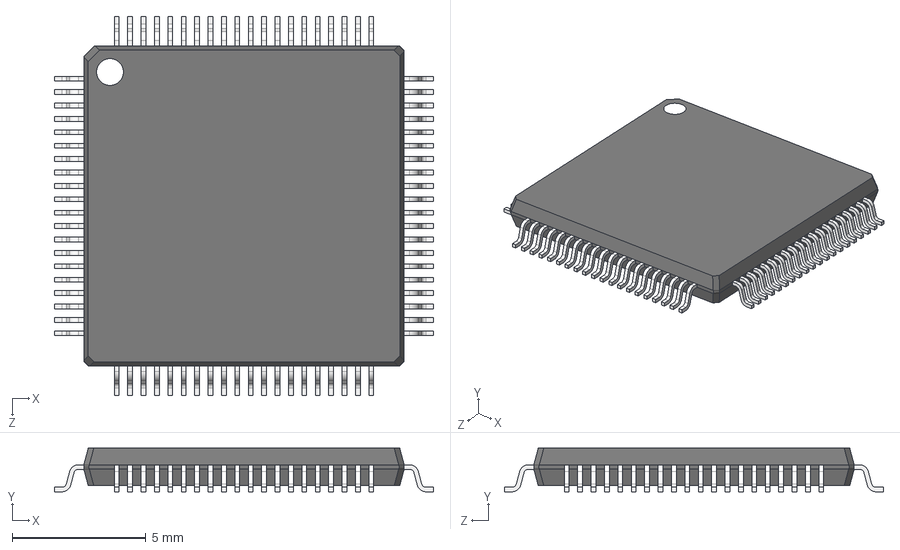
[picture p103: CAD file, 2024-12-15]
3dmodels/_SMD_SEMI_3D/User Library-LQFP80-2.STEP
14.1 x 1.63 x 14.1 mm
case
pin x 80
circle
