dohny1/kicad_libs/3dmodels/_THT_3D/REL_FINDER_40.52.stp

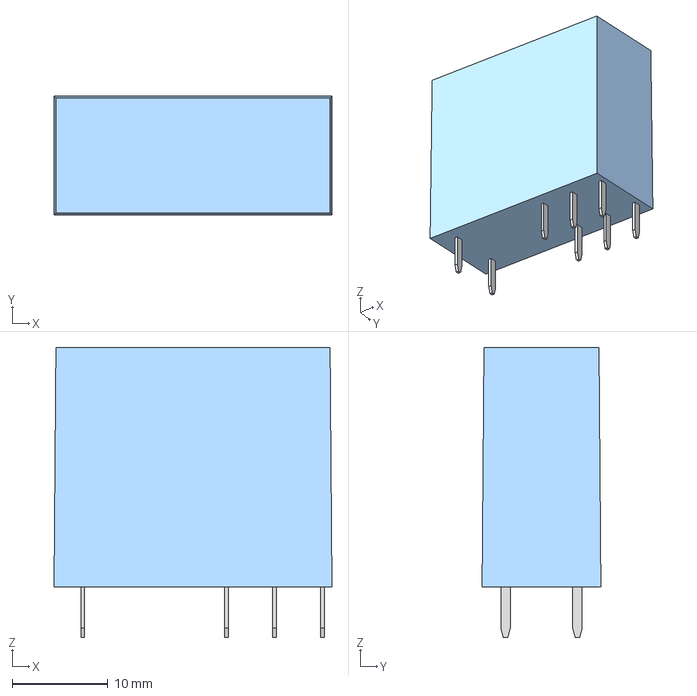
[picture p104: CAD file, 2024-12-15]
3dmodels/_THT_3D/REL_FINDER_40.52.stp
29.0 x 12.4 x 30.3 mm
