dohny1/kicad_libs/3dmodels/_SMD_SEMI_3D/QFN24.step

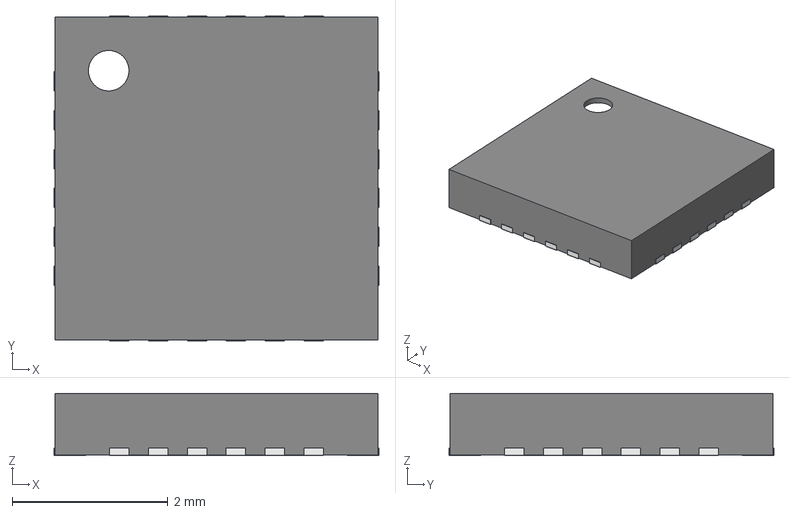
[picture p105: CAD file, 2024-12-15]
3dmodels/_SMD_SEMI_3D/QFN24.step
4.17 x 4.17 x 0.8 mm
Thermal_Shape
