dohny1/kicad_libs/3dmodels/_THT_3D/WIMA_25_72_65.STEP

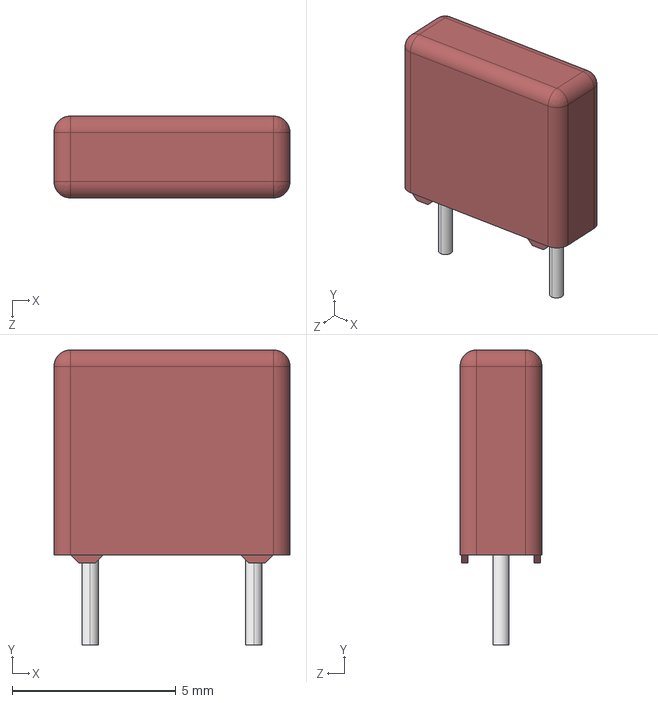
[picture p106: CAD file, 2024-12-15]
3dmodels/_THT_3D/WIMA_25_72_65.STEP
7.20 x 9.00 x 2.50 mm
User Library-CAPRR500W50L720T250H650_WIMA_1A_Body
User Library-CAPRR500W50L720T250H650_WIMA_1A_Lead x 2
