dohny1/kicad_libs/3dmodels/_THT_CON_3D/User Library-1x3 TH Pitch 2_54mm.STEP

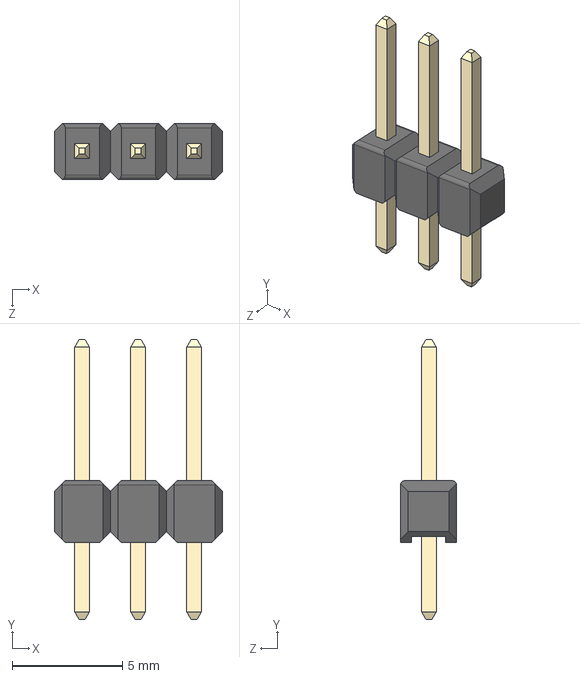
[picture p107: CAD file, 2024-12-15]
3dmodels/_THT_CON_3D/User Library-1x3 TH Pitch 2_54mm.STEP
7.62 x 12.7 x 2.54 mm
holder
pin x 3
