dohny1/kicad_libs/3dmodels/_PASSIVES_3D/User Library-2BA5532 5pin with wires.step

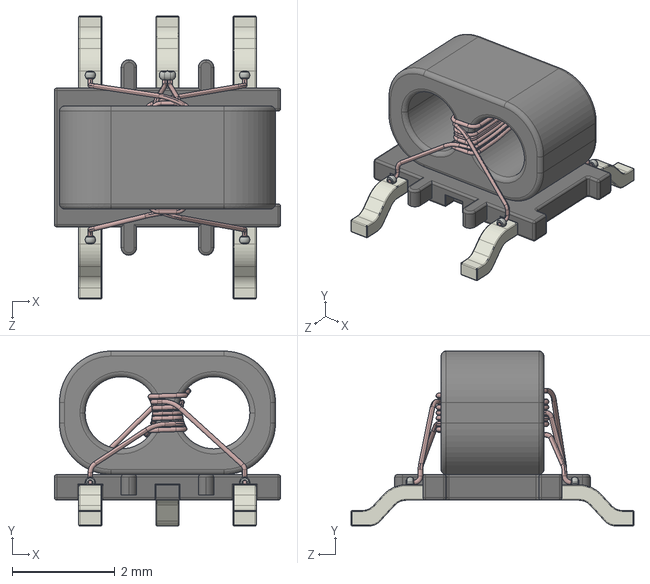
[picture p108: CAD file, 2024-12-15]
3dmodels/_PASSIVES_3D/User Library-2BA5532 5pin with wires.step
4.40 x 3.40 x 5.50 mm
