dohny1/kicad_libs/3dmodels/_SMD_SEMI_3D/BGA96C80P9X16_800X1400X120.step

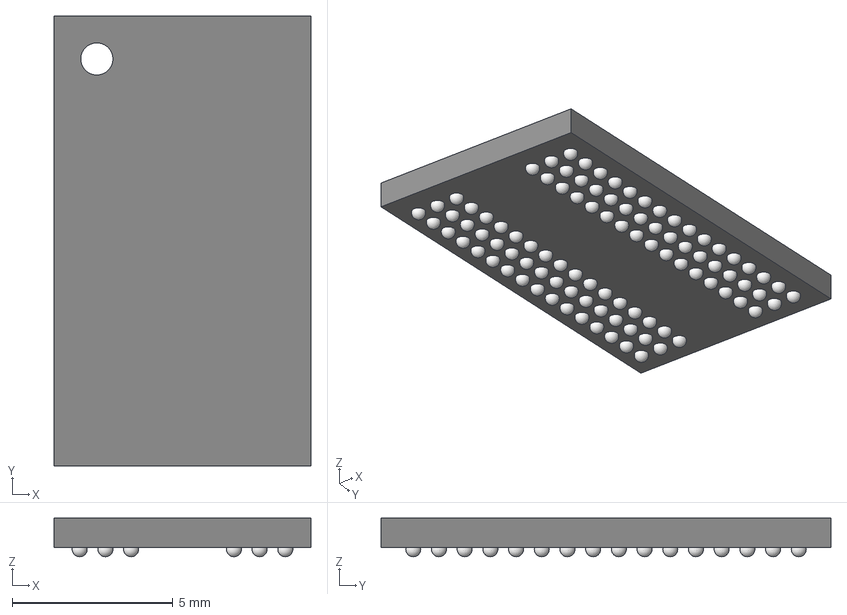
[picture p109: CAD file, 2024-12-15]
3dmodels/_SMD_SEMI_3D/BGA96C80P9X16_800X1400X120.step
8.00 x 14.0 x 1.20 mm
ball x 96
