dohny1/kicad_libs/3dmodels/_THT_3D/FAIRCHILD_GBU-H.stp

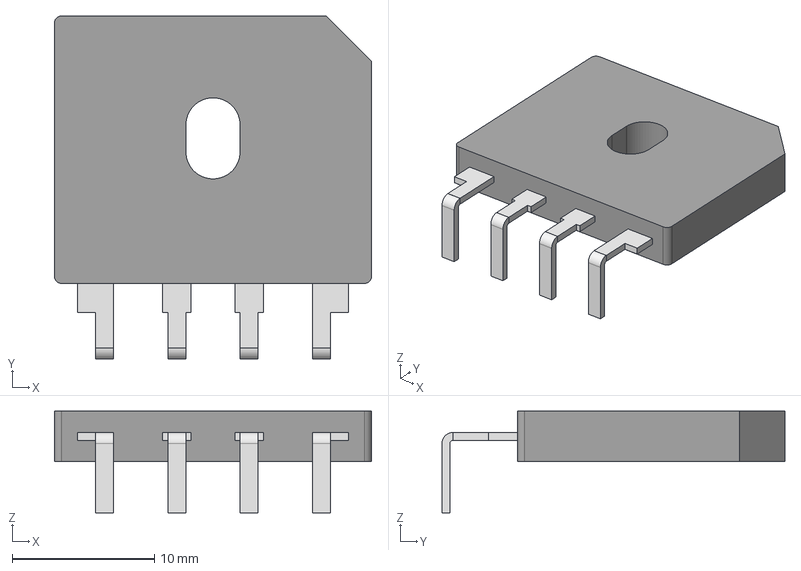
[picture p110: CAD file, 2024-12-15]
3dmodels/_THT_3D/FAIRCHILD_GBU-H.stp
22.3 x 24.1 x 7.16 mm
