dohny1/kicad_libs/3dmodels/_THT_CON_3D/User Library-PLD-xx.step

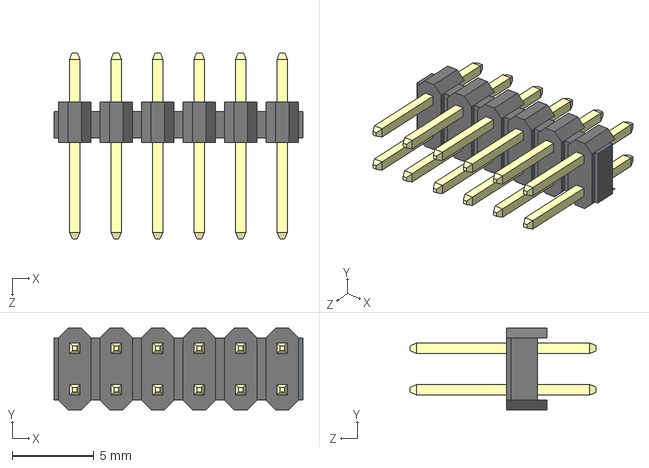
[picture p111: CAD file, 2024-12-15]
3dmodels/_THT_CON_3D/User Library-PLD-xx.step
15.2 x 5.00 x 11.4 mm
