dohny1/kicad_libs/3dmodels/_SMD_SEMI_3D/User Library-ADP5074.step

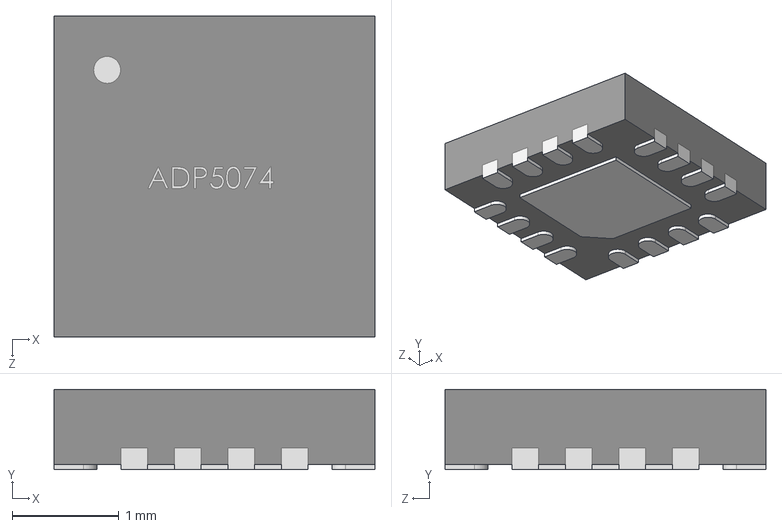
[picture p112: CAD file, 2024-12-15]
3dmodels/_SMD_SEMI_3D/User Library-ADP5074.step
3.00 x 0.75 x 3.00 mm
