dohny1/kicad_libs/3dmodels/_THT_3D/tea1_3d_drawing.stp

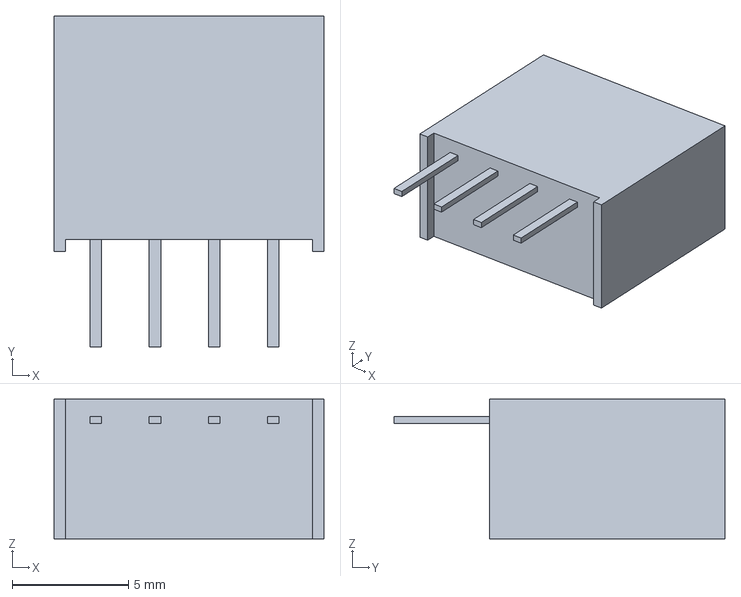
[picture p113: CAD file, 2024-12-15]
3dmodels/_THT_3D/tea1_3d_drawing.stp
11.6 x 14.2 x 6.00 mm
