dohny1/kicad_libs/3dmodels/_THT_CON_3D/nc4fah-0.STEP

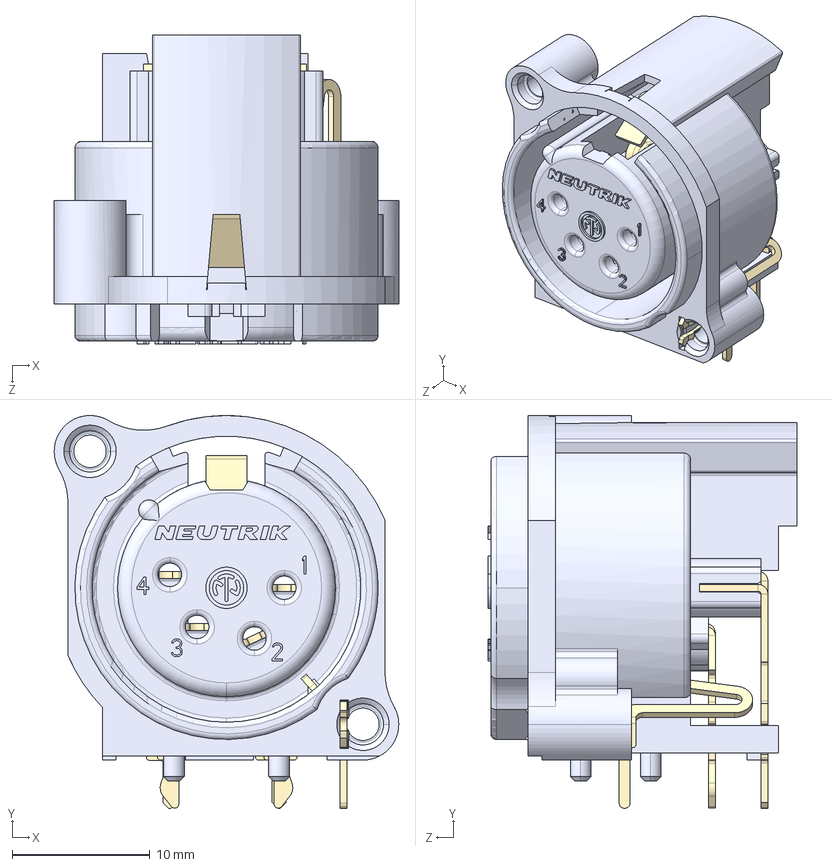
[picture p114: CAD file, 2024-12-15]
3dmodels/_THT_CON_3D/nc4fah-0.STEP
25.0 x 28.5 x 22.4 mm
