dohny1/kicad_libs/3dmodels/_SMD_SEMI_3D/SOT89.step

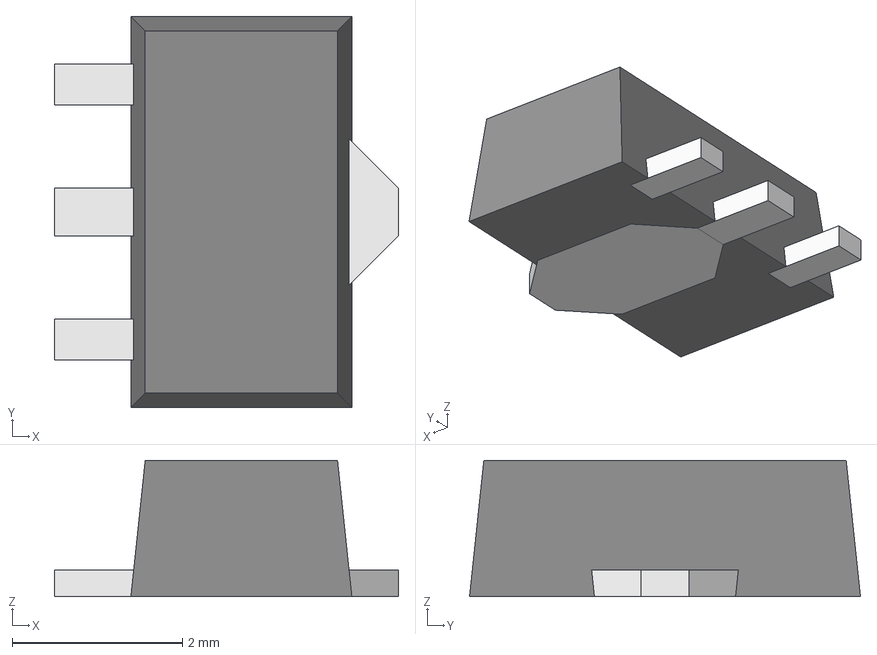
[picture p115: CAD file, 2024-12-15]
3dmodels/_SMD_SEMI_3D/SOT89.step
4.05 x 4.60 x 1.60 mm
top
bottom
