dohny1/kicad_libs/3dmodels/_THT_3D/User Library-TO220-AB-H PCB.step

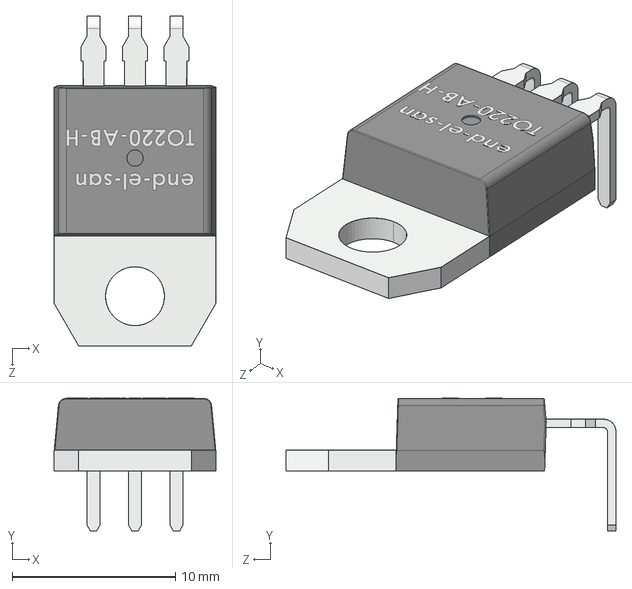
[picture p116: CAD file, 2024-12-15]
3dmodels/_THT_3D/User Library-TO220-AB-H PCB.step
9.90 x 8.13 x 20.2 mm
