dohny1/kicad_libs/3dmodels/_PASSIVES_3D/C0603_C0G.STEP

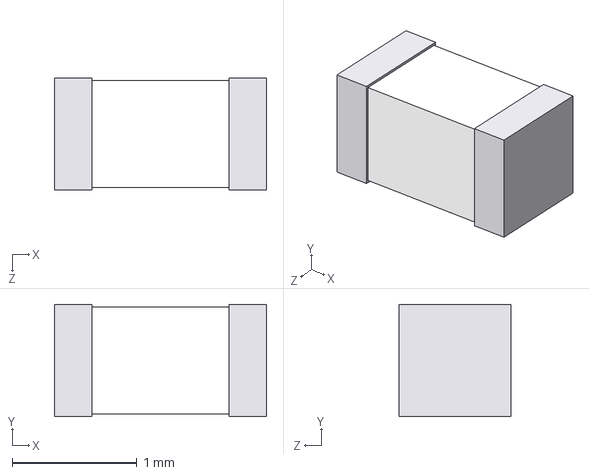
[picture p117: CAD file, 2024-12-15]
3dmodels/_PASSIVES_3D/C0603_C0G.STEP
1.70 x 0.9 x 0.9 mm
