dohny1/kicad_libs/3dmodels/_SMD_SEMI_3D/User Library-MAX_QSOP16.step

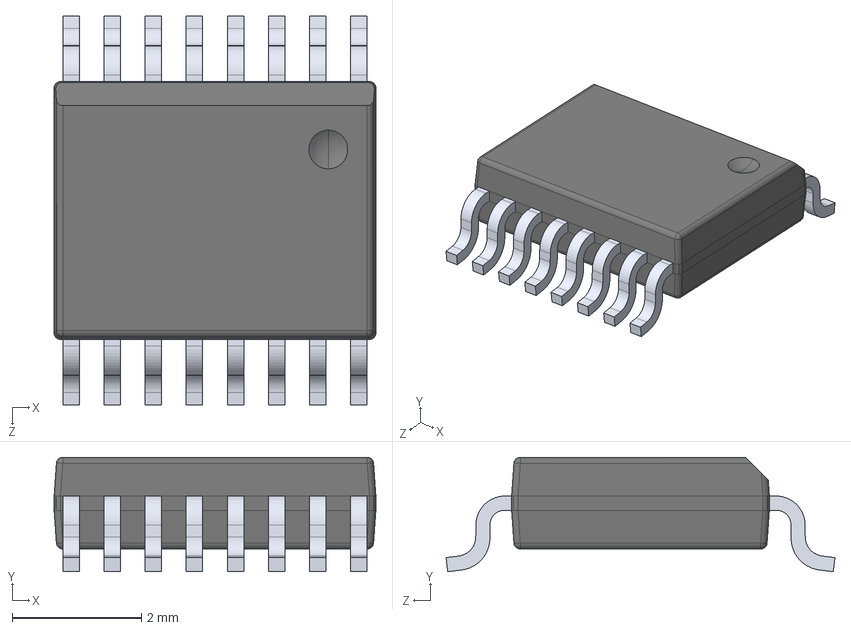
[picture p118: CAD file, 2024-12-15]
3dmodels/_SMD_SEMI_3D/User Library-MAX_QSOP16.step
4.98 x 1.77 x 6.02 mm
