dohny1/kicad_libs/3dmodels/_THT_3D/User Library-CAPPR500-1000x1200_330uF_16V.STEP

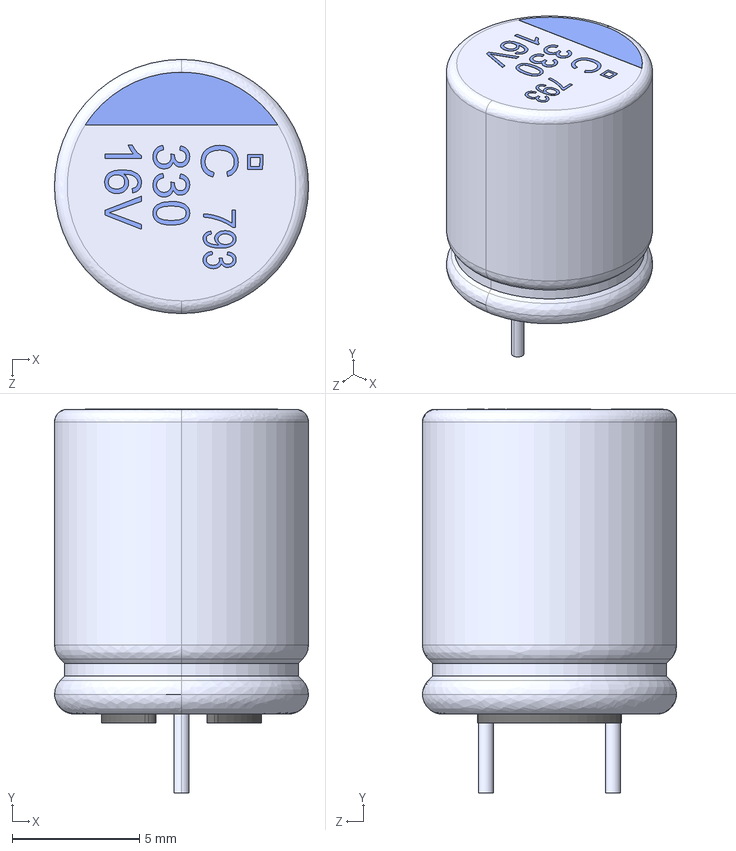
[picture p119: CAD file, 2024-12-15]
3dmodels/_THT_3D/User Library-CAPPR500-1000x1200_330uF_16V.STEP
10.0 x 15.1 x 10.0 mm
Rubber
Imported x 2
Text
