dohny1/kicad_libs/3dmodels/_THT_CON_3D/ph_2x7.STEP

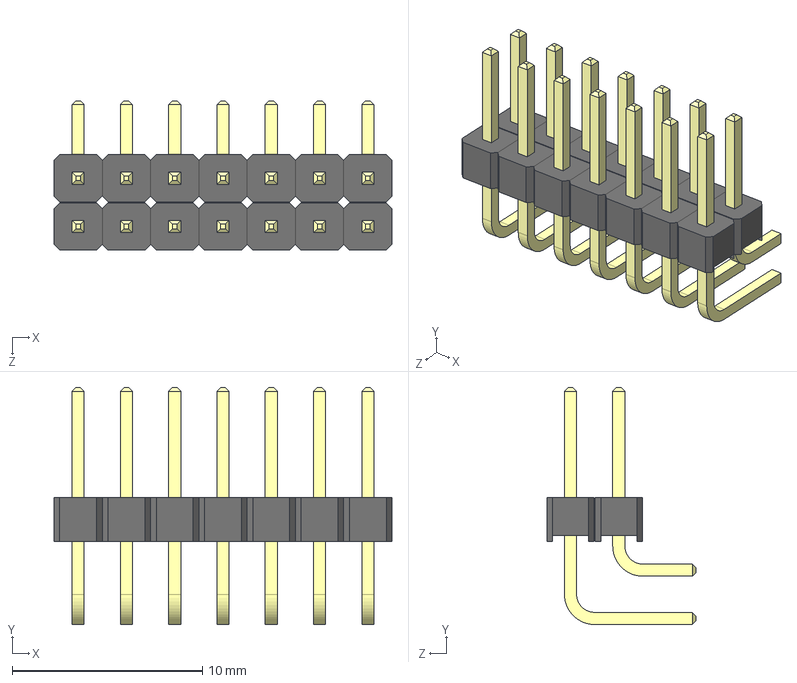
[picture p120: CAD file, 2024-12-15]
3dmodels/_THT_CON_3D/ph_2x7.STEP
17.8 x 12.5 x 7.86 mm
User Library-7Pin double right angle header_User Library-Header_Male_RA_Low_7Pin v4
User Library-7Pin double right angle header_User Library-Header_Male_RA_Low_7Pin_BodyArray1
User Library-7Pin double right angle header_User Library-Header_Male_RA_Low_7Pin_PinArray2
