dohny1/kicad_libs/3dmodels/_PASSIVES_3D/Ind_Murata_LQG15HN39NJ02D_eec.STEP

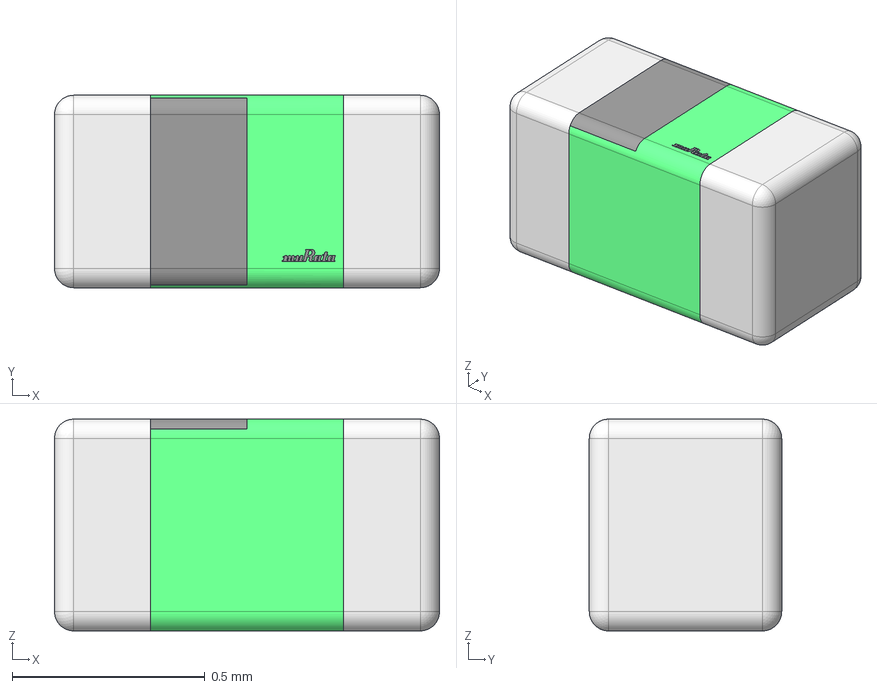
[picture p121: CAD file, 2024-12-15]
3dmodels/_PASSIVES_3D/Ind_Murata_LQG15HN39NJ02D_eec.STEP
1.00 x 0.5 x 0.55 mm
