dohny1/kicad_libs/3dmodels/_SMD_SEMI_3D/QFN40_5x5.step

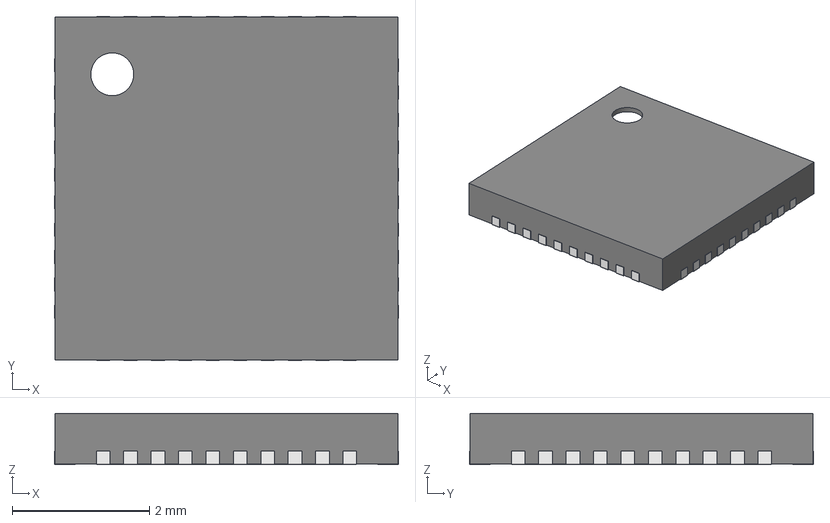
[picture p122: CAD file, 2024-12-15]
3dmodels/_SMD_SEMI_3D/QFN40_5x5.step
5.02 x 5.02 x 0.75 mm
Thermal_Shape
