dohny1/kicad_libs/3dmodels/_THT_3D/User Library-STONECOLD_HS-S03.step

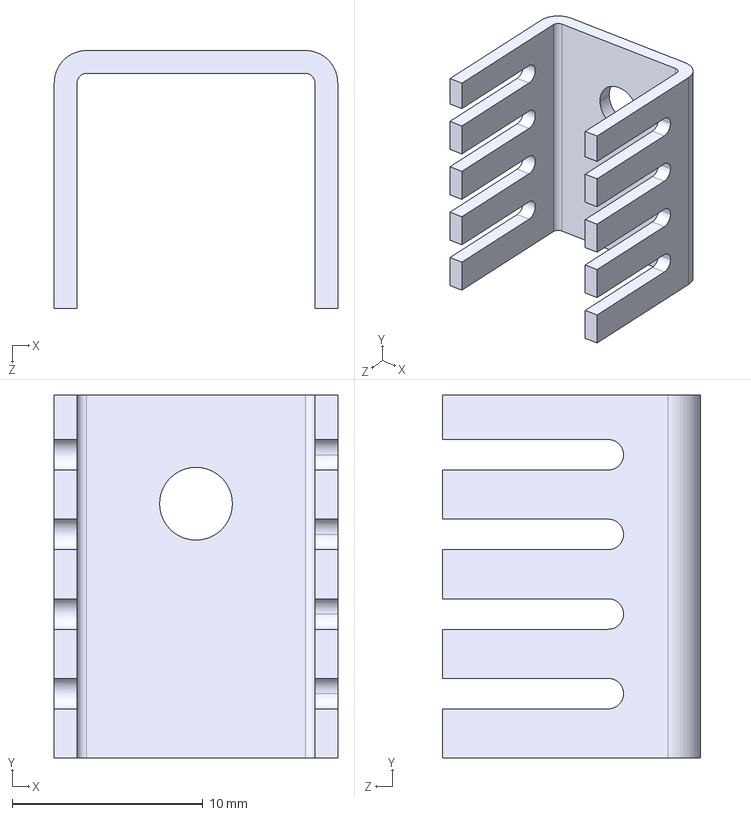
[picture p123: CAD file, 2024-12-15]
3dmodels/_THT_3D/User Library-STONECOLD_HS-S03.step
14.9 x 19.1 x 13.5 mm
