dohny1/kicad_libs/3dmodels/_PASSIVES_3D/CAP_0805.STEP

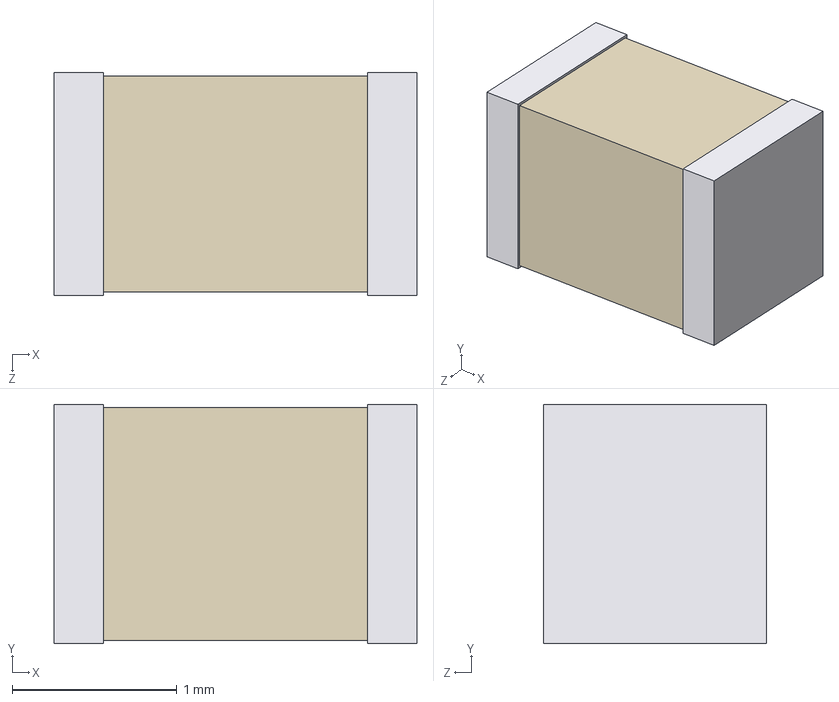
[picture p124: CAD file, 2024-12-15]
3dmodels/_PASSIVES_3D/CAP_0805.STEP
2.20 x 1.45 x 1.35 mm
