dohny1/kicad_libs/3dmodels/_SMD_SEMI_3D/SOP65P640X120-14N.stp

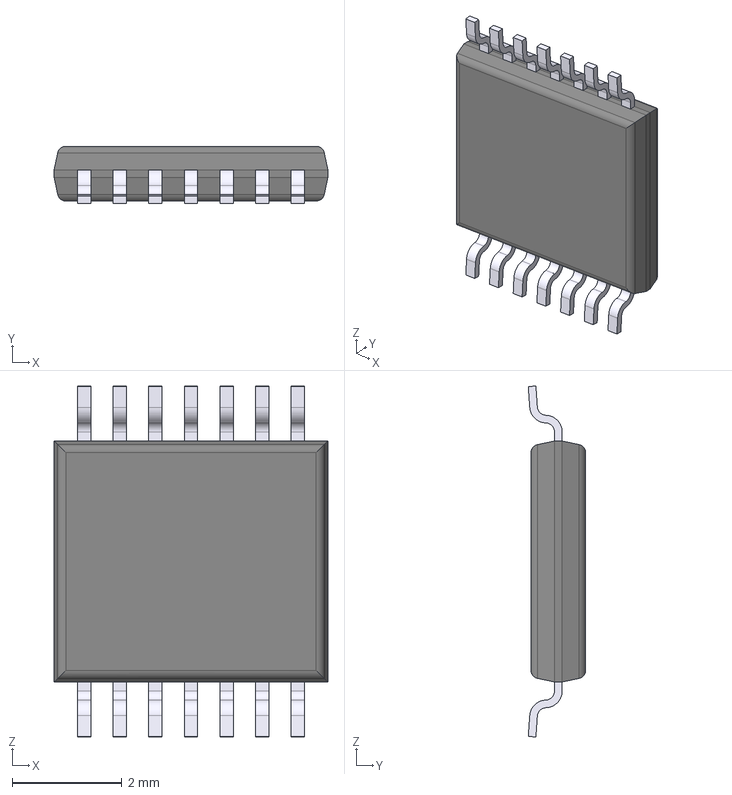
[picture p125: CAD file, 2024-12-15]
3dmodels/_SMD_SEMI_3D/SOP65P640X120-14N.stp
5.00 x 1.05 x 6.41 mm
