dohny1/kicad_libs/3dmodels/_THT_3D/User Library-DIP-28P-M04.step

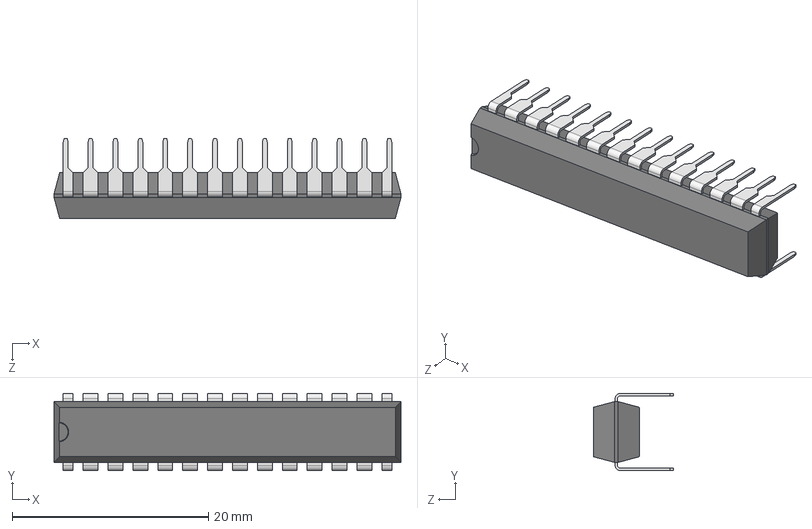
[picture p126: CAD file, 2024-12-15]
3dmodels/_THT_3D/User Library-DIP-28P-M04.step
35.4 x 7.87 x 8.20 mm
