dohny1/kicad_libs/3dmodels/_THT_CON_3D/User Library-TORX147PL(f,t).step

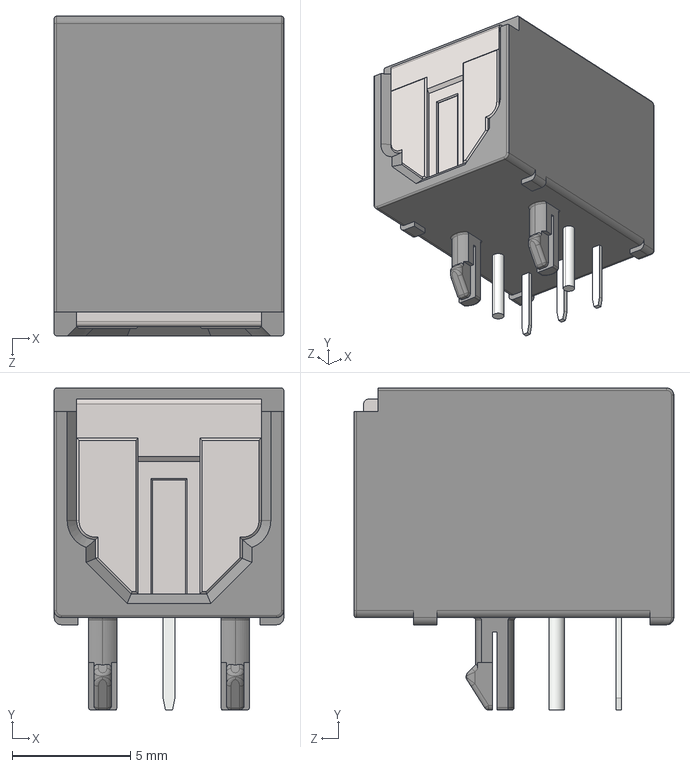
[picture p127: CAD file, 2024-12-15]
3dmodels/_THT_CON_3D/User Library-TORX147PL(f,t).step
9.70 x 13.6 x 13.5 mm
