dohny1/kicad_libs/3dmodels/_PASSIVES_3D/srn4012t-4r7m.stp

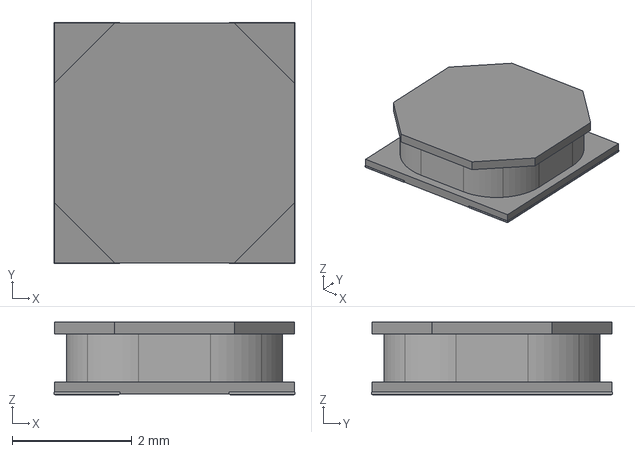
[picture p128: CAD file, 2024-12-15]
3dmodels/_PASSIVES_3D/srn4012t-4r7m.stp
4.02 x 4.02 x 1.21 mm
