dohny1/kicad_libs/3dmodels/_SMD_SEMI_3D/SOP65P780X200-28N.stp

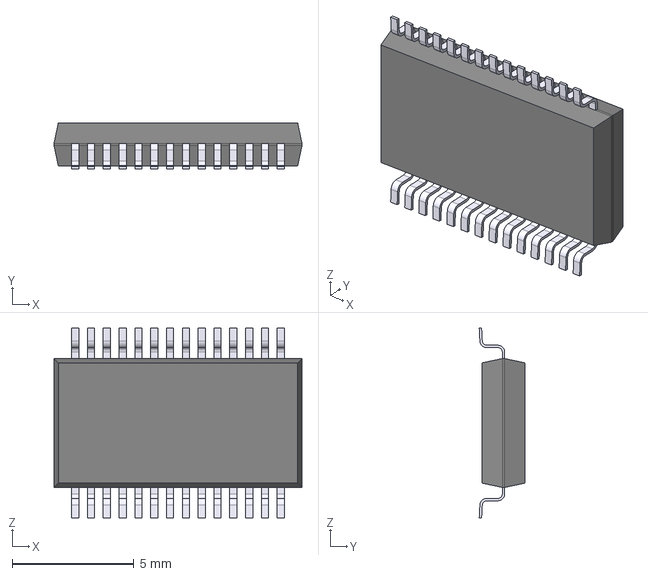
[picture p129: CAD file, 2024-12-15]
3dmodels/_SMD_SEMI_3D/SOP65P780X200-28N.stp
10.2 x 1.87 x 7.81 mm
