dohny1/kicad_libs/3dmodels/_THT_3D/I18.STEP

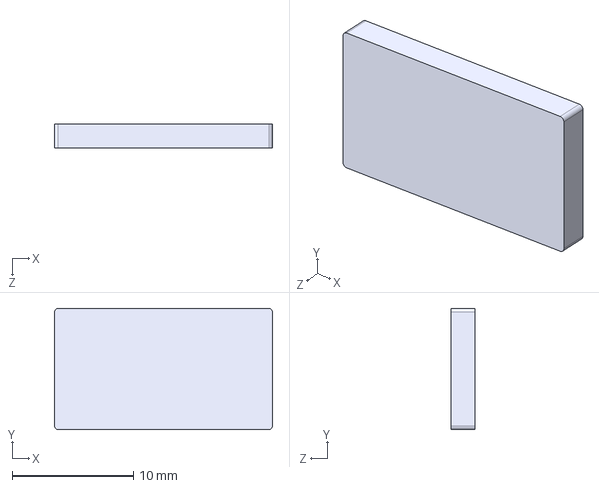
[picture p130: CAD file, 2024-12-15]
3dmodels/_THT_3D/I18.STEP
18.0 x 10.0 x 2.00 mm
