dohny1/kicad_libs/3dmodels/_THT_CON_3D/User Library-PLD-2x3.step

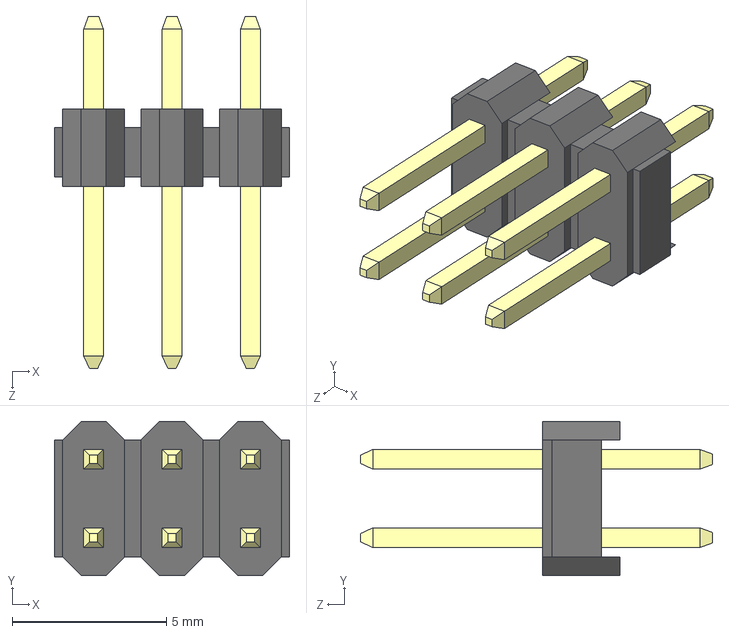
[picture p131: CAD file, 2024-12-15]
3dmodels/_THT_CON_3D/User Library-PLD-2x3.step
7.62 x 5.00 x 11.4 mm
