dohny1/kicad_libs/3dmodels/_SMD_SEMI_3D/User Library-DPAK-1.step

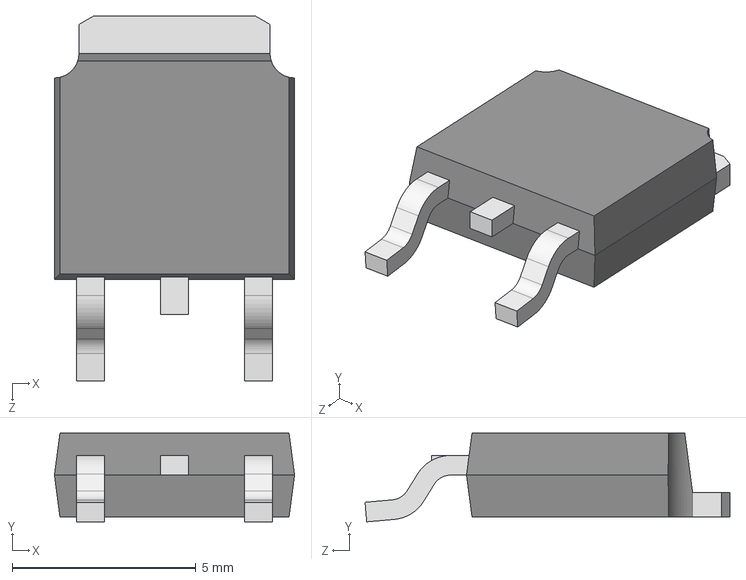
[picture p132: CAD file, 2024-12-15]
3dmodels/_SMD_SEMI_3D/User Library-DPAK-1.step
6.54 x 2.42 x 9.94 mm
