dohny1/kicad_libs/3dmodels/_THT_3D/User Library-DIP-14P-M02.step

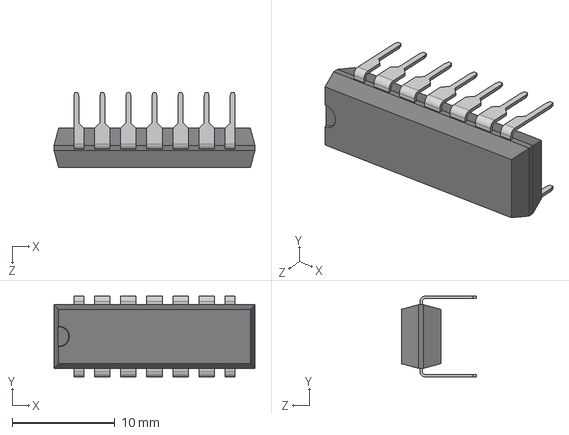
[picture p133: CAD file, 2024-12-15]
3dmodels/_THT_3D/User Library-DIP-14P-M02.step
19.6 x 7.87 x 7.36 mm
