dohny1/kicad_libs/3dmodels/_THT_CON_3D/usb_a-usb_a-e.stp

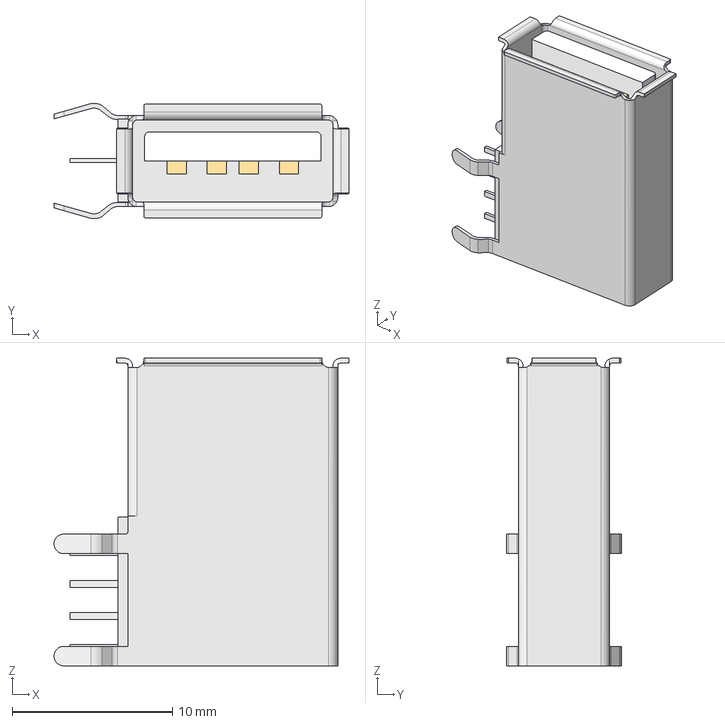
[picture p134: CAD file, 2024-12-15]
3dmodels/_THT_CON_3D/usb_a-usb_a-e.stp
18.4 x 7.20 x 19.2 mm
