dohny1/kicad_libs/3dmodels/_PASSIVES_3D/User Library-CaseB_3528-21.step

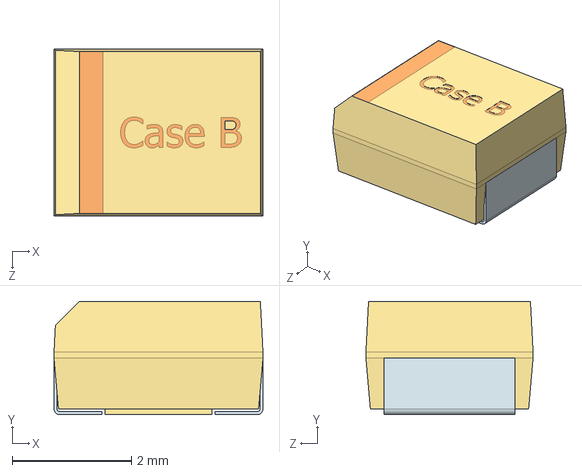
[picture p135: CAD file, 2024-12-15]
3dmodels/_PASSIVES_3D/User Library-CaseB_3528-21.step
3.50 x 1.90 x 2.80 mm
