dohny1/kicad_libs/3dmodels/_SMD_SEMI_3D/QFN24_MAX77751.step

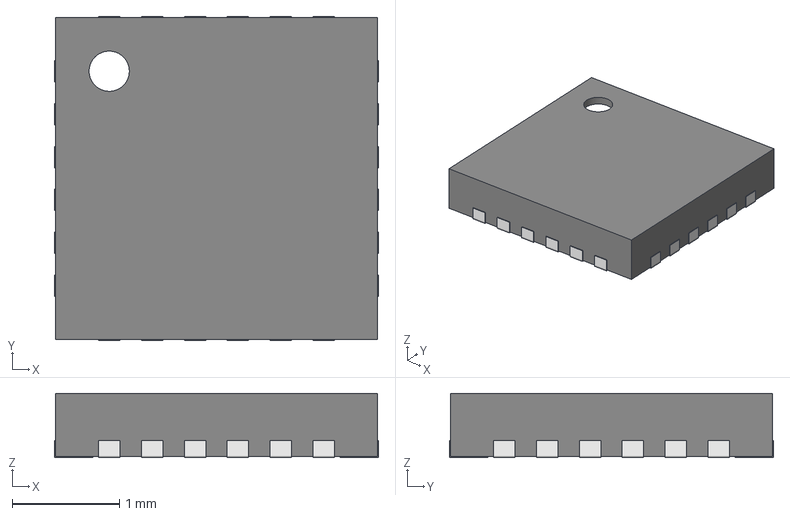
[picture p136: CAD file, 2024-12-15]
3dmodels/_SMD_SEMI_3D/QFN24_MAX77751.step
3.02 x 3.02 x 0.6 mm
