dohny1/kicad_libs/3dmodels/_THT_3D/wima_50_72_100.STEP

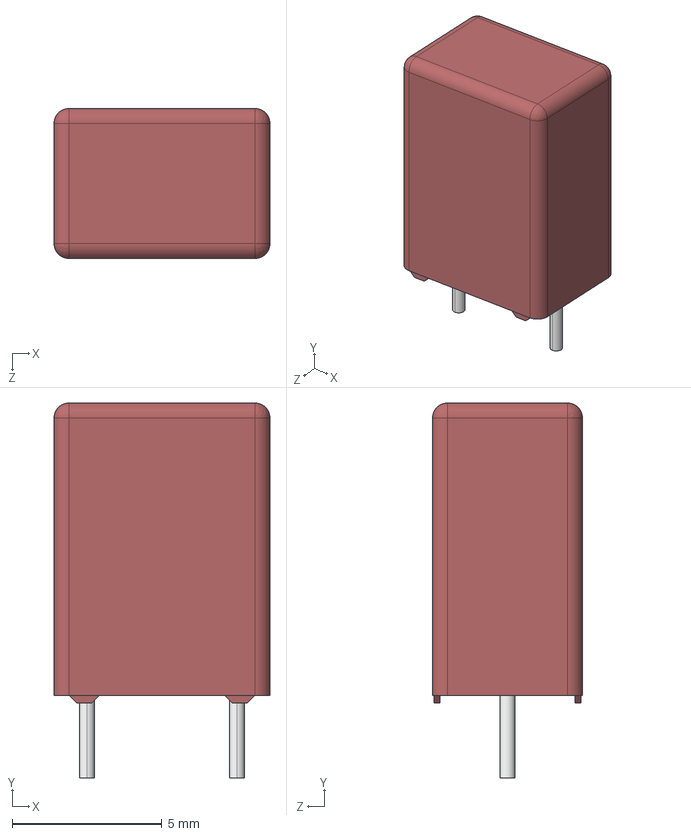
[picture p137: CAD file, 2024-12-15]
3dmodels/_THT_3D/wima_50_72_100.STEP
7.20 x 12.5 x 5.00 mm
User Library-CAPRR500W50L720T500H1000_WIMA_1F_Body
User Library-CAPRR500W50L720T500H1000_WIMA_1F_Lead x 2
