dohny1/kicad_libs/3dmodels/_THT_CON_3D/BNC_normal.STEP

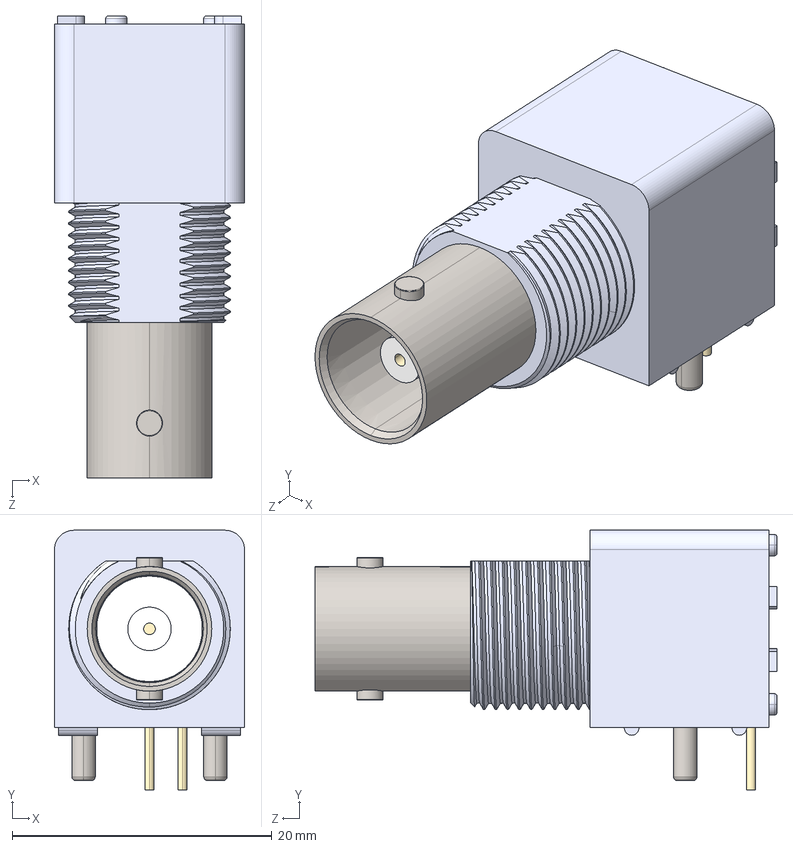
[picture p138: CAD file, 2024-12-15]
3dmodels/_THT_CON_3D/BNC_normal.STEP
14.7 x 20.0 x 35.6 mm
