dohny1/kicad_libs/3dmodels/_PASSIVES_3D/User Library-INDM2520X190N.step

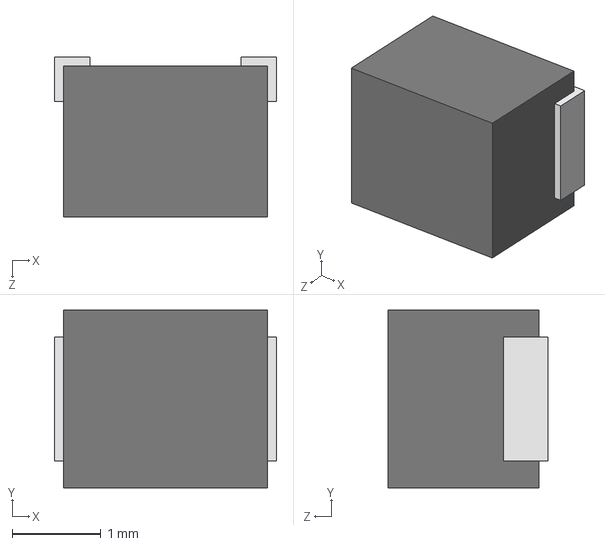
[picture p139: CAD file, 2024-12-15]
3dmodels/_PASSIVES_3D/User Library-INDM2520X190N.step
2.50 x 2.00 x 1.80 mm
