dohny1/kicad_libs/3dmodels/_SMD_SEMI_3D/UQFN12.step

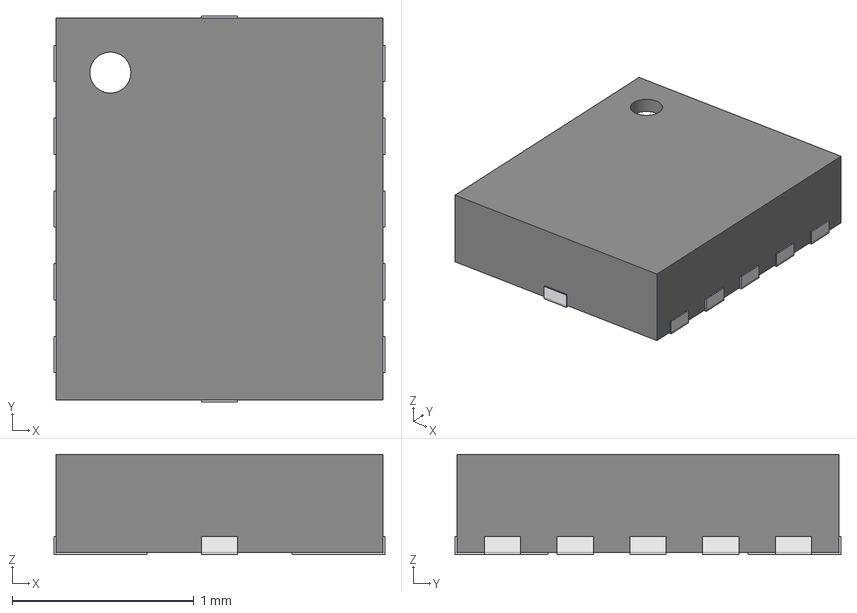
[picture p140: CAD file, 2024-12-15]
3dmodels/_SMD_SEMI_3D/UQFN12.step
1.82 x 2.12 x 0.55 mm
