dohny1/kicad_libs/3dmodels/_THT_3D/MDIP-24-X1.stp

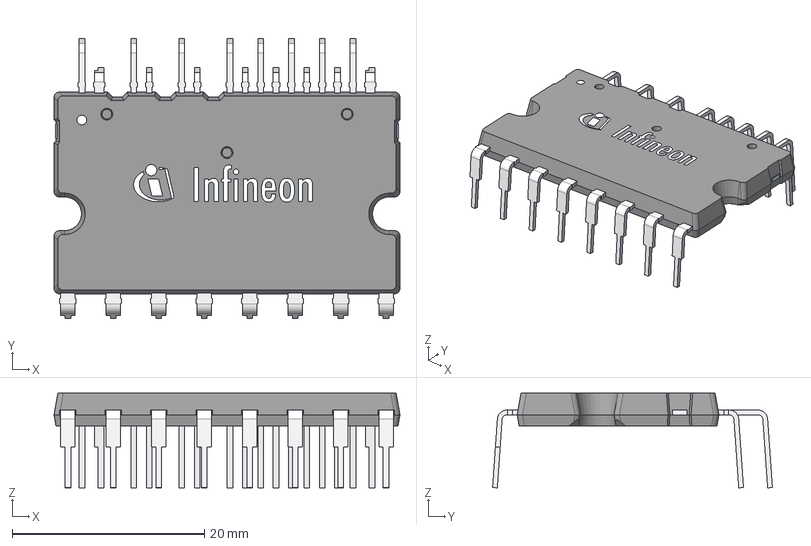
[picture p141: CAD file, 2024-12-15]
3dmodels/_THT_3D/MDIP-24-X1.stp
36.0 x 29.1 x 9.86 mm
