dohny1/kicad_libs/3dmodels/_THT_CON_3D/User Library-3220-10-0100.STEP

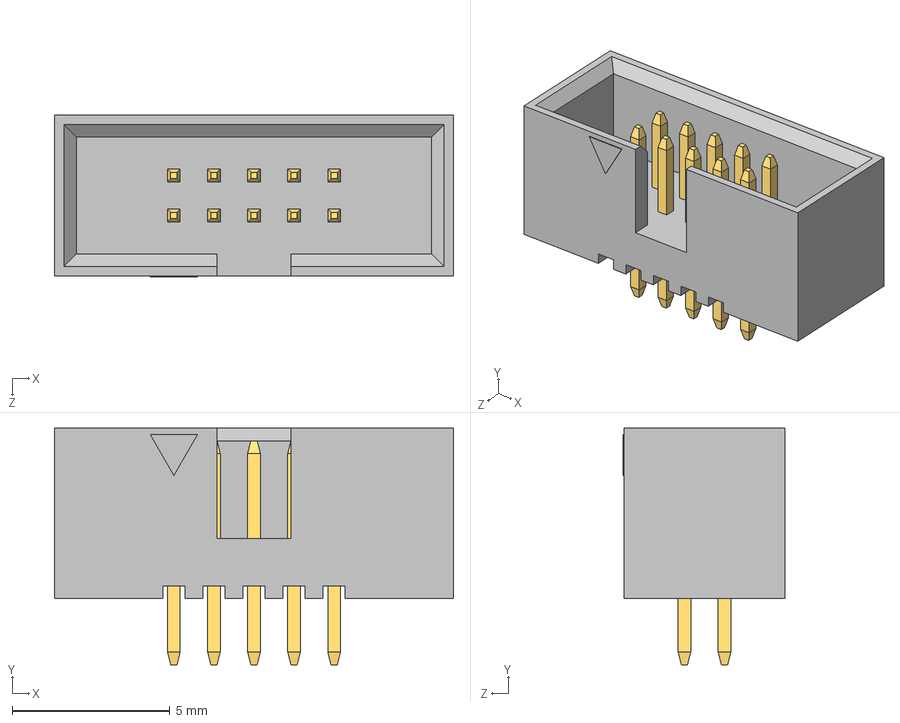
[picture p142: CAD file, 2024-12-15]
3dmodels/_THT_CON_3D/User Library-3220-10-0100.STEP
12.6 x 7.50 x 5.13 mm
00-H
00-T-180
