dohny1/kicad_libs/(list of files, cad)

Other CAD files:
3dmodels/_PASSIVES_3D/R0603_tf.STEP
3dmodels/_PASSIVES_3D/C0402_C0G.STEP
3dmodels/_PASSIVES_3D/R1206_tf.STEP
3dmodels/_THT_CON_3D/User Library-BNC-144_GB-142_Default.sldprt
3dmodels/_THT_CON_3D/RCA_B1.STEP
3dmodels/_PASSIVES_3D/R0402_tf.STEP
3dmodels/_PASSIVES_3D/0805AF.STEP
3dmodels/_PASSIVES_3D/C0805_C0G.STEP
3dmodels/_PASSIVES_3D/CAP_0603.STEP
3dmodels/_PASSIVES_3D/INDC3216X12N.step
3dmodels/_PASSIVES_3D/Ind_Murata_LQP03HQ0N5B02D_eec.STEP
3dmodels/_PASSIVES_3D/RES 0805 (2012 metric).STEP
3dmodels/_PASSIVES_3D/RESCAXS50P32X16X70-8N.STEP
3dmodels/_PASSIVES_3D/User Library-Crystal_ECX-32.STEP
3dmodels/_PASSIVES_3D/User Library-SRN6045 Series.step
3dmodels/_SMD_CON_3D/10038075-A1PLF--3DModel-STEP-554624.STEP
3dmodels/_SMD_CON_3D/10144517-062x0xxx.stp
3dmodels/_SMD_CON_3D/10144517-082802LF--3DModel-STEP-533217.STEP
3dmodels/_SMD_CON_3D/10144518-062x0xxx.stp
3dmodels/_SMD_CON_3D/10144518-082802LF--3DModel-STEP-533217.STEP
3dmodels/_SMD_CON_3D/tact4.5mm.x_t
3dmodels/_SMD_SEMI_3D/150066M153000.stp
3dmodels/_SMD_SEMI_3D/ARTIX-7s-FTG256.step
3dmodels/_SMD_SEMI_3D/CSP_BGA64.step
3dmodels/_SMD_SEMI_3D/DFN24.step
3dmodels/_SMD_SEMI_3D/DFN6-3x3_1.step
3dmodels/_SMD_SEMI_3D/DFN8_2x2.step
3dmodels/_SMD_SEMI_3D/DIOM5336X240N.stp
3dmodels/_SMD_SEMI_3D/IC_Analog_Devices_ADSP-21565KSWZ8_eec.STEP
3dmodels/_SMD_SEMI_3D/IC_STMicroelectronics_MP34DT05TR-A_eec.STEP
3dmodels/_SMD_SEMI_3D/MSOP10.step
3dmodels/_SMD_SEMI_3D/QFN20.step
3dmodels/_SMD_SEMI_3D/QFN32-5x5.step
3dmodels/_SMD_SEMI_3D/QFN32_5X5.step
3dmodels/_SMD_SEMI_3D/QFN56_8X8.step
3dmodels/_SMD_SEMI_3D/QFN72_10X10.step
3dmodels/_SMD_SEMI_3D/SOD-523F.STEP
3dmodels/_SMD_SEMI_3D/SOD123.STEP
3dmodels/_SMD_SEMI_3D/SOD80.stp
3dmodels/_SMD_SEMI_3D/SOIC-16.STEP
3dmodels/_SMD_SEMI_3D/SOIC-8.STEP
3dmodels/_SMD_SEMI_3D/SON10_2x2.step
3dmodels/_SMD_SEMI_3D/SON10_MAXIM.step
3dmodels/_SMD_SEMI_3D/SON8.step
3dmodels/_SMD_SEMI_3D/SOT223-4.STEP
3dmodels/_SMD_SEMI_3D/SOT23-3.STEP
3dmodels/_SMD_SEMI_3D/SOT23-5.STEP
3dmodels/_SMD_SEMI_3D/SOT323.STEP
3dmodels/_SMD_SEMI_3D/SSOP20.step
3dmodels/_SMD_SEMI_3D/TQFP64.step
3dmodels/_SMD_SEMI_3D/TSSOP20.step
3dmodels/_SMD_SEMI_3D/TSSOP28.step
3dmodels/_SMD_SEMI_3D/UDFN6_2x2.step
3dmodels/_SMD_SEMI_3D/User Library-7W_TXC.step
3dmodels/_SMD_SEMI_3D/User Library-DFN-10.STEP
3dmodels/_SMD_SEMI_3D/User Library-DHVQFN 16.step
3dmodels/_SMD_SEMI_3D/User Library-LED_0603_G.STEP
3dmodels/_SMD_SEMI_3D/User Library-MLP55-27L.STEP
3dmodels/_SMD_SEMI_3D/User Library-MSOP-8-1.step
3dmodels/_SMD_SEMI_3D/User Library-Mini-Flat Package (Avago).STEP
3dmodels/_SMD_SEMI_3D/User Library-P-LQFP48-7x7-0_50.STEP
3dmodels/_SMD_SEMI_3D/User Library-PWSON-N10_1EPThermalVia_4_1x4_1mm_P0_8mm.STEP
3dmodels/_SMD_SEMI_3D/User Library-QFN28-0_5.STEP
3dmodels/_SMD_SEMI_3D/User Library-QFN56_0_4.step
3dmodels/_SMD_SEMI_3D/User Library-SOD323-1.step
3dmodels/_SMD_SEMI_3D/User Library-TDSON-8.STEP
3dmodels/_SMD_SEMI_3D/User Library-US8 Package_(8US8_8SM8_8DSBGA)_2_4x2_1x0_9.SLDPRT
3dmodels/_SMD_SEMI_3D/WSON8_8x6.step
3dmodels/_SMD_SEMI_3D/micropack-6.STEP
3dmodels/_THT_3D/744823601_M.stp
3dmodels/_THT_3D/INDRD_WURTH_WE-TI.stp
3dmodels/_THT_3D/PS_cap700.STEP
3dmodels/_THT_3D/SK 657.STEP
3dmodels/_THT_3D/SPUN02.STEP
3dmodels/_THT_3D/TRIM_BOURNS_3296Y.stp
3dmodels/_THT_3D/User Library-CAPPR350-800x1150_270uF_16V.STEP
3dmodels/_THT_3D/User Library-CAPRR250W40L460T550H1000_WIMA_0F.STEP
3dmodels/_THT_3D/User Library-CCF50_10K0_b5.STEP
3dmodels/_THT_3D/User Library-CH25-2032.step
3dmodels/_THT_3D/User Library-CapAluRadial_D100H200.STEP
3dmodels/_THT_3D/User Library-CapAluRadial_D160H315.STEP
3dmodels/_THT_3D/User Library-DIP-16P-M03.step
3dmodels/_THT_3D/User Library-DIP-28P-M05.step
3dmodels/_THT_3D/User Library-FILM_GREY_P2250L2650W1050H1850PD80.step
3dmodels/_THT_3D/User Library-FKP2 1nF-100 FKP2D011001D00.SLDPRT
3dmodels/_THT_3D/User Library-FTR-B4C.step
3dmodels/_THT_3D/User Library-R-Axial-0_25W-10_16.step
3dmodels/_THT_3D/User Library-SWITCH, TACTILE, RIGHT ANGLE, 12VDC, 50MA, 6_85MM ACTUATOR, WEALTH METAL TC-0244Z.step
3dmodels/_THT_3D/User Library-Snap-in 35X45-P10.step
3dmodels/_THT_3D/User Library-TO-126 (SOT32) Grey PCB.step
3dmodels/_THT_3D/User Library-TO220-A PCB.step
3dmodels/_THT_3D/User Library-TORX147PL(f,t).SLDPRT
3dmodels/_THT_3D/wima5.5x7.2.STEP
3dmodels/_THT_3D/wima_55_72_115.STEP
3dmodels/_THT_CON_3D/1803303.stp
3dmodels/_THT_CON_3D/1871058-1.stp
3dmodels/_THT_CON_3D/2pin_SUPPLY.stp
3dmodels/_THT_CON_3D/61200621621.stp
3dmodels/_THT_CON_3D/61201021621.stp
3dmodels/_THT_CON_3D/61202021621.stp
3dmodels/_THT_CON_3D/614004190021.stp
3dmodels/_THT_CON_3D/670688000.stp
3dmodels/_THT_CON_3D/87831-1020.stp
3dmodels/_THT_CON_3D/AC3MAH-AU-PRE.x_t
3dmodels/_THT_CON_3D/AV1-8.4-8B_black.STEP
3dmodels/_THT_CON_3D/GSB191111K1H9HR--3DModel-STEP-554624.STEP
3dmodels/_THT_CON_3D/HR911130A.STEP
3dmodels/_THT_CON_3D/User Library-TORX147PL(f,t).SLDPRT
