dohny1/kicad_libs/template/Edgeberry_Cartridge/Hardware_Cartridge_Design_Guide.pdf

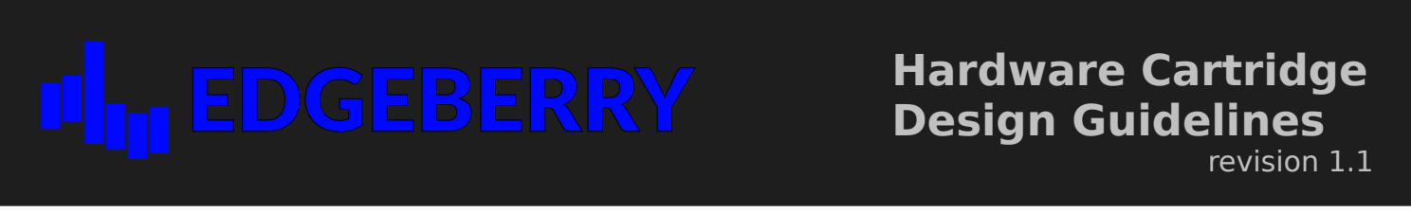
[picture p143: figure]
Hardware Cartridge Design Guidelines; revision 1.1
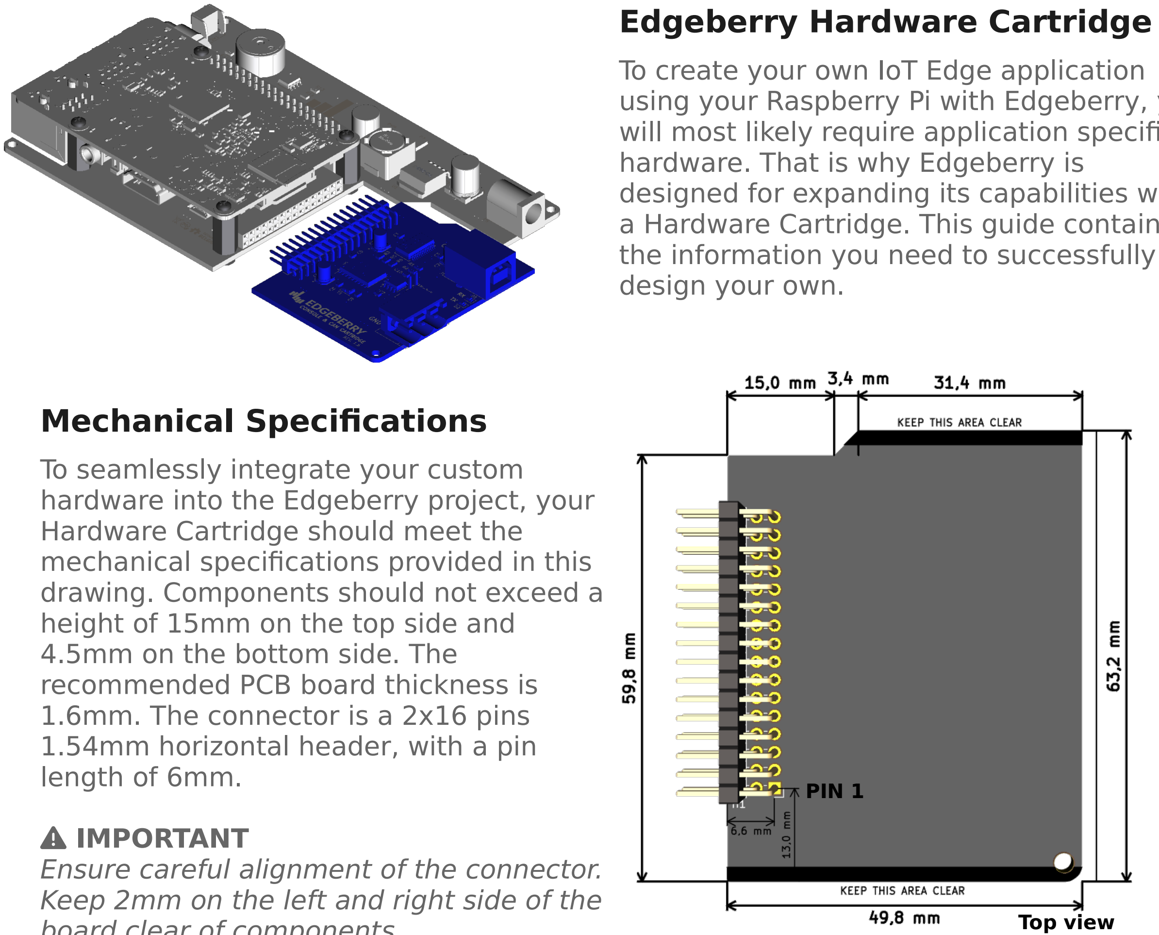
[picture p144: figure]
Edgeberry Hardware Cartridge; To create your own IoT Edge application; hardware. That is why Edgeberry is; design your own.; Mechanical Specifications; To seamlessly integrate your custom; Hardware Cartridge should meet the; drawing. Components should not exceed a height of 15mm on the top side and 4.5mm on the bottom side. The recommended PCB board thickness is 1.6mm. The connector is a 2x16 pins 1.54mm horizontal header, with a pin length of 6mm.; ⚠ IMPORTANT; PIN 1

using your Raspberry Pi with Edgeberry, you will most likely require application specific

designed for expanding its capabilities with a Hardware Cartridge. This guide contains the information you need to successfully

hardware into the Edgeberry project, your

mechanical specifications provided in this

Ensure careful alignment of the connector.
Keep 2mm on the left and right side of the
board clear of components | Top view

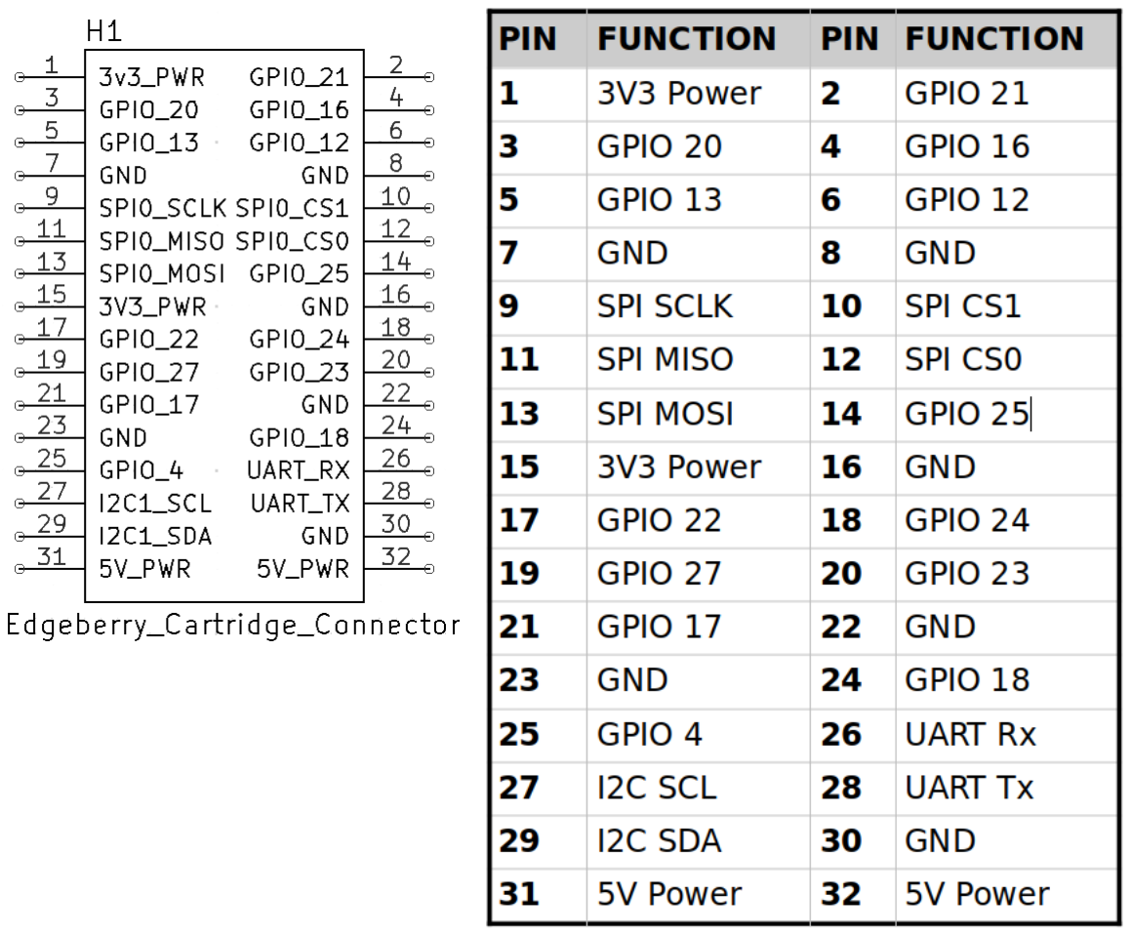
[picture p145: figure]

### Electrical Specifications

| The Edgeberry expansion connector for
| the Hardware Cartridge exposes the
| remaining unused pins of the Raspberry
| Pi, providing direct access to the UART,
| I2C, and SPI interfaces, as well as several
| GPIO pins. The 3.3V power is supplied by
| the Raspberry Pi, while the 5V power is
| directly connected to Edgeberry's robust
| power supply. When designing a circuit
| that draws current at 3.3V, it is
| recommended to use the 5V power in
| conjunction with your own voltage
regulator.
