dohny1/kicad_libs/(list of files, drawings)

Other design files:
footprints/_altium/SMD_CON.PcbLib
footprints/_altium/SMD_PASSIVES.PcbLib
symbols/_altium/Connectors.SchLib
symbols/_altium/Digital IC.SchLib
symbols/_altium/Discrete Semi.SchLib
symbols/_altium/Electro-mechanical.SchLib
symbols/_altium/Mechanical.SchLib
symbols/_altium/Mixed Signal ICs.SchLib
symbols/_altium/OPAs and Amplifiers.SchLib
symbols/_altium/Other.SchLib
symbols/_altium/Passives.SchLib
symbols/_altium/Power Regs.SchLib
symbols/_altium/Sensors.SchLib
