dohny1/kicad_libs/(commit log)

2024-12-25 choke 3D added
    [RN102-x-02.stp]
2025-02-05 added 7seg
    [D7SEG-0.56.step, L-25x25.step, TSF-1178Z.STEP]
