dohny1/kicad_libs/(notices)

Notices in the files:
3dmodels/_THT_CON_3D/PinHeader_2x05_P1.27mm_Vertical.step:
Copyright (C) 2017, kicad StepUp
This work is licensed under the [Creative Commons CC-BY-SA 4.0 License](https://creativecommons.org/licenses/by-sa/4.0/legalcode),
with the following exception:
To the extent that the creation of electronic designs that use 'Licensed Material' can be considered to be 'Adapted Material',
You are free to use the library data in your own projects without the obligation to share your project files under this or any other license agreement.
3dmodels/_SMD_CON_3D/QTE-020-01-F-D.stp:
FILE_NAME( 'p:/temp/worker_12/temp/exporttempdir_1920_129_9HKK9/format_0/QTE-020-01-F-D.stp', '2021-05-05T07:25:04', ( 'License CC BY-ND 4.0' ), ( 'CADENAS' ), ' ', 'PARTsolutions', ' ' );
